2AMLogic/gf180-gate-driver/layout/README.md

# layout — `gate_driver_core` physical layout

First physical layout for the block. It is **generated, not hand-drawn**:
`gate_driver_core.gds` is the byte-reproducible output of running
[`gen_gate_driver_core.py`](gen_gate_driver_core.py) against
[`../design/netlist/gate_driver_core.spice`](../design/netlist/gate_driver_core.spice)
and the gf180mcu PDK, with every polygon produced by `klt`
([klayout-tools](https://github.com/2AMLogic/klayout-tools), this repo's stated
layout tooling).

```
layout/
  gate_driver_core.gds              the layout database (top cell: gate_driver_core)
  gate_driver_core.provenance.json  what it was built from, and by what
  gate_driver_core.checks.json      the checks below, as run on the committed GDS
  gen_gate_driver_core.py           the generator
  check_gate_driver_core.py         the checker
  ground_rail_negative_control.py   known-good/known-bad control for the
                                    ground_rail_isolation check (#132)
  build/                            generator scratch (gitignored)
  common/report_id.py               shared <record-id> minting for the run scripts
  common/power_array_folded.py      folded, cross-row-tied high-m power-array
                                    generator (#254). Kept on purpose for future
                                    power-stage growth; nothing in this block
                                    imports it yet -- see "Folded power-array
                                    generator" below
  common/test_power_array_folded.py unit tests for the above (PDK-free CI;
                                    keeps the kept-on-purpose module tested)
  drc/                              klt drc runner + committed reports (#105)
  lvs/                              klt extract/lvs runner, reference netlist,
                                    extracted DUT netlists, committed reports (#105)
  erc-supply-spec.json              the T1 item-11 klt erc supply spec (#238)
  erc/                              klt erc runner + committed reports (#238)
```

## Status: LVS-match; DRC-clean under the current 34-layer deck (#362, after #358's 1513 violations)

The block now includes all three sub-cells the schematic instantiates —
`level_shifter`, `output_stage`, and (issue #221) `uvlo` (UVLO comparator +
reference, including its bias-resistor network) — not just the first two.

| | |
|---|---|
| Device list matches the schematic | yes — 35 netlist devices → 1769 transistors, the 4-deep `XCCOMP*` MiM series stack, and (#221) 271 `ppolyf_u` resistor primitives, verified |
| Gate/source/drain connectivity matches | yes — verified device-by-device against the netlist |
| Compensation capacitor drawn | **yes (#166)** — four `cap_mim_2f0_m4m5_noshield` plates in series, 5.0 × 5.0 µm each, on the process-fixed Metal4-FuseTop-Metal5 pair; extracted, LVS-matched, and its three interior nodes asserted floating ([below](#the-xccomp-mim-compensation-stack-166)) |
| `uvlo` bias-resistor network drawn | **yes (#221)** — `Rref`/`R1`/`R2`/`Rfb`, each a `klt gen res_array` block of series `ppolyf_u` unit resistors sized to the schematic's own ohms value ([`resistor_array_params`](gen_gate_driver_core.py)); extracted and LVS-matched |
| 3.3 V and 5 V/6 V devices in separate DNWELL regions | yes — verified geometrically (DRM 7.2) |
| DRC | **clean under the current deck (#362).** `status: clean`, 0 violations, klt `0.7.1.dev2599+geaf26f00df36`, deck hash `sha256:0eb6df1b…` (34 layers), report [`20261024-090822-de97a29`](drc/reports/gate_driver_core/20261024-090822-de97a29.drc.json). This is the curated deck's verdict only: the `_MV` rule columns (`DF.6_MV`, `DV.*`, `NW.*_MV`, …) are `unmodeled_rules`, so it is **not** a medium-voltage signoff ([triage](drc/triage_sab_implant.md), [DRC](#drc-klt-drc)) |
| LVS-clean | yes — `status: match`, 2044/2044 devices, 295/295 nets, 25/25 pins, **1 warning-only finding below (unrelated to body ties)** |
| Bulk/body terminals tied | **yes, both flavors (#132)** — every one of the 1769 drawn transistors has a real, drawn, contacted body tie to the schematic's own net (`VDD_LOGIC`/`VDD_DRV` for the 664 PMOS, the deck's global substrate identity for the 1105 NMOS). `klt lvs`'s `device.body_unverified` finding is **gone entirely**, not just reduced (see [Known gaps](#known-gaps) for how the two grounds now compare — revised by issue #221) |
| Post-layout simulation | **pending re-verification against this GDS (issue #222)** — the committed PVT-grid records under `sim/gate-driver-core-drive-postlayout/` were extracted from the pre-#221 (level_shifter + output_stage only) GDS; re-running them against the uvlo-extended extracted netlist is explicitly the next slice of #219, not this issue's scope. Issue #362 regenerated the GDS under the current klt, whose `klt gen` cells differ in size and carry their own implants and body taps, so the extracted parasitics are no longer the pre-#221 ones either: that re-run is still pending, still owed to #222, and was **not** done by #362. [Below](#post-layout-simulation) still describes that pre-#221 evidence as what it is |

The LVS verdict is real (it has a committed negative control, below), and the
old DRC verdict was real *for the rules that deck shipped*, but neither is a
tapeout signoff, and the DRC one no longer holds under the current deck: the deck does not carry rules for this layout's
well/marker layers, and the DRC deck cannot check the guard ring's own
geometry (only its *presence*, drawn to satisfy DN.3 by inspection). Read
"[What the DRC verdict covers](#what-the-drc-verdict-covers)" and "[What the
LVS verdict covers](#what-the-lvs-verdict-covers)" before quoting either.

## Regenerating

```bash
python3 layout/gen_gate_driver_core.py     # rewrites gate_driver_core.gds + provenance
python3 layout/check_gate_driver_core.py --report layout/gate_driver_core.checks.json
```

The generator needs `klt` on `PATH` and a resolvable gf180mcu install (it uses
`klt pdk find`'s resolver — the same one `sim/env.sh` reports). It links
nothing itself: it is standard-library Python that shells out to `klt`.
Re-running it on the same inputs reproduces the GDS **byte for byte**, so
`gate_driver_core.provenance.json`'s `sha256` is a checkable claim, not a
decoration. That cuts both ways: a change to the generator source must leave
`provenance.generator.sha256` matching `sha256sum layout/gen_gate_driver_core.py`,
even when the stream itself is unchanged — otherwise the record names a
generator that is no longer in the tree.

To look at it:

```bash
klayout layout/gate_driver_core.gds       # or: klt render layout/gate_driver_core.gds
klt stats layout/gate_driver_core.gds --per-layer
klt cells layout/gate_driver_core.gds
```

## How it is built

1. **Flatten.** The three sub-cells `level_shifter` (`x1`), `output_stage`
   (`x2`) and (issue #221) `uvlo` (`x3`) are flattened into one device list
   carrying top-level net names, plus one bare-`R` resistor list for `uvlo`'s
   own bias network (`Rref`/`R1`/`R2`/`Rfb`). Internal sub-cell nets keep an
   `x1_`/`x2_`/`x3_` prefix (`x1_nca`, `x2_n3`, `x3_ndiv`, …).
2. **Devices — `klt gen mos_array`, once per netlist device.** A device with
   `W=W nf=N m=M` is drawn as a single unit device folded into `N*M` parallel
   gate fingers of width `W/N` each (`finger_topology: "parallel"`), which is
   exactly what those parameters mean in SPICE: `M` copies of one `W`-wide
   transistor whose width is itself split across `N` fingers, all sharing one
   source, drain and gate strap. `klt extract` reads them back as `N*M`
   parallel transistors, so the layout's transistor count equals the
   netlist's (1769) rather than 35, and the total drawn width is `W*M`
   whatever `N` is.

   Both halves of that handoff are load-bearing and both are confirmed rather
   than assumed (issue #129): SPICE's `W` is a *total* width split across `nf`
   fingers (gf180mcu's model cards pass `w=w nf=nf` into the BSIM core and
   size their drift resistors on `w/nf`; this netlist's own `ad`/`ps`
   expressions use `W/nf`), while `klt gen mos_array`'s `w_um` is the
   *per-finger* width — a `"parallel"` unit device is "one folded transistor
   of width `fingers * w_um`" ([`docs/cli/gen.md`][klt-gen]). Every device in
   the committed netlist has `nf=1`, so this is `M` fingers of width `W` and
   the committed GDS is unaffected;
   [`test_gen_gate_driver_core.py`](test_gen_gate_driver_core.py) pins the
   `nf>1` arithmetic against hand-computed values so a future netlist edit
   that folds a device cannot silently draw an `N`×-too-wide transistor.

[klt-gen]: https://github.com/2AMLogic/klayout-tools/blob/main/docs/cli/gen.md
3. **Resistors — `klt gen res_array`, once per netlist `R` element (issue
   #221).** `uvlo`'s `Rref`/`R1`/`R2`/`Rfb` state an ideal ohms value with no
   drawn geometry, so [`resistor_array_params`](gen_gate_driver_core.py)
   folds each into `num` series `ppolyf_u` unit resistors (gf180mcu's base
   350 Ω/sq poly resistor, `klt gen res_array`'s only flavor this deck
   implements) sized to reproduce that exact value.
4. **Wiring + markers — `klt draw`, once.** One flat cell carrying the Metal2
   net rails, the Metal1 stubs and gate routes, the Via1 stack between them,
   the net-name labels, the voltage-domain marker geometry, every PMOS
   device's well-tie tap, the PCOMP guard ring (#132 — see
   "[Body ties and guard ring](#body-ties-and-guard-ring-132)" below), the
   `XCCOMP*` MiM capacitor stack (#166 — see
   "[The XCCOMP MiM compensation stack](#the-xccomp-mim-compensation-stack-166)"),
   and (issue #221) `uvlo`'s bias-resistor escape wiring — see
   "[Resistor network](#resistor-network-uvlo-221)" below.
5. **Composition — `klt gen-compose`** with `placement.strategy: "explicit"`,
   merging the 35 device cells, the 4 resistor cells and the wiring cell into
   one `gate_driver_core` top cell at the origins steps 2/3 computed.

### Floorplan

Every device is a left-aligned horizontal strip; strips stack upward in
netlist order — the four thin-oxide 3.3 V devices first, then a 20 µm domain
gap, then the thirty-one thick-oxide 5 V/6 V devices (up from twenty pre-#221:
`output_stage`'s ten plus `uvlo`'s own eleven MOSFETs, one of them — `MPD`,
the OUT pulldown — folded `m=800`, by far the widest single strip in the
block). `mos_array` puts a strip's source pad on its left edge, its drain pad
on its right edge and its gate pad on its top edge, which gives a
router-free orthogonal wiring scheme:

- net rails run **vertically on Metal2**, in a channel left of the strips
  (sources and gates) and a channel right of them (drains);
- a **Metal1** stub runs horizontally out of each pad to its rail and drops a
  **Via1**; a gate route leaves the top of its strip and crosses the empty
  channel above it to the left rail;
- each net's left and right rail are tied by one horizontal **Metal1** jumper
  in a cross-over band above the whole stack.

Metal1 stubs therefore pass *under* unrelated Metal2 rails with no via, which
is what keeps the scheme short-free without a router — except for the one
place that stopped being true once `MPD`'s 800-finger fold made the device
column ~900 µm wide (issue #221): a resistor's own escape wire back to its
net's rail is drawn on **Metal3**, not Metal1, specifically because a
same-layer Metal1 crossing against some device's own now-block-wide drain
stub is no longer confined to "empty" territory — see
"[Resistor network](#resistor-network-uvlo-221)" below for the incident this
was fixed against. The result is 1643.84 × 714.78 µm (plus the resistor
column further east, outside that box's own device-rail footprint) —
dominated by `x3_XMPD`, the 800-finger `uvlo` pulldown.

### Resistor network (`uvlo`, #221)

`Interconnect.resistors()` in
[`gen_gate_driver_core.py`](gen_gate_driver_core.py) wires each placed
`res_array` block into its netlist net: a short Metal1 jumper chains
consecutive series units using the block's own reported per-unit pin
coordinates (never a flat run across a whole multi-unit row, which shorts the
chain — see the method's own docstring for the incident that taught this),
and each chain's two open ends drop clear of the block, cross onto Metal3 via
a local Via1/Via2 stack, and run back to the target net's own rail on Metal3
before a final Via2 merges onto the rail. That last leg is Metal3
specifically because the device column is now wide enough (`MPD`'s 800-finger
fold, ~900 µm) that a same-layer Metal1 run back to a rail is no longer
"empty" territory to cross — a first pass drawn on Metal1 shorted `uvlo`'s own
`GND_DRV` to the unrelated level-shifter net `x1_inb`, and a second pass that
moved *only* the horizontal leg to Metal3 but kept a full-height Metal3
*vertical* drop at every end shorted five different nets together instead
(`GND_DRV`/`VDD_DRV`/`x3_ndiv`/`x3_nref`/`x3_uvlo_ok`) — confirmed against
real `klt lvs` runs both times. Every end's entire Metal3 footprint now stays
inside its own narrow, structurally-distinct y-band (no vertical leg at all,
just a landing at the rail's own y), which is what makes two ends'
geometry unable to collide by construction rather than by inspection.

### Body ties and guard ring (#132)

`Interconnect.body_ties()`/`Interconnect.guard_ring()` in
[`gen_gate_driver_core.py`](gen_gate_driver_core.py) draw the substrate/well
tap and PCOMP guard-ring geometry this issue tracks. Every one of the 1769
drawn transistors gets its own tap, and the guard ring is closed and
grounded. What each one does, and the one real (not a layout gap) limitation
that remains, follows from reading `klayout-tools`' own
`extract.py`/`decks/gf180mcu.py` rather than assuming:

- **PMOS well ties — real, per-device, and verified.** Every PMOS device gets
  its own Comp+Nplus+Contact+Metal1 tap, positioned just outside its own
  bbox, inside a redundant Nwell rectangle sized to merge with `klt gen
  mos_array`'s own internal well once flattened, and wired to the device's
  own `VDD_LOGIC`/`VDD_DRV` rail. The Nplus layer is not decorative: gf180mcu's
  curated deck has no distinct tap mask, so a bare Comp+Contact+Metal shape
  inside Nwell is geometrically indistinguishable from ordinary PMOS
  source/drain diffusion and is **not** derived into a tap at all — confirmed
  empirically (a first pass of this generator without the Nplus layer still
  extracted every PMOS body onto its own anonymous net, unchanged). Adding it
  invokes the deck's `tap_nplus` derivation (klayout-tools issue #1084):
  `tap_nplus & active & nwell` reads as a genuine well tie. Since every PMOS
  device's Nwell island is geometrically independent (11 separate, non-
  touching islands — no well-merge geometry across devices), each ties to its
  *own* device's real body net with no cross-device or cross-domain merge
  risk. Confirmed against a real `klt extract` run: `unbiased_pmos_body_nets`
  drops from 660 entries to zero.
- **NMOS substrate ties — real, per-device, and drawn for both domains.**
  Every NMOS device gets its own Comp+Pplus+Contact+Metal1 tap, wired to its
  own group's ground rail (`GND_LOGIC` for the four 3.3 V devices,
  `GND_DRV` for the thirty-one 5 V/6 V devices, up from twenty pre-#221,
  whose taps land inside their own `LVPWELL` patch). `klt`'s gf180mcu deck
  still ties *every* NMOS body, in every layout, to one hardcoded global
  identity (`ExtractionDeck.substrate_net`, via KLayout's `connect_global`)
  regardless of which DNWELL/LVPWELL region a device's diffusion sits in —
  confirmed by reading `extract.py` directly, filed upstream as a generic
  tool gap (klayout-tools
  [#1128](https://github.com/2AMLogic/klayout-tools/issues/1128), per
  CLAUDE.md's friction protocol) — so a real tap drawn anywhere merges
  *every* NMOS body (both domains) onto that one identity. **Issue #221
  update:** under the `klt` build now installed, that identity surfaces
  under the literal name `GND_LOGIC` alone — `GND_DRV` does **not** also
  merge into it (or into `GND_LOGIC`) on any *ordinary* (non-body) terminal.
  An earlier revision of this section (and of `lvs/make_reference.py`)
  claimed the opposite, based on a real extraction of the pre-#221 GDS
  against `klt` 0.2.0; re-running that *exact, byte-identical* GDS against
  the currently-installed build (a different `provenance.deck.content_hash`)
  no longer reproduces the merge — a known, already-tracked `klayout-tools`
  deck-behavior drift (issue
  [#1149](https://github.com/2AMLogic/klayout-tools/issues/1149)). This also
  matches `spec/decision-records/0001` Decision 1 better than the old
  assumption did: the two grounds are one electrical reference node only via
  a pad ring this bare core block does not itself draw (option (c),
  genuinely isolated grounds, was considered and rejected at the *decision*
  level, but a pad-ring tie — not a body-tie side effect — is how that
  decision is meant to be realized). The net effect on body verification is
  unchanged either way: `klt lvs`'s `device.body_unverified` finding is
  **fully resolved** for NMOS, not merely downgraded — a real `klt lvs` run
  against this geometry reports **zero** `device.body_unverified`
  mismatches, on either flavor, at both the pre-#221 and the current device
  count. See "[What the LVS verdict covers](#what-the-lvs-verdict-covers)"
  for the counts, and `lvs/make_reference.py`'s transform 3 for how the
  reference models the body identity now (and `layout/lvs/mk_extracted_dut.py`'s
  T4 for how it is rebound again for simulation, so the testbench still has
  a net literally named `GND_LOGIC`/`GND_DRV` to drive).

  `GND_LOGIC` and `GND_DRV` are, and always were, drawn as separate Metal2
  nets that stay separate in the drawn interconnect end to end, which
  `check_gate_driver_core.py`'s [`ground_rail_isolation`](#why-ground_rail_isolation-exists-132)
  check verifies independently of the extractor's substrate-identity model —
  `klt components` over Metal1/Via1/Metal2 only, net names off the Metal2 text
  layer, no deck globals. That check is the only signal for a real short
  between the two domains that depends on nothing but the drawn metal — `klt
  lvs` and the `devices` check can see one too now that the rails extract
  separately (above), but only for as long as the deck keeps behaving that
  way, and #1149 is the demonstration that it need not; DRC cannot see one at
  all, because two overlapping same-layer shapes raise no spacing violation.
  So it carries its own known-good/known-bad control —
  `ground_rail_negative_control.py` — exactly like the DRC and LVS verdicts
  do.
- **PCOMP guard ring — closed, and contacted on two of its four strokes.** A
  closed rectangular Comp+Pplus ring around `DNWELL_DRV`, offset far enough
  out to leave a real, non-touching gap from both `DNWELL_DRV`'s own marker
  and every well-tie tap (so neither `klt drc` nor
  `check_gate_driver_core.py`'s `dnwell_partition` check folds it into either
  side's component count), and pushed further north than that margin alone
  would place it when the 5 V/6 V group's own bbox sits flush against the
  whole device stack's top edge — clearing `jumpers()`'s own Metal1 band
  (every net's cross-over jumper, drawn above the stack) rather than
  threading a contact row through the narrow gaps between individual jumper
  bars (DN.3 sets no *maximum* ring-to-DNWELL distance, so this is always a
  safe direction to move). The **north and south strokes carry a contact
  row** on a regular pitch, strapped on Metal1 to the 3.3 V group's own
  `GND_LOGIC` rail — this block's substrate reference, since the 3.3 V
  devices sit directly on native substrate outside every DNWELL. The **east
  and west strokes carry no contacts**: every 5 V/6 V device's source, gate
  and drain stub leaves the domain horizontally on Metal1 and crosses those
  two strokes, so a Metal1 strap along them would short all of them
  together. Comp and Metal1 do not interact without a Contact bridging them,
  so the crossings themselves are harmless — the strokes are tied through
  the ring's own continuous p+ diffusion instead of through metal, which
  keeps the ring closed (DN.3) and grounded, at a higher tie resistance on
  the two vertical strokes than a fully-strapped ring would have.
  Distributing contacts along them needs a Metal2 crossover per stub, i.e. a
  routing-channel redesign — recorded as a residual gap below rather than
  bolted on here.

### The XCCOMP MiM compensation stack (#166)

`Interconnect.mim_caps()` draws the level shifter's feedforward compensation
capacitor — since issue #192 /
[decision record 0014](../spec/decision-records/0014-xccomp-mim-density-and-series-stack.md),
**four** `cap_mim_2f0_m4m5_noshield` devices in series (`XCCOMP1`..`XCCOMP4`),
5.0 µm × 5.0 µm each. It is drawn as plain `klt draw` rectangles rather than by
a generator: `klt gen` ships no capacitor generator (`klt gen --list`:
`mos_array`, `diff_pair`, `guard_ring`, `res_array`, `esd_device`, `bjt_array`,
`bond_pad`, `resistor_strip`), which is the friction this device ran into.
What makes the rectangles a *device* rather than decoration is that every layer
is one `klt`'s own gf180mcu **extraction** deck recognises this capacitor on
(`decks/gf180mcu.py`'s `EXTRACTION_DECK.capacitors`, transcribed from the PDK's
own `mimcap_extraction.lvs`): FuseTop (75/0) top plate, `CAP_MK` (117/5) +
`MIM_L_MK` (117/10) recognition markers, Metal4 (46/0) bottom plate, Via4
(41/0) to Metal5 (81/0) on top.

**The metal pair is not a layout choice.** `gf180mcuD` is a 5-metal DRM
Option-B build, so `topmin1_metal` *is* Metal4 and the MiM sits on
Metal4-FuseTop-Metal5 and nowhere else (`../design/level-shifter-partition.md`,
corrected by #194 — the older "deferred to layout" note was wrong).

**Series topology: every interior node is a shared plate.** The four
capacitors alternate orientation, so the three internal nodes need no via at
all:

```
                nccomp1                       nccomp3
             (Metal5 strap)                (Metal5 strap)
            +--------------+              +--------------+
            |              |              |              |
  x1_ncb --[C1]          [C2]           [C3]           [C4]-- IN_DRV
  (Metal4)   |              |              |              |    (Metal4)
             +--------------+--------------+              |
                        nccomp2                           |
                  (one Metal4 polygon:                     `-- Metal4 stub
                   C2 and C3's bottom                          -> Via3
                   plates, bridged)                            -> Metal3
                                                                -> Via2
                                                                -> Metal2 rail
```

That is what makes `nccomp1`/`nccomp2`/`nccomp3` **floating by construction
rather than by inspection** — the correctness risk #166 called out. Each one is
a single metal polygon carrying two capacitor plates and nothing else: no via
lands on it, no strap reaches it, there is no shield around it. There is no
geometry that *could* tie one of them to something, so "did we accidentally
strap a floating node?" has a structural answer here, not only a visual one.
Both chain ends therefore come out on Metal4 and escape the same way, through
Via3 → Metal3 → Via2 down to the Metal2 rail their net already has.

The Via4s that contact the top plates do not short them to the bottom plates
either, and that is the extractor's own model rather than an assumption: `klt
extract` cuts each top-plate Via4's overlap with the recognised bottom plate
out of the generic Via4 connectivity, precisely so a DRM-legal MiM stack does
not read as a plate-to-plate short.

**DRM 10.4.2 "MIM Option B" rules honoured.** Three of them the curated DRC
deck actually checks, and the run below is clean against all three; the rest
are honoured because the DRM states them, whether or not a deck reads them
today:

| Rule | What it asks | How this layout meets it | Checked by `klt drc`? |
|---|---|---|---|
| MIMTM.1 | 1.2 µm bottom-plate spacing to adjacent bottom-plate or routing Metal4 | row pitch is 6.2 + 1.2 µm; the only other Metal4 anywhere in the block is each end plate's own escape stub, part of that plate's own polygon | yes — `mim.space.1` (including its peer-to-peer "adjacent MiM" half) |
| MIMTM.2 | 0.4 µm *virtual* bottom-plate overlap of Via4 | Via4 sits at the plate centre, ~2.97 µm inside | yes — `mim.enclosing.via4.1` |
| MIMTM.3 | 0.6 µm bottom-plate overlap of the top plate | the Metal4 plate is the 5.0 µm FuseTop plate grown by exactly 0.6 µm on all four sides ⇒ 6.2 × 6.2 µm | yes — `mim.enclosing.fusetop.1` |
| MIMTM.5 | 0.4 µm top-plate overlap of Via4 | ~2.37 µm | no rule in this deck |
| MIMTM.8a | 25 µm² minimum MiM area | 5.0 × 5.0 = 25 µm² exactly, taken from the netlist's own `c_width`/`c_length` and asserted by the generator rather than assumed | no rule in this deck |
| MIMTM.10 | "Via(n−2)" (Via3, on this 5LM stack) may not touch the bottom plate | an end plate's Via3 sits on a stub 4.35 µm from the plate centre — outside the DRM's own *virtual* bottom plate (FuseTop sized by 1.06 µm ∩ Metal4, i.e. a 7.12 µm square) | no rule in this deck |
| §10.4.2 guidance | no matching-sensitive analog circuitry underneath | the whole row sits north of every other drawn shape in the block, over bare substrate — nothing at all is underneath it | n/a |

The row is 28.4 µm × 6.2 µm (≈ 176 µm² of plate metal), placed 12 µm above the
guard ring's own north stroke, which is what grew the block from
553 × 494 µm to 553 × 513 µm. Its Metal3 escape lanes cross over the whole
Metal2 rail field without a single via into it except the two deliberate Via2
taps, so the drawn Metal1/Via1/Metal2 interconnect the
[`ground_rail_isolation`](#why-ground_rail_isolation-exists-132) check rules on
is byte-for-byte unaffected — still 18 nets, 18 components.

**Capacitance.** `klt extract` measures 5.4516e-14 F per plate pair, which is
the extraction deck's two-term MiM model over the drawn overlap:
`1.99e-15 F/µm² × 25 µm² + 2.383e-16 F/µm × 20 µm` (both coefficients from the
PDK's own `sm141064.ngspice` `.subckt cap_mim_2f0fF`). Four in series is
13.6 fF, inside decision record 0014's 12–14 fF target.
[`lvs/make_reference.py`](lvs/make_reference.py)'s transform 6 restates the
*same* two-term model over the *schematic's* own `c_width`/`c_length`, so LVS
compares a measured value against a derived one rather than against a value
copied back out of an extraction — and it is a real comparison, not a
formality: substituting the area-only value (4.975e-14 F) makes `klt lvs` drop
from `match` to `mismatch` with `device.unmatched` on every capacitor.

### Two-rail / DNWELL partition

Per [`../spec/gate-driver.md` §2.4](../spec/gate-driver.md) (DRM 7.2) and the
device table in
[`../design/level-shifter-partition.md`](../design/level-shifter-partition.md):

- the twenty `*_06v0` thick-oxide devices sit inside one `DNWELL` (12/0)
  region — `DNWELL_DRV` — with `Dualgate` (55/0) over the same group and an
  `LVPWELL` (204/0) patch under each thick-oxide nfet;
- the four `*_03v3` thin-oxide devices sit **entirely outside any DNWELL**,
  which is §2.4's second allowed option and the one the partition table
  already committed to.

No DNWELL is shared between the two flavors, and there is exactly one DNWELL
polygon in the design.

## Checks

`check_gate_driver_core.py` runs five checks against the *committed* GDS via
`klt` — it never reads the generator's internal state, so it audits the stream
rather than replaying how it was made. Its output is committed as
`gate_driver_core.checks.json`.

| Check | What it does |
|---|---|
| `devices` | `klt extract --deck gf180mcu`, then compare every extracted transistor against the flattened netlist: a device with `nf=N m=M` must appear as `N*M` transistors of width `W/N` and the same L, whose gate net and unordered source/drain pair match. Passing means 1769/1769 with no missing and no unexpected device (up from 959/959 pre-#221; resistors are audited by `klt lvs` against `lvs/make_reference.py` instead of by this check — see that script's own module docstring). |
| `mim_stack` | The same extraction, read for the four `XCCOMP*` MiM capacitors (#166). Asserts the count, each device's *extracted* `c_width`/`c_length` against the schematic's, that walking from the schematic chain's first node traverses every capacitor exactly once and lands on its last node (a *parallel* stack has the identical device count and plate geometry — only the walk tells them apart), and that every interior node touches exactly two capacitor terminals, no transistor terminal and no top-level pin. That last ruling is the mechanical form of "`nccomp1`..`3` are floating" — see [below](#why-mim_stack-exists-166). |
| `dnwell_partition` | `klt components` with `DNWELL` declared *both* as a conductor and as the via joining it to `Comp`, so every active region a DNWELL polygon overlaps lands in the DNWELL's own component. It counts **gate-bearing** active (`Comp AND Poly`, one shape per finger, #362) so the verdict does not depend on how many body taps the generator and `klt gen mos_array` draw: asserts exactly 1765 gate regions inside (the fingers of the 31 5 V/6 V devices) and 4 outside (the 3.3 V devices'). |
| `ground_rail_isolation` | `klt components` over the **routed metal only** — Metal1 (34/0) and Metal2 (36/0) as conductors, Via1 (35/0) as the sole bridge, net names from the Metal2 text layer (36/10). No deck, no device recognition, no substrate global. Asserts no component carries two distinct net names, every routed net resolves to exactly one component, and `GND_LOGIC`/`GND_DRV` land in different components — 25 nets, 25 components (up from 18/18 pre-#221's uvlo/resistor addition). See [why this check exists](#why-ground_rail_isolation-exists-132). |
| `voltage_domain` | `klt layers --flattened` for the marker layers, plus the `voltage_domain_warnings` block `klt extract` returns — see the deck caveat below. |

#### Why `ground_rail_isolation` exists (#132)

Drawing real substrate ties for *both* grounds looked, at the time, like it had
removed both automated signals that used to distinguish them at once:

* `klt extract` — and therefore `klt lvs` — reported `GND_LOGIC` and `GND_DRV`
  as one merged net no matter what the metal did, because gf180mcu's curated
  deck ties every NMOS body to one hardcoded substrate global
  ([klayout-tools #1128](https://github.com/2AMLogic/klayout-tools/issues/1128));
* the `devices` check normalised that same merge away (a `_canon_net` helper)
  so it could still compare against the schematic.

**Issue #221 revised the first half of that, and removed the second.** Under
the `klt` build now installed, the deck's substrate global surfaces as
`GND_LOGIC` on the NMOS *body* terminal only; `GND_DRV` extracts as its own,
separate net on every ordinary terminal, on the *byte-identical* pre-#221 GDS
as well as the current one — a `klayout-tools` deck-behavior drift
([#1149](https://github.com/2AMLogic/klayout-tools/issues/1149)), written up in
[Known gaps](#known-gaps). So `klt lvs` and the `devices` check can both see a
cross-domain short again today, and `check_gate_driver_core.py`'s device
comparison now compares the two ground names verbatim rather than collapsing
them — the collapse would otherwise have made a device wired to logic ground
indistinguishable from one wired to driver ground, which is exactly the
cross-domain property this block exists to get right
(`DeviceKeyGroundDomainTest` in
[`test_gen_gate_driver_core.py`](test_gen_gate_driver_core.py) pins the
distinction, since a correct GDS cannot demonstrate it). The body-only form of
the same normalisation survives in `lvs/make_reference.py`'s `_body_net()`,
for `klt lvs`, which *does* compare the bulk terminal.

`ground_rail_isolation` keeps its full value regardless, for two reasons.
It is the only one of the three signals that rules on the **drawn metal**
rather than on the extractor's model of the substrate — and #1149 is itself the
demonstration that that model can change under a fixed design, without the
design changing at all. And DRC covers none of it either way: two same-layer
shapes on **different** nets that overlap merge into one polygon, so no spacing
rule fires — the failure is invisible to a spacing check by construction. Its
ruling is stated over *all* nets, not just the two grounds, so an
`OUT`/`VDD_DRV` short fails it the same way.

Its PASS has a committed negative control, like the DRC and LVS verdicts:

```bash
python3 layout/ground_rail_negative_control.py    # needs klt, no PDK
```

[`ground_rail_negative_control.py`](ground_rail_negative_control.py) `klt
draw`s a two-rail fixture in two variants — isolated, and bridged by a Metal1
bar through two Via1 cuts (every shape individually legal, i.e. exactly the
case DRC cannot see) — and runs the **same** layer stack and the **same**
verdict function the block's own report was produced with. It must pass the
first and fail the second, naming both rails. The verdict function itself is
pure (response dict in, check record out), so its failing directions are also
pinned in CI by
[`test_gen_gate_driver_core.py`](test_gen_gate_driver_core.py) against
synthetic `klt components` responses — those cases cannot be produced from the
committed, correct GDS.

#### Why `mim_stack` exists (#166)

The compensation stack's three interior nodes are floating plate-to-plate nets
with no DC path. A stray strap, tie or shield on one of them changes the
effective series capacitance — and would silently invalidate decision record
0014's PVT evidence — without necessarily failing anything else: DRC rules on
geometry, not on intent, and `klt lvs` compares against a reference derived
from the same netlist, so a *short* shows up there but a connection to an
otherwise-unused node need not.

`mim_stack` states the property mechanically instead of leaving it to
inspection: interior node ⇒ exactly two capacitor terminals, no transistor
terminal, no pin. Like `ground_rail_isolation`, its verdict function is pure
(extraction facts in, check record out) precisely so its *failing* directions
— none of which the committed, correct GDS can produce — are exercised in CI
from synthetic inputs
([`test_gen_gate_driver_core.py`](test_gen_gate_driver_core.py)'s
`MimStackVerdictTest`: a missing capacitor, a parallel stack with the right
device count, an interior node landing on a transistor, an interior node
promoted to a pin, and a plate drawn at the pre-#192 3.0 × 3.0 µm size).
`Interconnect._mim_series_chain`'s own refusals — a broken link, a loop, an
odd-length chain, an undrawable model, an endpoint with no rail — are pinned
next to them.

This is a device-count/connectivity check, **not** LVS — it compares the
extraction against a device list derived from the netlist by the generator's
own parser. The independent comparison is
[`klt lvs`](#lvs-klt-extract--klt-lvs) below.

### Generator unit tests

```bash
python3 layout/test_gen_gate_driver_core.py        # or: npm run test:layout
```

`check_gate_driver_core.py` imports `parse_netlist` from the generator, so it
derives its *expected* device list from the same interpretation the generator
drew from: a misreading of `W`/`nf`/`m` would be common-mode and the `devices`
check would pass on a wrong layout (issue #129).
[`test_gen_gate_driver_core.py`](test_gen_gate_driver_core.py) is the
independent half — hand-computed expectations for that arithmetic, with no
number derived by calling the helpers under test. It is stdlib-only and needs
neither `klt` nor the PDK, so it runs on every PR in CI's `test` job.

## Signoff checks: DRC, LVS, post-layout simulation (#105)

Both runners live next to the layout, mint an append-only
`<YYYYMMDD>-<HHMMSS>-<short-git-sha>` record id (the same convention
[`sim/README.md`](../sim/README.md) defines for simulation evidence), and
**never overwrite an existing report** — a re-run mints a new one.

```bash
python3 layout/drc/run_drc.py layout/gate_driver_core.gds        # -> layout/drc/reports/
python3 layout/lvs/run_lvs.py layout/gate_driver_core.gds        # -> layout/lvs/reports/
python3 layout/lvs/run_pex_extract.py layout/gate_driver_core.gds  # parasitic extraction

# the two controls that make the verdicts above mean something:
python3 layout/drc/deck_negative_control.py
python3 layout/lvs/lvs_negative_control.py
```

### Stored vs committed signoff outputs (#348)

Most of what a signoff run writes is never read back from git, so it goes to
the fleet artifact store through `layout/common/signoff_store.py` (the
`sim/harness/evidence_store.py` writer, `klt artifact put`) and git keeps one
`manifests/artifacts/layout-<tool>-<block>-<record-id>.manifest.json`; each
entry's `name` is the `layout/<tool>/reports/<block>/<record-id>.*` path the
bytes would have had. Runners **fail closed**: with no broker, no `klt
artifact`, or any failed put they exit `10` and commit nothing (they check
before running `klt`, and write committed files only after the store
succeeded). `KLT_ARTIFACT_BROKER` must be set, as for `sim/`.

| output | where | why |
|---|---|---|
| `<id>.drc.json`, `<id>.lvs.json`, `<id>.erc.json` of a block run | **git** | `verification/signoff/check_tier_report.py` opens cited envelopes from the tree |
| `layout/lvs/gate_driver_core.{extracted,extracted-rc,ref}.spice` | **git** | `.include`d by sim DUTs; not writer outputs |
| the extraction JSONs a DUT header or CI step names (`ci.yml` re-derives DUT netlists from two) | **git** | inputs, committed deliberately (below) |
| `*.drc.txt`, `*.lvs.txt`, `*.erc.txt`, `*.lvs-request.json`, `*.erc-request.json` | store | nothing reads them from git |
| per-run `<id>.extracted.spice`, `<id>.extract.json`, `<id>.pex-extract.json` | store | uncited unless promoted |
| all negative-control output (`deck-negative-control`, `negative-control/`) | store | evidence for the control's verdict only |

Staged bytes remain under `layout/build/evidence/<bench>/<record-id>/`
(git-ignored). Fetch a stored file with `klt artifact get <manifest>#<name>`.

**Promoting an extraction.** When a DUT header or CI step starts to consume an
extraction, copy the staged (or fetched) file to
`layout/lvs/reports/<block>/<same name>`, commit it, and cite it from the
consumer in the same PR. That commit is the decision; the runners never do it.
Request records are written next to the staged files, so their relative paths
point at the staging directory, not at `reports/`.

### Reproducibility: pin the `klt` install (#190)

Every DRC/LVS report's `provenance.deck.content_hash` names the exact
`klayout-tools` deck build a verdict was produced against — it is not
decorative. **A `klt` install resolved against an unpinned `main` (e.g. a
bare `uv tool install git+https://github.com/2AMLogic/klayout-tools` with no
`@<rev>`/`?rev=` qualifier) can silently pick up a different deck build
between two runs, weeks or hours apart, with an unchanged `klt --version`**
(this repo observed exactly that: the same committed
`gate_driver_core.gds`, re-extracted against two different unpinned installs,
produced two different `provenance.deck.content_hash` values and flipped
`device.body_unverified` from zero back to 959). Filed upstream, generically,
per CLAUDE.md's friction protocol:
[klayout-tools#1149](https://github.com/2AMLogic/klayout-tools/issues/1149)
("gf180mcu deck: substrate/well-tap recognition behavior changed between deck
builds, silently invalidating previously-passing LVS evidence") — already
fixed there by
[klayout-tools#1154](https://github.com/2AMLogic/klayout-tools/pull/1154),
which adds `--check`/`--rerun` to `klt extract` so a caller can ask "does
this committed report still reproduce against the deck installed *right
now*" without re-deriving the hash by hand (`klt drc`/`klt lvs` already had
this, issue #1106).

Pin the install to a specific revision rather than letting it float:

```bash
uv tool install --from "git+https://github.com/2AMLogic/klayout-tools@<rev>" klayout-tools
```

The reports linked below (`20260818-082605-cf3a1c7` DRC,
`20260818-082329-cf3a1c7` LVS) were produced against
`klt 0.2.0` / `klayout 0.30.10` / deck content hash
`sha256:6a323622d93c1b4716a7874c37ee3d825bd08398c3c030c85175e44e2cc229a3` — the
same triple as the `dc66e49` reports they supersede, confirming this design's
own body-tie geometry (issue #132) is unaffected and the earlier mismatch
some agents observed was purely an install-drift artifact, not a regression
in this repo. Before trusting a *new* DRC/LVS run against a differently-timed
`klt` install, diff `provenance.deck.content_hash` against the value above; a
mismatch means the deck build itself has moved, not that this layout changed.

### DRC (`klt drc`)

**Current status (#362): clean.** `python3 layout/drc/run_drc.py layout/gate_driver_core.gds`
with klt `0.7.1.dev2599+geaf26f00df36`, `PDK=gf180mcuD`, deck `gf180mcu` hash
`sha256:0eb6df1bafc5106ec50bd58479dbd7cda36bb685f1ef18cd3a2244a6e7e48666`
reports `status: clean`, 0 violations
(`drc/reports/gate_driver_core/20261024-090822-de97a29.drc.json`; 23 layers
checked, 27 rules skipped as inapplicable to this layout). The deck was not
relaxed. It supersedes the #358 report
(`drc/reports/gate_driver_core/20261024-075045-f4914d9.drc.json`, 1513
violations on the previous GDS, kept as append-only evidence;
[`drc/triage_sab_implant.md`](drc/triage_sab_implant.md) classifies every one
as a real violation of that GDS).

What changed to get here, all in `gen_gate_driver_core.py`:

- **Regenerating with the current klt fixed most of it.** The 1513 violations
  were measured on a GDS generated by klt 0.3.0. Current `klt gen` emits the
  SAB geometry (Poly2 enclosure, contact spacing, row spacing) and the
  source/drain implants itself (`drc_hints.sd_implant_present`), which cleared
  the 542 + 542 + 246 SAB and 35 `comp.coverage.1` violations with no generator
  change; the same klt also draws contacted body taps of its own at the
  corners (and the middle of a wide cell) of every `mos_array` cell.
- **Tap implants enclose their Comp** by `TAP_IMPLANT_ENCLOSURE_UM` (0.16 µm,
  NP.3/PP.3): the per-device taps and the guard ring (`nplus`/`pplus`
  `.enclosing.comp.1`, `pplus.enclosing.comp.far.1`). The implants still cover
  Comp only where a tap is, so `klt extract`'s
  `tap_nplus & active & nwell` / `tap_pplus & (active - nwell)` derivations
  find the same body ties. `TAP_LEFT_OFFSET_UM` went 0.6 → 0.8 so the enlarged
  tap implant clears the cell's own corner-tap implant by `pplus.space.1`.
- **The cells' own tap pads are routed around** (`native_tap_pads`): a gate
  route that would cross one now goes up on Metal2 for that strip
  (`_gate_bar_hits_native_tap`); left on Metal1 it shorted the gate onto the
  well/substrate tie and `klt extract` merged `x2_n3`/`VDD_DRV` and
  `x2_n4`/`GND_DRV`/`x3_lockout`. nfet corner pads are strapped to the body net
  (`_strap_native_taps`) so `klt erc`'s `substrate_gnd_logic` assertion still
  finds no untied tap, and `_via_stack` bridges two landings on one rail that
  sit closer than `metal1.space.1`.

Historical report (superseded, kept as append-only evidence):
[`layout/drc/reports/gate_driver_core/20260826-044706-fdf17d9.drc.json`](drc/reports/gate_driver_core/20260826-044706-fdf17d9.drc.json)
— `status: clean`, `violation_count: 0`, klt 0.3.0 and its 18-layer deck, run against the
stream whose content hash is the committed `gate_driver_core.provenance.json`'s
(issue #221: the `uvlo` sub-cell and its bias-resistor network are now part of
the drawn block too — still DRC-clean, including all three MIM Option B rules
the deck ships). Re-running `klt drc` on the committed GDS reproduces that
report byte for byte.

#### What the DRC verdict covers

`klt drc`'s own report enumerates its scope, and this is the part to read
before quoting "DRC clean":

| Field in the report | Value here | What it means |
|---|---|---|
| `coverage.deck_scope` | 10 DRM sections (Nwell, Comp, Poly2, Contact, Metaln, Vian, MetalTop, MIM option B, DRC_BJT, bond pad) | the deck is a **curated subset** of the gf180mcu DRM, not the whole manual |
| `coverage.layers_checked` | **15** (21/0, 22/0, 30/0, 33/0, 34/0, 35/0, 36/0, 38/0, 40/0, 41/0, 42/0, 46/0, 55/0, 75/0, 81/0) | the deck layers this stream actually uses — unchanged in count by issue #221's resistor network (it draws only `poly2`/`contact`/`metal1`/`metal2`/`metal3`, all already in this set) |
| `coverage.layers_in_stream_without_rules` | **9 — 12/0 `DNWELL`, 31/0 `Pplus`, 32/0 `Nplus`, 36/10, 49/0, 110/5, 117/5 `CAP_MK`, 117/10 `MIM_L_MK`, 204/0 `LVPWELL`** | `31/0`/`32/0` come from issue #132's per-device body-tie taps (`Pplus` for every NMOS substrate/LVPWELL tie and the guard ring, `Nplus` for every PMOS well tie — gf180mcu's `tap_nplus`/`tap_pplus` derivation, klayout-tools #1084); `117/5`/`117/10` are issue #166's MiM device-recognition markers; `49/0`/`110/5` are new as of issue #221 — the `ppolyf_u` resistor device-recognition markers `klt gen res_array` draws for `uvlo`'s bias network. This curated *DRC* deck checks no rule against any of them (only the *extraction* deck reads them, and that is exactly their job). The DNWELL/LVPWELL spacing and enclosure rules of DRM 7.2, and the guard-ring's own geometry, remain **not** checked by this verdict |
| `coverage.rules_skipped` | **4** (metaltop width/space, pad, BJT) | down from 23: only rules for layers this layout still does not draw. The MIM Option B and Metal3/Metal4/Metal5 + Via2/Via3/Via4 rules that dominated the old skip list are live now |
| `coverage.voltage_domain_warnings` | 1 | the deck models `DF.1a`/`DF.3a` COMP width/space as `_LV`/`_MV` pairs scoped to the `Dualgate` marker, but **every other rule still applies 3.3 V thresholds to thick-oxide geometry** — see the `Dualgate` gap below |

The table above describes the *historical* 20260826 report. The old deck had no
`SAB`, `comp.coverage`, `nplus/pplus.enclosing.comp` rules, so SAB spacing,
implant enclosure and COMP implant coverage were **not checked** by the old
verdict; the current deck checks them and fails (see above).

So, for the historical report: **clean against the rules that deck shipped, with the medium-voltage
thresholds and the well/marker-layer rules outside it.** That is the honest
scope, and it is exactly the friction CLAUDE.md predicts for the first block
to use the 5 V/6 V flavors.

#### Is `clean` a real verdict?

`layout/drc/deck_negative_control.py` answers that without trusting the
result: it draws two Metal1 rectangles 0.05 µm apart with `klt draw` (which
applies no rule checking) and runs the **same** deck through the **same**
`run_drc.py`. The deck flags it — `metal1.space.1 × 1`, committed as
[`layout/drc/reports/deck-negative-control/`](drc/reports/deck-negative-control/).
A deck that returns `clean` for everything would fail that control.

### LVS (`klt extract` + `klt lvs`)

Latest report: [`layout/lvs/reports/gate_driver_core/20261024-090826-de97a29.lvs.json`](lvs/reports/gate_driver_core/20261024-090826-de97a29.lvs.json)
— engine **`klayout`**, `status: match` (same 3 warning-only findings as
`20261024-075048-f4914d9`) against the #362-regenerated GDS; the table below
is the issue #221-extended GDS (`level_shifter` + `output_stage` + `uvlo`, plus
`uvlo`'s bias-resistor network):

| | layout | reference | matched |
|---|---|---|---|
| devices | 2044 | 2044 | **2044** |
| nets | 295 | 295 | **295** |
| pins | 25 | 25 | **25** |

Device count is 1769 transistors + the four `XCCOMP*` MiM capacitors (#166)
+ 271 `ppolyf_u` resistor primitives (issue #221 — `uvlo`'s `Rref`/`R1`/`R2`/
`Rfb`, each folded into a `klt gen res_array` block of series unit
resistors). Net count is 25 named nets + the MiM stack's three interior
nodes + each resistor's own `num - 1` interior series nodes, matched
**topologically**: the layout labels none of them, so `klt extract` leaves
them internal and unnamed, and the comparer has to find each chain itself,
anchored at its own named ends.

The reference netlist ([`lvs/gate_driver_core.ref.spice`](lvs/gate_driver_core.ref.spice))
is **generated, never hand-edited** — `lvs/make_reference.py` derives it from
`design/netlist/gate_driver_core.spice` and applies mechanical transforms
that the extraction deck's own capabilities force (finger expansion, generic
`nfet`/`pfet` device class, NMOS body → the deck's one global substrate
identity — issue #132's own discovery, revised by issue #221 (see below) —
PMOS body → the schematic's own `VDD_LOGIC`/`VDD_DRV` assignment, issue
#166's MiM stack restated through the deck's own two-term capacitance model,
and issue #221's bare-`R` resistors restated as one 3-terminal `ppolyf_u`
device per drawn series unit). `run_lvs.py` regenerates it before every run,
so a stale reference cannot quietly pass, and `lvs/test_make_reference.py`
pins each transform's structural facts in CI without needing `klt` or the
PDK.

**Issue #221 revision: `GND_LOGIC` and `GND_DRV` no longer merge on ordinary
terminals.** A prior revision of this reference folded both ground names
into one net everywhere either appeared (not just on a device's body
terminal), reasoning that real substrate-tie geometry for both grounds
(issue #132) made the deck's global substrate identity absorb both
transitively. Re-running the *exact, byte-identical, previously-`match`* GDS
this section used to cite against the `klt` build now installed no longer
reproduces that merge: `GND_DRV` extracts as its own, separate, unmerged pin
on every terminal, on both the pre-#221 GDS and this issue's UVLO-extended
one. This is a known, already-tracked `klayout-tools` deck-behavior drift
(issue #1149, filed the same day the old evidence was recorded), not a
regression in this layout — see `make_reference.py`'s own docstring
(transforms 3 and 5) for the full account, including why removing the merge
also matches `spec/decision-records/0001`'s own architecture better (the two
grounds are one electrical node only via a pad ring this bare core block
does not itself draw). Only the NMOS *body* terminal still canonicalizes, to
the literal net `GND_LOGIC` (the deck's global identity's current real
name).

#### What the LVS verdict covers

`mismatch_count: 1`, **severity `warning`, not a real topology
difference** — listed here rather than dropped:

| Category | Side | Finding |
|---|---|---|
| `topology` | layout | a device class with no counterpart on the other side, **and no devices of that class extracted either** — klt states in the finding itself that this is not a real topology mismatch (it is one of the deck's unused classes: BJT, diodes; the resistor class left that list as of #221, which draws real devices on it, same as the MiM cap class did as of #166). Pre-existing, unrelated to body ties — present in every report this repo has committed for this design |

The `device.body_unverified` finding this table used to carry — 660 PMOS
bodies, then, after a first pass of issue #132's own geometry, 299 NMOS
bodies — is **gone entirely** as of issue #132, and stays gone through issue
#221's much larger device count: `match` here now means drain/gate/source
connectivity, device sizing, *and* body bias for every one of the 1769
transistors and 271 resistor primitives all match the schematic. See
"[Body ties and guard ring](#body-ties-and-guard-ring-132)" above for why
drawing a real NMOS substrate tie for both grounds resolves this rather than
merely downgrading it.

#### Is `match` a real verdict?

`layout/lvs/lvs_negative_control.py` deletes exactly one reference device
card and re-runs the identical comparison, flipping the verdict to
`status: mismatch` with a `device.unmatched` error and one fewer reference
device. Committed as
[`layout/lvs/reports/negative-control/`](lvs/reports/negative-control/) (from
the pre-#221 device count; the mechanism — one card removed, one
`device.unmatched` finding — is unaffected by the design growing). A
comparator that pattern-matched a summary rather than comparing device by
device would not catch a one-device delta. (The expected count is read off
the reference rather than written into the control, so it keeps saying "one
fewer than whatever the schematic has" as the design changes.)

A second, ad-hoc perturbation confirms the same for the MiM stack's
*parameters* rather than its device count: substituting the area-only
capacitance (4.975e-14 F, i.e. dropping the deck's perimeter/fringe term) into
the reference flips the verdict to `mismatch` with `device.unmatched` on every
capacitor. So the value
[`lvs/make_reference.py`](lvs/make_reference.py) derives is load-bearing, not
decoration.

### Supply-island ERC (`klt erc`, #238)

T1 item 11 (power delivery, structural — klayout-tools
`docs/design-evidence-tiers.md`, added 2026-09-17) grades the *structural*
supply question: is every supply actually connected to what it powers, as
one electrical island per supply? For an analog block it rests on a
`klt erc` supply-spec run plus the item-4 LVS reference having carried the
supply nets in its compare.

Latest report:
[`layout/erc/reports/gate_driver_core/20260921-155739-3249587.erc.json`](erc/reports/gate_driver_core/20260921-155739-3249587.erc.json)
— `erc_status: clean`, `erc_finding_count: 0`, every one of the four
declared supplies (`VDD_LOGIC`/`GND_LOGIC`/`VDD_DRV`/`GND_DRV`,
[`erc-supply-spec.json`](erc-supply-spec.json)) resolving to exactly one
electrical island: zero `erc.unconnected_net`, zero `erc.supply_short`. The
report's `provenance.input.content_hash` is the committed GDS's own sha256
(`54f02626…`, matching `gate_driver_core.provenance.json`). The item-4 LVS
half is already on the record: all four supply nets appear in
`20260826-062806-a7dcce1.lvs.json`'s `net_correspondence`, each paired
layout↔reference.

Two things the report's clean read depends on, stated here because a
future reader re-running it must know them:

- **`--deck gf180mcu` is load-bearing.** `klt erc`'s connectivity graph is
  device-blind, and the `uvlo`'s bias strings (`Rref`/`R1`/`R2`/`Rfb`) are
  drawn `ppolyf_u` devices that deliberately span `VDD_DRV` and `GND_DRV`.
  Without the curated deck's device-marker subtraction those resistor
  bodies read as wires and the run reports a false `erc.supply_short`
  between the two supplies (the mirror-image artifact documented upstream
  as klayout-tools [#2183], fixed by the `devices[]`/`--deck` mechanism —
  [#2205]/[#2217]). With `--deck`, exactly the 271 unit-resistor bodies
  (9011.52 µm² of RES_MK-marked poly) and the XCCOMP MIM plates are carved
  out, echoed in `provenance.devices` with `source: "deck"`. A klt build
  predating `--deck` (before klayout-tools#2217) exits 2 on this runner —
  that is a tool-version fact, not a layout failure.
- **`erc.missing_tie` is computed — zero findings** — the spec declares
  `ties[]` for every well/substrate class this block draws (issue #256):
  the two split-rail Nwell classes selected apart by the Dualgate marker
  (`well_requires`/`well_excludes`, klayout-tools#2339 — 1 island on
  VDD_LOGIC, 14 on VDD_DRV), the seventeen LVPWELL patches on GND_DRV, and
  the native substrate under the 3.3 V logic asserted with `well_layer:
  null` + `well_boxes` (klayout-tools#2255). Every class grades `checked`
  with none skipped, and the guard ring and resistor block are
  deliberately outside the asserted regions — see the spec's `_comment`
  for the full reasoning and the per-class counts. Declaring ties requires
  a klt build at or after klayout-tools `2c1bd1b3` (isolated tie extraction
  #2169). The well-tie evidence that predates the declaration (item-4 LVS
  closure: every one of the 1769 drawn transistors has a real, drawn,
  contacted body tie to the schematic's own net, `klt lvs` reports zero
  `device.body_unverified` and a 2044/2044 device, 295/295 net, 25/25 pin
  match, plus the drawn guard/substrate-tap rings #183) still stands beside
  it.

Re-running produces a new append-only report (never overwrites this one):

```bash
python3 layout/erc/run_erc.py layout/gate_driver_core.gds
```

The committed report was produced by
`klt 0.5.0+gb15edf5e3a2e.dirty` (klayout-tools at git rev `b15edf5e`, the
recorded revision where `--deck` device-marker auto-detection ships;
reproduce the build with `uv tool install --from
"git+https://github.com/2AMLogic/klayout-tools@b15edf5e"` or a scratch
`uv venv`, and/or pass `--klt <path>` to the runner). The PATH-installed
pin (`0.5.0+g2b1e55e51bb8.dirty` at the time of this report) predates
`--deck` — before trusting a re-run, diff the report's
`provenance.deck.content_hash` and `provenance.klt_version` against what
is actually installed, per the pinning section above.

[#2183]: https://github.com/2AMLogic/klayout-tools/issues/2183
[#2205]: https://github.com/2AMLogic/klayout-tools/pull/2205
[#2217]: https://github.com/2AMLogic/klayout-tools/pull/2217

### Post-layout simulation

**This section describes evidence recorded against the pre-#221 GDS**
(`level_shifter` + `output_stage` only, no `uvlo`) — re-running it against
the issue #221-extended, uvlo-and-resistor-bearing extracted netlist is
explicitly the next slice of epic #219 (issue #222), not this issue's own
scope. Nothing below this note has been re-verified against the current
`gate_driver_core.gds`.

The LVS-extracted netlist is turned into a simulatable DUT by
[`lvs/mk_extracted_dut.py`](lvs/mk_extracted_dut.py), whose module docstring
and generated file header list every transform (T1…T8) and every
back-annotation (BA1…BA3) applied to the extractor's own output. Two DUTs are
built from the same layout, and both now carry the XCCOMP MiM stack (#166):

| File | Built from | Contents | Used for |
|---|---|---|---|
| [`lvs/gate_driver_core.extracted.spice`](lvs/gate_driver_core.extracted.spice) | the LVS extraction, `--combine` | 42 MOS cards, parallel-identical fingers folded back to `m=<n>`, plus the 4 `XCCOMP*` MiM series capacitors (never folded — T7); drawn W/L and measured AS/AD/PS/PD; **no interconnect parasitics** | the full PVT grid |
| [`lvs/gate_driver_core.extracted-rc.spice`](lvs/gate_driver_core.extracted-rc.spice) | `klt extract --parasitics` | 959 discrete fingers + the 4 `XCCOMP*` caps + 2885 R / 20 C per-net ground stars, **including both ground rails** — the merged `GND_DRV\|GND_LOGIC` net's star is emitted with each leg's hub rebound to that leg's *own* device's rail (297 ground-rail legs, issue [#184](https://github.com/2AMLogic/gf180-gate-driver/issues/184)), and its one measured capacitance placed between the two real rails; **still no net-to-net coupling** | its own full PVT grid, run via `--dut` |

Both DUTs' anonymous, unlabeled internal nets — `klt extract`'s own `$N`
naming for a net with no schematic label, this design's first real case
being XCCOMP's three inter-cap nodes — are rewritten to `ANON<N>` (T8, issue
#201): a bare SPICE token starting with `$` is an inline-comment marker to
ngspice, so left as-is these nets silently truncated every card that named
them (confirmed directly: the first post-#166 regeneration measured *zero*
effect from XCCOMP on any PVT corner, bit-for-bit identical to the
pre-#166 evidence, with no simulator error — only a per-card `... is not a
valid ... line, ignored!` warning in the raw ngspice log, outside
`run_corners.py`'s own PASS/FAIL summary). `mk_extracted_dut.py`'s own
`AnonymousNetNameTest` pins this transform against a synthetic extract dict
so it stays covered independent of whether a real committed report happens
to exercise it.

Both DUTs still back-annotate every body terminal (BA1/BA2) rather than
reading it off the extractor's own merged `GND_DRV|GND_LOGIC` net directly —
issue #132 made that assertion *redundant with what real extraction now
measures* rather than a fabrication filling an unmeasurable gap
(`mk_extracted_dut.py`'s T4), but it stays a rebind so the testbench still has
nets literally named `GND_LOGIC`/`GND_DRV` to drive (`sim/gate-driver-core-
drive-postlayout/testbench/gate_driver_core_tb.spice` instantiates both, tied
by a small resistor, modeling decision record 0001's "one electrical node").
T4's rebind is no longer only a body-terminal concern, either: since real
tap geometry merges the two grounds at the extraction level (see "[Body ties
and guard ring](#body-ties-and-guard-ring-132)" above), an *ordinary* d/s
connection to a ground rail lands on that same merged identity too, and gets
rebound the same way — per that terminal's own device's real domain (the
same (class, L) fact T4's body rebind already uses), never to one fixed
name. A fixed-name rebind was tried and measured wrong: it silently rerouted
a large fraction of the design's real `GND_DRV` connections (e.g. the output
stage's pull-down stack) through the testbench's tie resistor instead of
straight to the load capacitor's own return node, regressing `n1_min_v`
undershoot broadly.

The campaign, its per-corner results, and the schematic-vs-extracted delta
live in [`sim/gate-driver-core-drive-postlayout/`](../sim/gate-driver-core-drive-postlayout/)
as ordinary append-only `sim/` evidence, re-run against the post-#166
(XCCOMP-drawn) extraction, fixed for T8's anonymous-net rename (issue #201;
parasitic-free:
[`20260818-111748-af13899`](../sim/gate-driver-core-drive-postlayout/records/20260818-111748-af13899.md);
RC: [`20260818-112446-af13899`](../sim/gate-driver-core-drive-postlayout/records/20260818-112446-af13899.md)
— both the full 60-point PVT grid, superseding the pre-#166 pair).

**Read these numbers against one remaining, already-tracked, pre-existing
gap, not against #166's own geometry or #201's own regeneration**:

- **A harness transient-tolerance refinement (issue #156, landed after the
  pre-#132 postlayout evidence was recorded) moved every §2.3 gate-ceiling
  and undershoot measurement outward** by tens of mV, on both the schematic
  and the layout side alike — tracked for its spec-margin consequences as
  issue [#163](https://github.com/2AMLogic/gf180-gate-driver/issues/163).

**What #201 itself changed, isolated from that**: regenerating the DUTs
against the post-#166 extraction (and fixing T8's anonymous-net rename, which
the first regeneration attempt needed before XCCOMP had any measurable
effect at all) delivers the benefit decision records 0007/0014 already showed
on the schematic side — `n1_min_v` undershoot drops from 29/60 points to
**0/60** under RC, and from 29/60 to 12/60 (all `ss` corner) even
parasitic-free. The two `ipeak_sink_a` stretch misses are untouched by
XCCOMP (they are a pre-existing drive-strength shortfall, not a
gate-ceiling/undershoot one) and remain the *only* misses under RC.

| | Parasitic-free (`af13899`, no-RC) | RC (`af13899`) |
|---|---|---|
| Overall | `FAIL` — 13/60 points (one point fails both rows below) | `FAIL` — 2/60 points |
| `ipeak_sink_a` short of the **1 A stretch** target, `ss_125c`/`sf_125c` 6 V | 0.883 A / 0.931 A | 0.880 A / 0.925 A |
| `n1_min_v` past the inherited **−50 mV undershoot** band | 12 points (all `ss`), worst −53.6 mV | **0 points**, worst −6.8 mV |
| Worst gate-ceiling excursion, taper (`n1_max_v`) | 6.11425 V | 6.00988 V |
| Worst gate-ceiling excursion, `indrv_max_v` | 6.00194 V | 6.0004 V |

The RC record's own pattern is unchanged from the original #105 finding:
**the extracted per-net capacitance damps exactly the ringing that drives the
undershoot band** (0 points fail `n1_min_v` under RC vs. 12 without it), and
layout still costs this block delay, not drive — `ipeak_sink_a` is
essentially identical with and without RC. The two `ipeak_sink_a` stretch
misses are the same pre-existing, narrative-documented shortfall the
schematic-side record already carries (decision record 0007's own summary:
"the only two harness-check misses are the same ... pre-existing
`ipeak_sink_a` 1 A stretch-target shortfall the baseline record already
carried"). `indrv_max_v`'s worst excursion also drops well inside the 6.6 V
thin-oxide ceiling on both DUTs now — pre-#201 (pre-capacitor) it read
6.13874 V parasitic-free — consistent with XCCOMP's own purpose (mitigating
decision record 0006's gate-drive-feedthrough overshoot).

Three anonymous internal nets in the RC DUT (XCCOMP's three inter-cap nodes,
which have no DC path by construction — see "[Why `mim_stack`
exists](#why-mim_stack-exists-166)" above) make ngspice's DC operating-point
solve report `singular matrix` warnings and fall back through gmin/source
stepping before finding the transient operating point directly; every one of
the 60 RC-DUT corners still completes and produces a physically sensible
trajectory (see the raw per-corner logs under
`sim/gate-driver-core-drive-postlayout/corners/20260818-112446-af13899/`) —
noted here since it is visible in the evidence, not because it is a new
finding: it is exactly what "floating by construction" (the `mim_stack`
check's own premise) predicts for a first-order DC solve.

These records are a real re-verification of the LVS-closed, capacitor-bearing
extraction (issue #105's original item-3 acceptance criterion, most recently
deferred pending #166's own geometry), not a tapeout signoff and not a
re-litigation of `spec/gate-driver.md` §5's ratified exceptions — that
re-litigation is #163's scope.

## Folded power-array generator (`common/power_array_folded.py`, #254)

Every device in the committed `gate_driver_core` netlist is `nf=1` and drawn
as a single-row `mos_array` strip (widest today: `MPD`, `uvlo`'s `m=800`
pulldown, ~900 µm wide — see "[Floorplan](#floorplan)" above). A future,
wider power stage will need to **fold** a very-high-`m` device across
multiple physical rows so its single-row strip does not dominate the block's
long axis — but folding is not just placement: the folded rows' own G/S/D
buses have to tie into **one shared net each**, or the "folded" device
extracts as `rows` separate smaller devices instead of one. No generator in
this catalog drew that before issue #254, so `common/power_array_folded.py`
is genuinely new infrastructure — it has no caller in this block yet (every
netlist device is still `nf=1`). **That is deliberate:** the module is kept
on purpose, with its unit tests and CI step, for future power-stage growth,
so the next power-stage device does not have to re-derive the scheme. Do not
remove it as dead code (operator ruling on #317, 2026-10-22: keep).

**Correcting a false impossibility claim.** A single-layer (Metal1-only)
scheme was attempted upstream of this issue and recorded as evidence that
*"cross-row ties need a second routing layer"* (tracked as friction **F-018**
in `2AMLogic/gf180-drone-fc`) — an impossibility claim from one failed
scheme (vertical risers at a fixed X, which cross every other net's own bus
band in an unmirrored farther row), not a proof. It shipped arrays with
**untied rows** and honest per-row `G<r>`/`S<r>`/`D<r>` labels, which passed
every geometric assertion that existed (finger count, bounding box) because
nothing checked electrical connectivity across the fold. **F-023** is the
correction: mirroring alternate rows in Y (`klt gen-compose`'s
`orientation: "mirror_y"`) brings adjacent rows' gate pads to face each
other directly across the inter-row gap — `mos_array` always reports the
gate pad on a row's *top* edge, and a Y-mirror flips that to the *bottom*
edge, with nothing else drawn in the gap between two adjacent rows — so one
plain metal box ties them with no via (`gate_contact: true` is required for
exactly this: it puts the gate pad on the same metal role as source/drain).
Source and drain need no such trick: `mos_array` always reports them on a
row's left/right edges, which a Y-mirror does not move, so a straight run in
a channel outside the block's own left/right edges connects both rows'
source (resp. drain) pads without ever crossing the other row's own
interior.

**Verified against a real `klt` install + resolved gf180mcu PDK, not merely
argued**: a two-row, `fingers=4`-per-row fold (`m=8` total) extracts as eight
transistors sharing exactly one `(s, g, d)` net triple (up to the
source/drain swap a "parallel" folded device's alternating orientation
produces) — one folded `m=8` device, not two `m=4` devices. A negative
control that skips the tie and gives each row its own honest per-row label
(`G0`/`S0`/`D0`, `G1`/`S1`/`D1` — the exact shape F-018's own arrays shipped
in) extracts as two disjoint triples instead, reproducing the regression
`fold_connectivity_verdict` (below) exists to catch.

**Cost and limit.** The scheme costs one dedicated trunk channel (default
`2 * trunk_margin_um` = 2.0 µm total, split as one margin on each side)
beyond the folded block's own left/right edges, plus `gap_um` (default 4.0
µm, matching F-023's own measured cost) of clear vertical space between the
two rows. **The scheme is two rows only** — `power_array_folded.fold_rows`
**raises** for `rows > 2` rather than silently drawing `rows` disjoint
devices (a third row has no gap that is simultaneously adjacent to two other
rows' own gaps, so its own gate pad cannot be tied the same way without
either a notch-routed same-layer scheme or a real second routing layer with
vias — neither implemented here). This is a stated limit of *this
generator*, not a re-assertion that no same-layer `rows > 2` scheme can
exist — see the module's own docstring for the full argument, including the
"transferable lesson" the issue draws from F-018 itself: an impossibility
claim needs a proof, or an explicit hedge that it is one attempted scheme,
not an exhaustive one.

**Its own connectivity check** — `power_array_folded.fold_connectivity_verdict`
— is a pure function (a `klt extract`-shaped dict in, a check record out),
mirroring `check_gate_driver_core.py`'s own `ground_rail_isolation_verdict`/
`mim_stack_verdict`: it asserts the extracted finger count and that every
finger shares one gate net and one unordered source/drain net pair, so an
untied (or partially-tied) fold fails loudly instead of passing every
geometric assertion the way F-018's own arrays did. Its failing directions
are pinned in `common/test_power_array_folded.py` against synthetic
extraction facts shaped exactly like the real untied fixture described
above.

```bash
python3 layout/common/power_array_folded.py \
    --w-um 4.0 --l-um 0.6 --fingers 8 --rows 2 --flavor nfet \
    --out-dir /tmp/fold_demo
# needs klt + a resolvable gf180mcu PDK (same requirement as
# gen_gate_driver_core.py); generates the fold, then runs the connectivity
# check and prints PASS/FAIL. Open /tmp/fold_demo/power_array_folded.gds in
# klayout/klt render to see the mirrored gate buses meet across the
# inter-row gap with nothing else drawn there.

python3 layout/common/test_power_array_folded.py     # PDK-free unit tests
```

## Known gaps

- **`test_mk_extracted_dut.py`'s merged-ground fixture reports still predate
  the MiM stack (#166), deliberately (#201).** Its `RC_REPORT`/`FLAT_REPORT`
  constants are pinned to the pre-#166 extraction rather than re-pointed at
  the committed DUTs' current source: every count its assertions pin (297
  merged-ground legs, 2877 R / 17 C, the 294/3 domain split, 16 "other"
  ground-referenced capacitors) is a fact about the merged-ground star
  transform on MOS terminals specifically, unaffected by XCCOMP, and
  re-pointing them would also pull in T7's four MiM device cards, which that
  fixture's "capacitors" list cannot yet distinguish from T5's per-net
  ground-star cards without teaching several assertions that distinction.
  Left as a real, separate refactor (see the constant's own comment in that
  file), not folded into #201's netlist-regeneration scope.
- **DRC `clean` is the curated deck's verdict, not a full-DRM or medium-voltage
  signoff (#362; see [DRC](#drc-klt-drc) above).** The deck
  ships no rules for `DNWELL`/`LVPWELL`, and every rule but `DF.1a`/`DF.3a`
  still applies 3.3 V thresholds to thick-oxide geometry — see the coverage
  table above. DRM 7.2's well spacing/enclosure rules, and the guard ring's
  own geometry, are unchecked by any automated verdict in this repo (the
  guard ring #132 draws satisfies the *presence* requirement, not a DRC rule
  this deck can check).
- **Every body terminal ties to a real net (issue #132), and — as of issue
  #221 — the two grounds no longer merge on any *other* terminal.** Every
  PMOS body ties to the schematic's own `VDD_LOGIC`/`VDD_DRV` via a real
  per-device well tap, and every NMOS body ties to the deck's one hardcoded
  global substrate identity via a real per-device substrate/LVPWELL tap
  (`Interconnect.body_ties()`) — `klt lvs` reports **zero**
  `device.body_unverified` mismatches, closing the finding that used to
  cover all 959 bodies (660 PMOS, then 299 NMOS after a first pass of issue
  #132's own geometry), and still zero at issue #221's much larger device
  count. **What changed:** an earlier revision of this bullet (and of
  `lvs/make_reference.py`) additionally claimed that once real taps existed
  for *both* domains, `klt extract` also merged every *ordinary* terminal
  wired to either ground rail into one net (`GND_DRV|GND_LOGIC` in its own
  raw output) — confirmed at the time against `klt` 0.2.0. Re-running that
  *exact, byte-identical* GDS through the `klt` build now installed (0.3.0,
  a different `provenance.deck.content_hash`) no longer reproduces that
  merge: the global substrate identity surfaces as `GND_LOGIC` alone, and
  `GND_DRV` extracts as its own, separate, unmerged net on every terminal —
  on both the pre-#221 GDS and this issue's UVLO-extended one. This is a
  known, already-tracked `klayout-tools` deck-behavior drift (issue
  [#1149](https://github.com/2AMLogic/klayout-tools/issues/1149), filed the
  same day the old evidence was recorded), and it also turns out to match
  `spec/decision-records/0001` Decision 1 better than the old assumption
  did: the two grounds are one electrical node only via a pad ring this bare
  core block does not itself draw, so two genuinely separate nets at *this*
  level is the electrically correct picture, not a gap the old merge was
  papering over. `GND_LOGIC` and `GND_DRV` are drawn and stay as two
  separate Metal2 nets end to end either way, which
  `check_gate_driver_core.py`'s
  [`ground_rail_isolation`](#why-ground_rail_isolation-exists-132) check
  (added by issue #132) verifies independently of the extractor's substrate
  model, with its own known-good/known-bad control. The underlying "one
  NMOS body, every domain" tool limitation itself is unaffected and remains
  filed upstream: klayout-tools
  [#1128](https://github.com/2AMLogic/klayout-tools/issues/1128). See
  "[Body ties and guard ring](#body-ties-and-guard-ring-132)" above for the
  full mechanism, and "[Post-layout simulation](#post-layout-simulation)"
  below for the re-run evidence against the now-fully-verified extracted
  netlist. The post-layout DUT still **rebinds** (rather than reads
  directly) every body terminal to
  `GND_LOGIC`/`GND_DRV`/`VDD_LOGIC`/`VDD_DRV` (`mk_extracted_dut.py`'s
  T4/BA1/BA2) — not because the assertion is unmeasured any more (it now
  matches real extraction on both flavors), but because the testbench needs
  a net literally named `GND_LOGIC`/`GND_DRV` to drive.
- **The RC DUT's ground rails are no longer ideal — the residual is how the
  merged net's one lumped capacitance is placed (issue
  [#184](https://github.com/2AMLogic/gf180-gate-driver/issues/184), closed).**
  Because the RC extraction the committed DUT is built from reports the two
  grounds as one merged net (the `klt` 0.2.0 behavior the previous gap
  describes, before the #1149 drift),
  `mk_extracted_dut.py`'s T5 used to skip that net's parasitic star outright,
  leaving both rails as ideal zero-ohm nodes — 297 R legs and the
  `GND_DRV`↔`GND_LOGIC` cap short of the pre-#132 RC DUT, and **optimistic,
  not conservative**, for exactly the ground-bounce/undershoot checks the RC
  record makes. T5 now emits that star with each leg's **hub rebound
  per-device** — leg → R → that leg's *own* device's real `GND_LOGIC`/
  `GND_DRV`, by the same disjoint (class, L) binning as T4/BA1 — which
  reproduces the pre-#132 topology exactly (each rail's own `hub_net` *was*
  that rail's node): 294 legs on `GND_DRV`, 3 on `GND_LOGIC`, 2877 R total,
  and no node anywhere standing in for the merged identity. A shared or
  fixed-name hub is known wrong and is pinned against in CI
  (`lvs/test_mk_extracted_dut.py`) — see `MERGED_GROUND_RAW`'s docstring.
  What is left is an approximation, not a hole: the deck reports **one**
  measured ground capacitance for metal spanning both rails and resolves no
  per-domain split, so it is emitted whole between the two real rails (where
  the pre-#132 `GND_DRV` star's own cap landed) rather than apportioned by
  assertion — 17 C, versus pre-#132's 18, whose extra card was a degenerate
  `GND_LOGIC`-to-itself cap. Measured effect on the RC record, full 60-point
  grid: undershoot deepens on most corners, as restoring rail IR drop should
  (`indrv_min_v` and `n3_min_v` on 60/60 corners, `n5_min_v` on 59/60), the
  worst `n1_min_v` moves −0.00681 V → −0.00680 V (a second-order improvement
  at that one corner; 39/60 corners deepen), and the verdict is unchanged —
  same two failing corners, both on `ipeak_sink_a`'s stretch target. The
  deepest undershoot anywhere on the grid is `n5_min_v` at −0.0205 V against
  the −0.05 V limit (2.4x margin, was −0.0204 V).
- **klt's gf180mcu deck does not model `Dualgate` scoping.** Every thick-oxide
  device in this layout extracts against the **3.3 V** model
  (`nfet_03v3`/`pfet_03v3`) and is DRC-checked against 3.3 V thresholds, even
  though it is drawn entirely inside `Dualgate` — klt reports this itself in
  `voltage_domain_warnings`, and its gf180mcu deck documents it as a known
  gap. The checker therefore compares device *flavor* (n/p) and W/L, never the
  extracted model name, and records klt's warning in the report so the gap is
  visible rather than silently absorbed. This is the canary's medium-voltage
  friction showing up exactly where CLAUDE.md predicts it would; filed
  upstream per the friction protocol and still open as klayout-tools
  [#1089](https://github.com/2AMLogic/klayout-tools/issues/1089).

  It has a measured downstream consequence, not just a warning:
  `klt extract --pdk gf180mcuD` binds **every** device in this layout to
  `nfet_03v3`/`pfet_03v3` — all 299 NMOS and all 660 PMOS, including the 955
  thick-oxide fingers drawn inside `Dualgate`. A netlist bound that way would
  simulate 5 V/6 V devices on 3.3 V model cards, so the post-layout DUT
  ([`lvs/mk_extracted_dut.py`](lvs/mk_extracted_dut.py), T2) deliberately does
  **not** use `--pdk`: it re-binds by drawn L, which disjoint-identifies
  flavor in this netlist (0.28 µm thin-oxide, 0.70 µm 6 V nfet, 0.55 µm 6 V
  pfet). The body-terminal handling behind BA1/BA2 and behind
  `make_reference.py`'s transforms 3/4/5 traces back to the same family of
  upstream deck gaps ([#281](https://github.com/2AMLogic/klayout-tools/issues/281),
  [#555](https://github.com/2AMLogic/klayout-tools/issues/555),
  [#490](https://github.com/2AMLogic/klayout-tools/issues/490), and #1128
  above for the NMOS-substrate-specific one issue #132 investigated).
- **`klt gen`'s MOS generators cannot draw a voltage-domain / thick-oxide
  marker themselves** (klayout-tools
  [#1054](https://github.com/2AMLogic/klayout-tools/issues/1054)), so
  `Dualgate`/`DNWELL`/`LVPWELL` are drawn by `klt draw` and aligned over the
  generated device cells' reported bounding boxes — which is exactly the
  workaround that issue names. Two more klt gaps shaped this flow and are
  tracked upstream: `gen-compose`'s router is two-pin only, so a shared supply
  rail or any fanout node is unroutable
  ([#1073](https://github.com/2AMLogic/klayout-tools/issues/1073)) — hence the
  hand-built interconnect cell — and a `klt draw` response is not accepted as
  a `gen-compose` block without hand-synthesising a `generator_report`
  ([#1059](https://github.com/2AMLogic/klayout-tools/issues/1059)), which is
  what `gen_gate_driver_core.py` does for the interconnect cell.
- **Device aspect ratios are whatever `m` folds into a single row.** The
  500-finger `x2_XMP6` is 486 µm wide and 13 µm tall. Electrically it is what
  the netlist asks for; as a floorplan it is a first cut.
