2AMLogic/gf180-gate-driver/.loom/docs/repo-owned-files.md

# Repo-owned files inside `.loom/`

`.loom/` is a Loom-managed tree, but it is not *exclusively* Loom's. Some of it
is an **extension point**: `.loom/hooks/post-worktree.sh`, for example, is a
file Loom never ships and always invokes (`worktree.sh` runs it after creating
a worktree), so a repo that wants per-worktree setup is *expected* to add its
own file there.

This page states the ownership rule the installer applies, and how a repo
declares "this file is mine" so an upgrade cannot delete it.

## The rule

On reinstall (`install.sh --confirm-reinstall`, `loom update`, a direct
`loom-daemon init --force`), Loom cleans each managed `.loom/` directory —
`roles/`, `scripts/`, `hooks/`, `docs/`, `runtimes/`, `bin/` — before copying
the new version in. A file already sitting in one of those directories is
**deleted only when Loom can attribute it to itself**:

| Evidence | Outcome |
|---|---|
| The current `defaults/` tree ships a file at that path | **Removed**, then immediately re-copied (net effect: refreshed) |
| The path is pinned in `.loom/resync-ignore` | **Preserved** — declared repo-owned |
| The path is listed in `.loom/install-metadata.json`'s `installed_files` | **Removed** — Loom installed it, so Loom may retire it |
| None of the above | **Preserved** and reported as unmanaged |

The last row is the important one: **no evidence means no deletion.** A stale
Loom file that survives is cosmetic drift, and the manifest-driven sweeps in
`scripts/install-loom.sh` and `scripts/uninstall-loom.sh` still retire it. A
deleted repo file is unrecoverable, and — for a hook — silently stops firing.
The two failure modes are not symmetric, so the installer errs toward keeping.

Every file the installer removes, and every file it preserves under this rule,
is **named in the installer's output**. Nothing in `.loom/` is deleted silently.

### The one place the rule is looser: an explicit `--clean` uninstall

`uninstall-loom.sh --clean` is an operator saying "wipe the managed
directories, *including* files the manifest never recorded". That request is
honored — with two exceptions:

- a path pinned in `.loom/resync-ignore` is never removed (the declaration is
  the opt-out), and
- inside `.loom/hooks/`, a file the current `defaults/` does not ship is
  preserved even without a pin. Hook scripts can never appear in
  `installed_files` (#4262), so "unrecognized" there carries no information.

Everything preserved is named in the output, same as above.

## Declaring a file repo-owned

List its `.loom/`-relative path, one per line, in `.loom/resync-ignore`:

```
# .loom/resync-ignore — paths Loom must not overwrite or delete
hooks/post-worktree.sh
scripts/project-local-helper.sh
```

Blank lines and `#` comments are ignored; matching is exact (no globs), the
same semantics `resync-installed.sh` already uses.

This is the same file that pins a customization against being *overwritten* by
`./.loom/scripts/resync-installed.sh`; it now also pins it against being
*deleted* by the installer's clean sweep. One list, one meaning: **this path is
the repo's, not Loom's.**

Since #7995 a `PreToolUse` guard reads this list too. In a repo that is not
Loom's own source tree, an agent writing to an **unpinned** path under
`.loom/hooks|scripts|roles|docs|bin/` or `.claude/commands/loom/` is denied —
through the `Edit`/`Write` tools and through the Bash write idioms alike — with
a message naming the two dispositions above. Adding the path here is what turns
that denial off for that one file, because the pin is the repo declaring the
file its own. See [`guard-hooks.md`](guard-hooks.md) §"Installed-File Write
Guard" for the discriminator that decides "consumer repo vs. Loom's own tree"
and for the category toggle.

Commit `.loom/resync-ignore` — it is repo configuration, and the installer
never removes it.

### Recording a pin's fork point (`.loom/resync-pin-base`)

A pin says a file is protected, not what upstream revision it forked from, so
"can this pin be lifted yet?" used to mean replaying upstream history until a
revision matched the local copy. Create pins with the supported operation
instead of hand-editing the list (#8726):

```bash
loom-daemon resync-pin add roles/curator.md            # pin + record fork point
loom-daemon resync-pin add roles/curator.md --base <rev>   # legacy pin: backfill
loom-daemon resync-pin status                          # per-pin drift + review diff
```

`add` appends the path to `.loom/resync-ignore` (canonical label form, written
**first** so protection never depends on the rest) and records one tab-separated
line in the **additive sidecar** `.loom/resync-pin-base`: pin label, full
upstream Loom commit, the source path at that commit (`roles/*` maps to
`defaults/roles/*`, `commands/loom/*` to `defaults/.claude/commands/loom/*`, …,
with in-tree symlinks resolved), and how the commit was chosen. Commit the
sidecar with the pin list. `status` prints `N upstream commit(s), +A/-D lines`
and the exact `git -C <loom-clone> diff <base> <upstream> -- <path>` to review.

- **Which commit.** `--base <rev>` if given; otherwise, for a *new* pin only,
  `loom_commit` from `.loom/install-metadata.json` — the upstream revision the
  installed copy was last synced from. It is the Loom *source* revision, never
  this repo's HEAD. An already-pinned path needs `--base`: resync skipped it, so
  install metadata says nothing about its fork point.
- **Verified or not recorded.** The commit must resolve in a Loom source
  checkout (`--source`, else `.loom/loom-source-path`, else this repo when it is
  Loom's own source) and the source path must exist there. Otherwise the pin is
  still written, nothing is recorded, and the reason is printed. `status` never
  reports an unknown or unresolvable base as zero drift.
- **Never replaced implicitly.** Resync does not read or write the sidecar, and
  a repeated `add` keeps an existing base; pass `--replace-base` after rebasing
  your local patch onto a newer upstream.
- **Additive.** The pin syntax and both readers (`is_ignored()` in
  `resync-installed.sh`, `parse_resync_ignore` in Rust) are unchanged; pins with
  no recorded base keep working and report `base UNKNOWN`. Without a daemon that
  has this command, edit `.loom/resync-ignore` by hand as before.

### When you do and do not need it

- **A file Loom never ships** (`hooks/post-worktree.sh`, a project helper
  script) is already preserved on the reinstall path by the "no evidence" rule
  above. Pinning it is still worth doing: it is the only thing that protects a
  non-`hooks/` file from an explicit `--clean`, it turns an implicit outcome
  into a declared one, it moves the file out of the "unmanaged, review me"
  section of the installer's output, and it protects the file from a legacy
  over-broad `installed_files` manifest that wrongly claims Loom wrote it.
- **A file Loom *does* ship**, customized in place (e.g. your own edit of
  `hooks/guard-destructive.sh`), cannot be protected from the installer by a
  pin — the reinstall re-copies the shipped version over it by design. Pinning
  it does stop `resync-installed.sh` from overwriting it between installs. If
  you need a durable fork, give it a name Loom does not ship and wire that name
  up instead.

## Before you hand-edit an installed file, stop

An agent (Builder, Doctor, or otherwise) that finds a bug in a file under
`.loom/hooks|scripts|roles|docs|bin/` or `.claude/commands/loom/` — in *any*
repo, not just Loom's own source — has exactly two valid moves, never a
third:

1. **Fix it upstream**: open a PR against `rjwalters/loom`'s `defaults/` tree.
   The fix then returns to this repo through the normal `chore: resync
   installed Loom surfaces` flow.
2. **Pin it**: if the change is a deliberate, repo-specific override that
   should never resync from upstream, add its path to `.loom/resync-ignore`
   (see "Declaring a file repo-owned" above) so the divergence is explicit and
   durable.

**Never silently hand-edit the installed copy and move on.** `resync-installed.sh`
does now warn and block instead of silently reverting an unpinned local
divergence it can detect (its own "LOCAL-DIVERGENCE PROTECTION" header) — but
that is a safety net for the one shape it can recognize, not a substitute for
either move above, and it is not foolproof (a pure-addition upstream change,
or a resync commit that happens to land on top, both slip past it cleanly).
Two more shapes are known, deliberate gaps rather than bugs (#8098): the gate
reads COMMITTED git history only, so a local fix still sitting solely in the
uncommitted working tree is invisible to it and gets silently reverted by a
resync just like the pre-protection behavior; and the gate only trips on a
REMOVED line, so a local fix implemented as a pure *deletion* of a broken
upstream line (nothing added back) never arms it either, and the resync
re-adds the broken line. Widening the gate to cover either shape changes its
false-positive rate on a fleet-wide updater path, which is a deliberate
tradeoff decision, not a reflexive fix — upstreaming or pinning (the two moves
above) remains the only fully reliable protection for either.
`2AMLogic/sky130-modexp` hit this the hard way: an installed hook fix got
silently reverted by a resync, was hand-reapplied in place, got reverted
again — four commits repeating that cycle — before the repo gave up and
blocked its own resync outright rather than keep losing the fix. Upstreaming
or pinning the first time avoids the whole loop.

## Why not just delete anything unrecognized?

That is what the sweep used to do, and it deleted a consumer repo's own
`.loom/hooks/post-worktree.sh` during a routine version upgrade (issue #5971).
Nothing in `.loom/hooks/` is even eligible to appear in `installed_files` —
hook scripts are deliberately excluded from the install manifest (#4262) — so
"absent from the manifest" can never mean "not yours" for that directory.
