2AMLogic/gf180-gate-driver/sim/smoke-mv-inverter/records/20261024-055542-ea2cf2b.md

# Record 20261024-055542-ea2cf2b

- **Record ID**: 20261024-055542-ea2cf2b
- **Claim**: None — harness self-verification, not a spec claim. Proves the two-rail PVT plumbing (parameter substitution on both vlogic and vdrv, .lib corner sections reaching the thick-oxide 06v0 device family, .temp) actually takes effect, so later records against ratified spec lines (spec/gate-driver.md) can be trusted.
- **Netlist provenance**: schematic (`sim/smoke-mv-inverter/testbench/smoke_mv_inverter.spice`)
- **Corner matrix run**:
  - Process: tt
  - Temperature: 27 °C
  - Supply (vlogic, nominal 3.30 V): 2.97 V, 3.30 V, 3.63 V
  - Supply (vdrv, nominal 5.00 V): 4.50 V, 5.00 V, 5.50 V
  - 3 point grid (process x temperature x tied two-rail supply point -- see sim/README.md), 3 completed
  - **Subset of the mandated PVT matrix.** Gaps: temperature: missing -40 C, 125 C; process: only 1 corner(s) (tt); at least 3 expected.
  - Justification: first manifest-backed run, #333 live verification
- **Statistical convention**: N/A (corner-matrix claim, not a distribution claim)
- **Result**:

  | corner-id | vdiv_ratio | vout_ratio | vbias_drv | pass/fail |
  |---|---|---|---|---|
  | `tt_27c_vlogic2p97v-vdrv4p50v` | 0.5 | 1 | 0.947202 | PASS |
  | `tt_27c_vlogic3p30v-vdrv5p00v` | 0.5 | 1 | 0.947202 | PASS |
  | `tt_27c_vlogic3p63v-vdrv5p50v` | 0.5 | 1 | 0.947202 | PASS |

  Grid-level check failures: vbias_drv min_spread_pct=3 (got 0).

  Spread across the grid:

  | measurement | min | max | mean | spread % | limits |
  |---|---|---|---|---|---|
  | `vdiv_ratio` | 0.5 (`tt_27c_vlogic2p97v-vdrv4p50v`) | 0.5 (`tt_27c_vlogic2p97v-vdrv4p50v`) | 0.5 | 0 | min=0.4999, max=0.5001, max_spread_pct=0.001 |
  | `vout_ratio` | 1 (`tt_27c_vlogic2p97v-vdrv4p50v`) | 1 (`tt_27c_vlogic3p63v-vdrv5p50v`) | 1 | 1.000000e-08 | min=0.99, max=1.0001 |
  | `vbias_drv` | 0.947202 (`tt_27c_vlogic2p97v-vdrv4p50v`) | 0.947202 (`tt_27c_vlogic2p97v-vdrv4p50v`) | 0.947202 | 0 | min=0.6, max=1.4, min_spread_pct=3 |

  - **Overall: FAIL**
- **Links**:
  - Testbench: `sim/smoke-mv-inverter/testbench/smoke_mv_inverter.spice`, `sim/smoke-mv-inverter/testbench/tb.json`
  - Netlist snapshot: `sim/smoke-mv-inverter/netlist-snapshots/20261024-055542-ea2cf2b.spice`
  - Raw logs: `sim/smoke-mv-inverter/corners/20261024-055542-ea2cf2b/`
- **Timestamp / author**: 2026-10-24T05:55:42+00:00, ubuntu
- **Supersedes**: (none)

## Environment

Everything needed to re-run this record:

- PDK: gf180mcuD @ open_pdks `c6d73a35f524070e85faff4a6a9eef49553ebc2b` (/home/ubuntu/.volare/gf180mcuD, found via search_root:~/.volare)
- ngspice: ngspice-46 : Circuit level simulation program
- Transient tolerance: reltol=1e-4 (harness default)
- Harness: sim/harness 0.2.0, python 3.12.3
- git: `ea2cf2b7cf3386969b44c828f56a42aaf70ab3bb` on `feature/issue-333` (clean)
- Testbench netlist sha256: `cc106571815448397248870c5e29864f884ab3780f979a8eb8a2a45958c973b3`
- Manifest sha256: `3281867142387840cd9b10590319212fc7d95a5014916f133e687e8030808a56`
- Wall time: 0.07 s

Per-corner model sections used:

- `tt`: typical res_typical bjt_typical diode_typical moscap_typical mimcap_typical

---

Written by `sim/run_corners.py`. Append-only: never edit or delete this
file — a re-run or correction mints a new record-id and points back here
via **Supersedes** (see `sim/README.md`).

## Stored evidence

The bytes of this run are in the fleet artifact store, not in git (issue #333). Manifest: `manifests/artifacts/smoke-mv-inverter-20261024-055542-ea2cf2b.manifest.json` (4 objects, 3539 B). Paths above are the manifest `name`s. Fetch one, hash-verified, with:

```
klt artifact get manifests/artifacts/smoke-mv-inverter-20261024-055542-ea2cf2b.manifest.json#<name> -o <out>
python3 scripts/check_artifact_manifests.py verify manifests/artifacts/smoke-mv-inverter-20261024-055542-ea2cf2b.manifest.json
```

| name | size (B) | sha256 |
|---|---:|---|
| `sim/smoke-mv-inverter/corners/20261024-055542-ea2cf2b/tt_27c_vlogic2p97v-vdrv4p50v.log` | 408 | `db078ff7843e4eaca8dd21910207af40bb993796b8fb7a0d5909e04b99ce8144` |
| `sim/smoke-mv-inverter/corners/20261024-055542-ea2cf2b/tt_27c_vlogic3p30v-vdrv5p00v.log` | 408 | `f09baf4de9a0fd021a99e593d793ed575628e78d92f66d692c85332e240a6e90` |
| `sim/smoke-mv-inverter/corners/20261024-055542-ea2cf2b/tt_27c_vlogic3p63v-vdrv5p50v.log` | 408 | `7231cde5e617628174e2b3e8439ef30b0d1695256a8679370c39543e1411b2fa` |
| `sim/smoke-mv-inverter/netlist-snapshots/20261024-055542-ea2cf2b.spice` | 2315 | `964f80c63a72afcdfd6d83f00d3ec62af9b0715953679a789e5dd4792f0b19f2` |
