2AMLogic/gf180-gate-driver/sim/level-shifter-oxide-safety-postlayout/records/20260910-011224-b6ec657.md

# Record 20260910-011224-b6ec657

- **Record ID**: 20260910-011224-b6ec657
- **Claim**: spec/gate-driver.md#4-level-shifter-topology-33-v-logic--56-v-drive-rail; spec/gate-driver.md#23-dc-gate-voltage-ceiling-thin-oxide-vs-thick-oxide
- **Netlist provenance**: extracted — DUT `layout/lvs/gate_driver_core.extracted.spice` (sha256 `38db5253dee283f4da9c88b9d42b4dcef114ecaa480fb0ce650e8cd2737f9bfa`), driven by `sim/level-shifter-oxide-safety-postlayout/testbench/gate_driver_core_level_shifter_oxide_tb.spice`
- **Corner matrix run**:
  - Process: tt, ff, ss, fs, sf
  - Temperature: -40 °C, 27 °C, 125 °C
  - Supply (vlogic, nominal 3.30 V): 2.97 V, 3.30 V, 3.63 V
  - Supply (vdrv, nominal 5.00 V): 4.50 V, 5.00 V, 5.50 V, 6.00 V
  - 60 point grid (process x temperature x tied two-rail supply point -- see sim/README.md), 60 completed
  - Full PVT matrix per CLAUDE.md (−40/27/125 °C, ±10 % on every rail, process corners).
- **Statistical convention**: N/A (corner-matrix claim, not a distribution claim)
- **Result**:

  | corner-id | vgate_thinox_max | vna_peak | vnb_peak | vccomp_dev_max | vccomp_stack_max | t_plh_ns | t_phl_ns | vout_hi_ratio | vout_lo_ratio | pass/fail |
  |---|---|---|---|---|---|---|---|---|---|---|
  | `tt_-40c_vlogic2p97v-vdrv4p50v` | 2.99336 | 1.98885 | 1.96415 | 1.10004 | 4.36049 | 0.699488 | 0.396037 | 0.999999 | 1.208072e-07 | PASS |
  | `tt_-40c_vlogic3p30v-vdrv5p00v` | 3.32343 | 2.26787 | 2.24738 | 1.218 | 4.82797 | 0.676611 | 0.343382 | 0.999999 | 1.137935e-07 | PASS |
  | `tt_-40c_vlogic3p63v-vdrv5p50v` | 3.65367 | 2.55259 | 2.53494 | 1.33231 | 5.28073 | 0.662296 | 0.301384 | 0.999999 | 1.086905e-07 | FAIL — vgate_thinox_max max=3.63 (got 3.65367) |
  | `tt_-40c_vlogic3p30v-vdrv6p00v` | 3.32332 | 2.28073 | 2.26036 | 1.43071 | 5.66978 | 0.57393 | 0.343335 | 0.999999 | 1.049820e-07 | PASS |
  | `tt_27c_vlogic2p97v-vdrv4p50v` | 2.99653 | 2.0675 | 2.029 | 1.08997 | 4.3206 | 0.832218 | 0.445678 | 0.999998 | 1.573859e-07 | PASS |
  | `tt_27c_vlogic3p30v-vdrv5p00v` | 3.32651 | 2.34242 | 2.30536 | 1.20682 | 4.78327 | 0.793472 | 0.388724 | 0.999998 | 1.487122e-07 | PASS |
  | `tt_27c_vlogic3p63v-vdrv5p50v` | 3.65706 | 2.61941 | 2.59269 | 1.32122 | 5.23641 | 0.766744 | 0.343192 | 0.999999 | 1.424538e-07 | FAIL — vgate_thinox_max max=3.63 (got 3.65706) |
  | `tt_27c_vlogic3p30v-vdrv6p00v` | 3.32659 | 2.35659 | 2.3214 | 1.41395 | 5.60284 | 0.665566 | 0.386379 | 0.999999 | 1.379558e-07 | PASS |
  | `tt_125c_vlogic2p97v-vdrv4p50v` | 2.99917 | 2.16448 | 2.10972 | 1.07658 | 4.26685 | 1.02141 | 0.514812 | 0.999998 | 2.177550e-07 | PASS |
  | `tt_125c_vlogic3p30v-vdrv5p00v` | 3.3293 | 2.43855 | 2.38749 | 1.18921 | 4.71295 | 0.958988 | 0.452038 | 0.999998 | 2.064946e-07 | PASS |
  | `tt_125c_vlogic3p63v-vdrv5p50v` | 3.65967 | 2.71396 | 2.66517 | 1.30248 | 5.16163 | 0.913413 | 0.401513 | 0.999998 | 1.983971e-07 | FAIL — vgate_thinox_max max=3.63 (got 3.65967) |
  | `tt_125c_vlogic3p30v-vdrv6p00v` | 3.3293 | 2.45453 | 2.40381 | 1.39159 | 5.5135 | 0.794305 | 0.447207 | 0.999998 | 1.926127e-07 | PASS |
  | `ff_-40c_vlogic2p97v-vdrv4p50v` | 2.98947 | 2.08329 | 2.06327 | 1.0873 | 4.30947 | 0.572625 | 0.330783 | 0.999999 | 1.089581e-07 | PASS |
  | `ff_-40c_vlogic3p30v-vdrv5p00v` | 3.31959 | 2.36855 | 2.35064 | 1.20177 | 4.7629 | 0.56541 | 0.285299 | 0.999999 | 1.034515e-07 | PASS |
  | `ff_-40c_vlogic3p63v-vdrv5p50v` | 3.65036 | 2.65568 | 2.63701 | 1.31557 | 5.21861 | 0.562301 | 0.2482 | 0.999999 | 9.951045e-08 | FAIL — vgate_thinox_max max=3.63 (got 3.65036) |
  | `ff_-40c_vlogic3p30v-vdrv6p00v` | 3.31989 | 2.38353 | 2.36363 | 1.41443 | 5.60461 | 0.486825 | 0.287315 | 0.999999 | 9.672473e-08 | PASS |
  | `ff_27c_vlogic2p97v-vdrv4p50v` | 2.99203 | 2.16338 | 2.12488 | 1.07606 | 4.26459 | 0.675787 | 0.369035 | 0.999998 | 1.404858e-07 | PASS |
  | `ff_27c_vlogic3p30v-vdrv5p00v` | 3.32244 | 2.44023 | 2.40633 | 1.18968 | 4.71461 | 0.65695 | 0.320632 | 0.999999 | 1.338621e-07 | PASS |
  | `ff_27c_vlogic3p63v-vdrv5p50v` | 3.65293 | 2.72116 | 2.69042 | 1.30277 | 5.16256 | 0.644781 | 0.281068 | 0.999999 | 1.291883e-07 | FAIL — vgate_thinox_max max=3.63 (got 3.65293) |
  | `ff_27c_vlogic3p30v-vdrv6p00v` | 3.32228 | 2.45663 | 2.42299 | 1.39677 | 5.53403 | 0.559719 | 0.321342 | 0.999999 | 1.259525e-07 | PASS |
  | `ff_125c_vlogic2p97v-vdrv4p50v` | 2.99381 | 2.21991 | 2.19566 | 1.05815 | 4.193 | 0.822358 | 0.421718 | 0.999998 | 1.949764e-07 | PASS |
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
  | `fs_125c_vlogic3p30v-vdrv6p00v` | 3.32916 | 2.49745 | 2.46922 | 1.41002 | 5.58726 | 0.828951 | 0.454219 | 0.999998 | 1.793980e-07 | PASS |
  | `sf_-40c_vlogic2p97v-vdrv4p50v` | 2.99185 | 1.9132 | 1.89325 | 1.0892 | 4.31712 | 0.684594 | 0.392892 | 0.999999 | 1.323783e-07 | PASS |
  | `sf_-40c_vlogic3p30v-vdrv5p00v` | 3.32175 | 2.19282 | 2.1721 | 1.20703 | 4.78401 | 0.667087 | 0.339543 | 0.999999 | 1.243491e-07 | PASS |
  | `sf_-40c_vlogic3p63v-vdrv5p50v` | 3.65237 | 2.4676 | 2.45036 | 1.32194 | 5.23922 | 0.657135 | 0.29716 | 0.999999 | 1.181791e-07 | FAIL — vgate_thinox_max max=3.63 (got 3.65237) |
  | `sf_-40c_vlogic3p30v-vdrv6p00v` | 3.32194 | 2.20351 | 2.18214 | 1.40864 | 5.58151 | 0.57485 | 0.345091 | 0.999999 | 1.136235e-07 | PASS |
  | `sf_27c_vlogic2p97v-vdrv4p50v` | 2.9949 | 1.99441 | 1.95201 | 1.07785 | 4.27177 | 0.807696 | 0.443332 | 0.999998 | 1.821966e-07 | PASS |
  | `sf_27c_vlogic3p30v-vdrv5p00v` | 3.3253 | 2.26241 | 2.23154 | 1.19422 | 4.73281 | 0.775484 | 0.385655 | 0.999999 | 1.639302e-07 | PASS |
  | `sf_27c_vlogic3p63v-vdrv5p50v` | 3.65568 | 2.54332 | 2.51242 | 1.30845 | 5.18647 | 0.753917 | 0.33954 | 0.999999 | 1.561760e-07 | FAIL — vgate_thinox_max max=3.63 (got 3.65568) |
  | `sf_27c_vlogic3p30v-vdrv6p00v` | 3.3253 | 2.27437 | 2.2439 | 1.38976 | 5.50607 | 0.660933 | 0.38926 | 0.999999 | 1.505041e-07 | PASS |
  | `sf_125c_vlogic2p97v-vdrv4p50v` | 2.99823 | 2.10116 | 2.03867 | 1.0621 | 4.20887 | 0.984197 | 0.51466 | 0.999998 | 2.448076e-07 | PASS |
  | `sf_125c_vlogic3p30v-vdrv5p00v` | 3.32849 | 2.37032 | 2.31196 | 1.17463 | 4.65458 | 0.929833 | 0.450953 | 0.999998 | 2.306872e-07 | PASS |
  | `sf_125c_vlogic3p63v-vdrv5p50v` | 3.65909 | 2.63992 | 2.58867 | 1.28446 | 5.09717 | 0.89032 | 0.399742 | 0.999998 | 2.204049e-07 | FAIL — vgate_thinox_max max=3.63 (got 3.65909) |
  | `sf_125c_vlogic3p30v-vdrv6p00v` | 3.32861 | 2.38375 | 2.32652 | 1.36186 | 5.39452 | 0.782139 | 0.453265 | 0.999998 | 2.129305e-07 | PASS |

  Spread across the grid:

  | measurement | min | max | mean | spread % | limits |
  |---|---|---|---|---|---|
  | `vgate_thinox_max` | 2.98947 (`ff_-40c_vlogic2p97v-vdrv4p50v`) | 3.66471 (`ss_125c_vlogic3p63v-vdrv5p50v`) | 3.32654 | 20.2987 | max=3.63 |
  | `vna_peak` | 1.89352 (`ss_-40c_vlogic2p97v-vdrv4p50v`) | 2.7716 (`ff_125c_vlogic3p63v-vdrv5p50v`) | 2.34847 | 37.3893 | — |
  | `vnb_peak` | 1.86455 (`ss_-40c_vlogic2p97v-vdrv4p50v`) | 2.75254 (`ff_125c_vlogic3p63v-vdrv5p50v`) | 2.31544 | 38.3509 | — |
  | `vccomp_dev_max` | 1.05815 (`ff_125c_vlogic2p97v-vdrv4p50v`) | 1.44617 (`ss_-40c_vlogic3p30v-vdrv6p00v`) | 1.2547 | 30.9257 | max=6 |
  | `vccomp_stack_max` | 4.193 (`ff_125c_vlogic2p97v-vdrv4p50v`) | 5.73273 (`ss_-40c_vlogic3p30v-vdrv6p00v`) | 4.97297 | 30.9619 | — |
  | `t_plh_ns` | 0.486825 (`ff_-40c_vlogic3p30v-vdrv6p00v`) | 1.33124 (`ss_125c_vlogic2p97v-vdrv4p50v`) | 0.798745 | 105.718 | — |
  | `t_phl_ns` | 0.2482 (`ff_-40c_vlogic3p63v-vdrv5p50v`) | 0.651406 (`ss_125c_vlogic2p97v-vdrv4p50v`) | 0.405482 | 99.4386 | — |
  | `vout_hi_ratio` | 0.999997 (`ss_125c_vlogic2p97v-vdrv4p50v`) | 0.999999 (`ff_-40c_vlogic3p30v-vdrv5p00v`) | 0.999998 | 1.888893e-04 | min=0.95 |
  | `vout_lo_ratio` | 9.672473e-08 (`ff_-40c_vlogic3p30v-vdrv6p00v`) | 2.552260e-07 (`ss_125c_vlogic2p97v-vdrv4p50v`) | 1.581788e-07 | 100.204 | max=0.05 |

  - **Overall: FAIL** — the same 15 process x temperature points at the
    `vlogic3p63v` (+10%) corner exceed the 3.63 V thin-oxide ceiling as
    every record of the schematic-level `level-shifter-oxide-safety`
    experiment (decision record 0003/0015, spec §5 Exception 1) — not a new
    finding, not reopened here. All other checks (`vccomp_dev_max`,
    `vout_hi_ratio`, `vout_lo_ratio`) pass at all 60 points.

  ### Finding: first post-layout evidence for spec §5 Exception 1 -- `inb`'s overshoot is inside decision record 0015's <=3.670 V bound (issue #235)

  This is the first post-layout record of spec §5 Exception 1 (`inb`'s own
  internal overshoot above `VDD_LOGIC`, decision records 0003/0015) --
  previously schematic-only
  (`sim/level-shifter-oxide-safety/records/20260818-071216-5260603.md`).
  `vgate_thinox_max` at each `vlogic3p63v-vdrv5p50v` point is `dq1 =
  |v(IN)-v(x1_inb)|` (same dominant term as the schematic facet's own
  `dq1`), so the table below reads directly as `inb`'s excursion above the
  3.63 V rail, in the same form decision record 0003 states Exception 1:

  | corner-id | schematic `5260603` | this record (extracted, no-RC) | delta (mV) |
  |---|---|---|---|
  | `tt_-40c` | 3.65379 | 3.65367 | -0.12 |
  | `tt_27c` | 3.65731 | 3.65706 | -0.25 |
  | `tt_125c` | 3.65996 | 3.65967 | -0.29 |
  | `ff_-40c` | 3.65034 | 3.65036 | +0.02 |
  | `ff_27c` | 3.65324 | 3.65293 | -0.31 |
  | `ff_125c` | 3.65500 | 3.65451 | -0.49 |
  | `ss_-40c` | 3.65780 | 3.65770 | -0.10 |
  | `ss_27c` | 3.66209 | 3.66179 | -0.30 |
  | `ss_125c` | **3.66533** | **3.66471** | -0.62 |
  | `fs_-40c` | 3.65526 | 3.65499 | -0.27 |
  | `fs_27c` | 3.65776 | 3.65712 | -0.64 |
  | `fs_125c` | 3.66005 | 3.65941 | -0.64 |
  | `sf_-40c` | 3.65244 | 3.65237 | -0.07 |
  | `sf_27c` | 3.65595 | 3.65568 | -0.27 |
  | `sf_125c` | 3.65944 | 3.65909 | -0.35 |

  The binding corner is unchanged (`ss_125c_vlogic3p63v-vdrv5p50v`, same as
  every schematic-level record of this experiment) and the extraction-only
  delta is small and, at every point but one, favorable (-0.62 mV at the
  binding corner; the no-RC extraction adds real device junction geometry
  and the rebound `nfet_03v3`/`pfet_03v3` models but no interconnect
  parasitics). **The result: 3.66471 V is 34.71 mV over the 3.63 V rail --
  inside decision record 0015's <=40 mV (<=3.670 V) ratified bound**, with
  ~5.3 mV of margin remaining. `vna_peak`/`vnb_peak` (worst 2.7716 V /
  2.75254 V, both `ff_125c_vlogic3p63v-vdrv5p50v`) sit ~0.86-0.88 V under
  the 3.63 V ceiling at every one of the 60 points -- not a close call, and
  matching the schematic facet's own `vna_peak`/`vnb_peak` worst (2.783 V /
  2.7651 V) to within ~0.01-0.02 V. The FAIL pattern (15/60 points, all
  `vlogic3p63v-vdrv5p50v`) is corner-for-corner identical to the schematic
  facet's, confirming extraction does not change *which* corners fail spec
  §2.3's uniform 3.63 V check, only the margin against decision record
  0015's separately-ratified Exception 1 band. See the RC record
  (`20260910-021137-b6ec657`) for the extraction-with-parasitics comparison.
- **Links**:
  - Testbench: `sim/level-shifter-oxide-safety-postlayout/testbench/gate_driver_core_level_shifter_oxide_tb.spice`, `sim/level-shifter-oxide-safety-postlayout/testbench/tb.json`
  - DUT netlist: `layout/lvs/gate_driver_core.extracted.spice`
  - Netlist snapshot: `sim/level-shifter-oxide-safety-postlayout/netlist-snapshots/20260910-011224-b6ec657.spice`
  - Raw logs: `sim/level-shifter-oxide-safety-postlayout/corners/20260910-011224-b6ec657/`
- **Timestamp / author**: 2026-09-10T01:12:24+00:00, ubuntu
- **Supersedes**: (none)

## Environment

Everything needed to re-run this record:

- PDK: gf180mcuD @ open_pdks `c6d73a35f524070e85faff4a6a9eef49553ebc2b` (/home/ubuntu/.volare/gf180mcuD, found via search_root:~/.volare)
- ngspice: ngspice-46 : Circuit level simulation program
- Transient tolerance: reltol=1e-4 (harness default)
- Harness: sim/harness 0.2.0, python 3.12.3
- git: `b6ec657f2b4101d0566a0a86ec463e2afcc5f52e` on `feature/issue-235` (clean)
- Testbench netlist sha256: `8465688bc638412c161ab47f0ca380b4a59009b860f4e525306f3e1841c14014`
- DUT netlist: `layout/lvs/gate_driver_core.extracted.spice` sha256 `38db5253dee283f4da9c88b9d42b4dcef114ecaa480fb0ce650e8cd2737f9bfa`
- Manifest sha256: `691c7e2cc618a13947c4f6495aae33d1146550c474b0eca6a2004660571d9d7d`
- Wall time: 61.79 s

Per-corner model sections used:

- `tt`: typical res_typical bjt_typical diode_typical moscap_typical mimcap_typical
- `ff`: ff res_ff bjt_ff diode_ff moscap_ff mimcap_ff
- `ss`: ss res_ss bjt_ss diode_ss moscap_ss mimcap_ss
- `fs`: fs res_typical bjt_typical diode_typical moscap_typical mimcap_typical
- `sf`: sf res_typical bjt_typical diode_typical moscap_typical mimcap_typical

---

Written by `sim/run_corners.py`. Append-only: never edit or delete this
file — a re-run or correction mints a new record-id and points back here
via **Supersedes** (see `sim/README.md`).
