2AMLogic/gf180-gate-driver/sim/level-shifter-oxide-safety-postlayout/records/20260910-021137-b6ec657.md

# Record 20260910-021137-b6ec657

- **Record ID**: 20260910-021137-b6ec657
- **Claim**: spec/gate-driver.md#4-level-shifter-topology-33-v-logic--56-v-drive-rail; spec/gate-driver.md#23-dc-gate-voltage-ceiling-thin-oxide-vs-thick-oxide
- **Netlist provenance**: extracted — DUT `layout/lvs/gate_driver_core.extracted-rc.spice` (sha256 `6f0c9b8e1b9b53549c739876a44e3e9ca3ebd4ec846fd687f5530f96f29db97e`), driven by `sim/level-shifter-oxide-safety-postlayout/testbench/gate_driver_core_level_shifter_oxide_tb.spice`
- **Corner matrix run**:
  - Process: tt, ff, ss, fs, sf
  - Temperature: -40 °C, 27 °C, 125 °C
  - Supply (vlogic, nominal 3.30 V): 2.97 V, 3.30 V, 3.63 V
  - Supply (vdrv, nominal 5.00 V): 4.50 V, 5.00 V, 5.50 V, 6.00 V
  - 60 point grid (process x temperature x tied two-rail supply point -- see sim/README.md), 60 completed
  - Full PVT matrix per CLAUDE.md (−40/27/125 °C, ±10 % on every rail, process corners).
- **Statistical convention**: N/A (corner-matrix claim, not a distribution claim)
- **Result**:

  | corner-id | vgate_thinox_max | vna_peak | vnb_peak | vccomp_dev_max | vccomp_stack_max | t_plh_ns | t_phl_ns | vout_hi_ratio | vout_lo_ratio | pass/fail |
  |---|---|---|---|---|---|---|---|---|---|---|
  | `tt_-40c_vlogic2p97v-vdrv4p50v` | 2.98082 | 1.89584 | 1.82124 | 1.04119 | 3.7705 | 6.02862 | 3.34315 | 0.999994 | 2.324984e-07 | PASS |
  | `tt_-40c_vlogic3p30v-vdrv5p00v` | 3.31072 | 2.17388 | 2.10125 | 1.14017 | 4.11994 | 5.59218 | 3.10925 | 0.999995 | 2.134398e-07 | PASS |
  | `tt_-40c_vlogic3p63v-vdrv5p50v` | 3.64065 | 2.45579 | 2.38596 | 1.23825 | 4.4662 | 5.26342 | 2.93312 | 0.999995 | 2.083376e-07 | FAIL — vgate_thinox_max max=3.63 (got 3.64065) |
  | `tt_-40c_vlogic3p30v-vdrv6p00v` | 3.31072 | 2.18668 | 2.1149 | 1.30976 | 4.70343 | 5.15674 | 3.43535 | 0.999995 | 2.046297e-07 | PASS |
  | `tt_27c_vlogic2p97v-vdrv4p50v` | 2.98037 | 1.97903 | 1.87843 | 1.04876 | 3.80456 | 6.81416 | 3.62842 | 0.999993 | 2.570340e-07 | PASS |
  | `tt_27c_vlogic3p30v-vdrv5p00v` | 3.31029 | 2.25446 | 2.1572 | 1.14873 | 4.15825 | 6.29543 | 3.37708 | 0.999994 | 2.483662e-07 | PASS |
  | `tt_27c_vlogic3p63v-vdrv5p50v` | 3.64002 | 2.53456 | 2.43999 | 1.24738 | 4.50697 | 5.90178 | 3.18515 | 0.999994 | 2.421078e-07 | FAIL — vgate_thinox_max max=3.63 (got 3.64002) |
  | `tt_27c_vlogic3p30v-vdrv6p00v` | 3.31029 | 2.26866 | 2.17238 | 1.31777 | 4.73993 | 5.71801 | 3.65816 | 0.999994 | 2.376097e-07 | PASS |
  | `tt_125c_vlogic2p97v-vdrv4p50v` | 2.97936 | 2.08989 | 1.95551 | 1.05108 | 3.81767 | 7.92281 | 4.04948 | 0.999992 | 3.175580e-07 | PASS |
  | `tt_125c_vlogic3p30v-vdrv5p00v` | 3.30937 | 2.36205 | 2.23221 | 1.15172 | 4.17464 | 7.28927 | 3.77921 | 0.999992 | 3.062914e-07 | PASS |
  | `tt_125c_vlogic3p63v-vdrv5p50v` | 3.63928 | 2.63794 | 2.51235 | 1.25041 | 4.52391 | 6.80177 | 3.56836 | 0.999993 | 2.981900e-07 | FAIL — vgate_thinox_max max=3.63 (got 3.63928) |
  | `tt_125c_vlogic3p30v-vdrv6p00v` | 3.30926 | 2.378 | 2.24947 | 1.31827 | 4.74657 | 6.53324 | 4.03748 | 0.999993 | 2.924057e-07 | PASS |
  | `ff_-40c_vlogic2p97v-vdrv4p50v` | 2.97877 | 2.01151 | 1.93981 | 1.00582 | 3.6229 | 5.09065 | 2.87141 | 0.999995 | 2.086075e-07 | PASS |
  | `ff_-40c_vlogic3p30v-vdrv5p00v` | 3.30873 | 2.29293 | 2.22385 | 1.10265 | 3.96362 | 4.77339 | 2.70906 | 0.999995 | 2.031010e-07 | PASS |
  | `ff_-40c_vlogic3p63v-vdrv5p50v` | 3.63862 | 2.57856 | 2.51193 | 1.19813 | 4.29908 | 4.53132 | 2.58519 | 0.999995 | 1.991591e-07 | FAIL — vgate_thinox_max max=3.63 (got 3.63862) |
  | `ff_-40c_vlogic3p30v-vdrv6p00v` | 3.30873 | 2.30786 | 2.23952 | 1.27019 | 4.53988 | 4.44442 | 3.02925 | 0.999996 | 1.963722e-07 | PASS |
  | `ff_27c_vlogic2p97v-vdrv4p50v` | 2.97827 | 2.09306 | 1.99711 | 1.01289 | 3.6547 | 5.71039 | 3.09382 | 0.999994 | 2.401431e-07 | PASS |
  | `ff_27c_vlogic3p30v-vdrv5p00v` | 3.30818 | 2.3727 | 2.27954 | 1.11001 | 3.99733 | 5.33339 | 2.92076 | 0.999994 | 2.335182e-07 | PASS |
  | `ff_27c_vlogic3p63v-vdrv5p50v` | 3.63798 | 2.65621 | 2.56577 | 1.20553 | 4.33339 | 5.04377 | 2.78657 | 0.999995 | 2.288433e-07 | FAIL — vgate_thinox_max max=3.63 (got 3.63798) |
  | `ff_27c_vlogic3p30v-vdrv6p00v` | 3.30812 | 2.38917 | 2.29682 | 1.2752 | 4.56393 | 4.90022 | 3.20706 | 0.999995 | 2.256065e-07 | PASS |
  | `ff_125c_vlogic2p97v-vdrv4p50v` | 2.97714 | 2.17166 | 2.07355 | 1.01453 | 3.6655 | 6.58439 | 3.43024 | 0.999992 | 2.961422e-07 | PASS |
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
  | `fs_125c_vlogic3p30v-vdrv6p00v` | 3.30817 | 2.4427 | 2.33724 | 1.35847 | 4.91404 | 6.65257 | 3.84729 | 0.999992 | 2.790942e-07 | PASS |
  | `sf_-40c_vlogic2p97v-vdrv4p50v` | 2.98161 | 1.80929 | 1.73242 | 1.01114 | 3.6458 | 6.01035 | 3.57556 | 0.999995 | 2.319633e-07 | PASS |
  | `sf_-40c_vlogic3p30v-vdrv5p00v` | 3.31164 | 2.08345 | 2.0086 | 1.10933 | 3.99195 | 5.57511 | 3.30787 | 0.999995 | 2.900528e-07 | PASS |
  | `sf_-40c_vlogic3p63v-vdrv5p50v` | 3.64134 | 2.36144 | 2.2899 | 1.20641 | 4.33369 | 5.24949 | 3.10715 | 0.999995 | 2.178285e-07 | FAIL — vgate_thinox_max max=3.63 (got 3.64134) |
  | `sf_-40c_vlogic3p30v-vdrv6p00v` | 3.31163 | 2.09412 | 2.01996 | 1.25647 | 4.48556 | 5.31587 | 3.82529 | 0.999996 | 2.132745e-07 | PASS |
  | `sf_27c_vlogic2p97v-vdrv4p50v` | 2.98134 | 1.89253 | 1.78956 | 1.01873 | 3.67933 | 6.73061 | 3.84119 | 0.999994 | 3.316924e-07 | PASS |
  | `sf_27c_vlogic3p30v-vdrv5p00v` | 3.3113 | 2.16473 | 2.06458 | 1.11735 | 4.02768 | 6.22576 | 3.56088 | 0.999994 | 2.635728e-07 | PASS |
  | `sf_27c_vlogic3p63v-vdrv5p50v` | 3.64123 | 2.4411 | 2.34393 | 1.21459 | 4.37045 | 5.84384 | 3.34789 | 0.999994 | 2.558336e-07 | FAIL — vgate_thinox_max max=3.63 (got 3.64123) |
  | `sf_27c_vlogic3p30v-vdrv6p00v` | 3.3113 | 2.17661 | 2.07732 | 1.26459 | 4.5213 | 5.82292 | 4.00975 | 0.999995 | 2.501630e-07 | PASS |
  | `sf_125c_vlogic2p97v-vdrv4p50v` | 2.98053 | 2.00934 | 1.86668 | 1.0203 | 3.68898 | 7.77097 | 4.26131 | 0.999992 | 3.450938e-07 | PASS |
  | `sf_125c_vlogic3p30v-vdrv5p00v` | 3.31056 | 2.27801 | 2.13998 | 1.11898 | 4.03787 | 7.16373 | 3.96443 | 0.999993 | 3.309832e-07 | PASS |
  | `sf_125c_vlogic3p63v-vdrv5p50v` | 3.64054 | 2.55063 | 2.41664 | 1.21572 | 4.37906 | 6.69611 | 3.73436 | 0.999993 | 3.207095e-07 | FAIL — vgate_thinox_max max=3.63 (got 3.64054) |
  | `sf_125c_vlogic3p30v-vdrv6p00v` | 3.31056 | 2.29143 | 2.15441 | 1.26351 | 4.5207 | 6.59666 | 4.3853 | 0.999993 | 3.132563e-07 | PASS |

  Spread across the grid:

  | measurement | min | max | mean | spread % | limits |
  |---|---|---|---|---|---|
  | `vgate_thinox_max` | 2.97714 (`ff_125c_vlogic2p97v-vdrv4p50v`) | 3.64277 (`ss_-40c_vlogic3p63v-vdrv5p50v`) | 3.3101 | 20.1089 | max=3.63 |
  | `vna_peak` | 1.77769 (`ss_-40c_vlogic2p97v-vdrv4p50v`) | 2.72318 (`ff_125c_vlogic3p63v-vdrv5p50v`) | 2.26325 | 41.7757 | — |
  | `vnb_peak` | 1.6988 (`ss_-40c_vlogic2p97v-vdrv4p50v`) | 2.63639 (`ff_125c_vlogic3p63v-vdrv5p50v`) | 2.16615 | 43.2837 | — |
  | `vccomp_dev_max` | 1.00582 (`ff_-40c_vlogic2p97v-vdrv4p50v`) | 1.36534 (`ss_125c_vlogic3p30v-vdrv6p00v`) | 1.1871 | 30.2855 | max=6 |
  | `vccomp_stack_max` | 3.6229 (`ff_-40c_vlogic2p97v-vdrv4p50v`) | 4.94232 (`ss_125c_vlogic3p30v-vdrv6p00v`) | 4.28858 | 30.7659 | — |
  | `t_plh_ns` | 4.44442 (`ff_-40c_vlogic3p30v-vdrv6p00v`) | 9.84692 (`ss_125c_vlogic2p97v-vdrv4p50v`) | 6.38829 | 84.5688 | — |
  | `t_phl_ns` | 2.58519 (`ff_-40c_vlogic3p63v-vdrv5p50v`) | 4.94243 (`ss_125c_vlogic2p97v-vdrv4p50v`) | 3.57356 | 65.9635 | — |
  | `vout_hi_ratio` | 0.99999 (`ss_125c_vlogic2p97v-vdrv4p50v`) | 0.999996 (`ff_-40c_vlogic3p30v-vdrv6p00v`) | 0.999994 | 5.666707e-04 | min=0.95 |
  | `vout_lo_ratio` | 1.963722e-07 (`ff_-40c_vlogic3p30v-vdrv6p00v`) | 3.548993e-07 (`ss_125c_vlogic2p97v-vdrv4p50v`) | 2.589284e-07 | 61.2243 | max=0.05 |

  - **Overall: FAIL** — the same 15 process x temperature points at the
    `vlogic3p63v` (+10%) corner exceed the 3.63 V thin-oxide ceiling as
    every record of this claim (decision record 0003/0015, spec §5
    Exception 1) — not a new finding, not reopened here. All other checks
    (`vccomp_dev_max`, `vout_hi_ratio`, `vout_lo_ratio`) pass at all 60
    points.

  ### Finding: RC parasitics shrink the Exception 1 overshoot by an order of magnitude, and shift the binding corner from `ss_125c` to `ss_-40c` (issue #235)

  Same `dq1 = |v(IN)-v(x1_inb)|`-dominated reading of `vgate_thinox_max` at
  the 15 `vlogic3p63v-vdrv5p50v` points as the no-RC record's own Finding
  (`20260910-011224-b6ec657`), now against the schematic and both extracted
  DUTs:

  | corner-id | schematic `5260603` | no-RC (`20260910-011224-b6ec657`) | RC (this record) | RC delta vs. schematic (mV) |
  |---|---|---|---|---|
  | `tt_-40c` | 3.65379 | 3.65367 | 3.64065 | -13.14 |
  | `tt_27c` | 3.65731 | 3.65706 | 3.64002 | -17.29 |
  | `tt_125c` | 3.65996 | 3.65967 | 3.63928 | -20.68 |
  | `ff_-40c` | 3.65034 | 3.65036 | 3.63862 | -11.72 |
  | `ff_27c` | 3.65324 | 3.65293 | 3.63798 | -15.26 |
  | `ff_125c` | 3.65500 | 3.65451 | 3.63708 | -17.92 |
  | `ss_-40c` | 3.65780 | 3.65770 | **3.64277** | -15.03 |
  | `ss_27c` | 3.66209 | 3.66179 | 3.64239 | -19.70 |
  | `ss_125c` | **3.66533** | **3.66471** | 3.64170 | -23.63 |
  | `fs_-40c` | 3.65526 | 3.65499 | 3.63955 | -15.71 |
  | `fs_27c` | 3.65776 | 3.65712 | 3.63901 | -18.75 |
  | `fs_125c` | 3.66005 | 3.65941 | 3.63783 | -22.22 |
  | `sf_-40c` | 3.65244 | 3.65237 | 3.64134 | -11.10 |
  | `sf_27c` | 3.65595 | 3.65568 | 3.64123 | -14.72 |
  | `sf_125c` | 3.65944 | 3.65909 | 3.64054 | -18.90 |

  The RC parasitics `klt extract --parasitics` adds on top of the no-RC
  extraction -- per-net leg resistance and net-to-ground capacitance, see
  `layout/README.md`'s "Post-layout simulation" -- damp `inb`'s overshoot
  substantially at every one of the 15 `vlogic3p63v-vdrv5p50v` points
  (11-24 mV lower than the schematic figure, versus under 1 mV for the
  no-RC extraction), the same direction decision record 0019 already
  reported for the inherited -50 mV undershoot band on the output stage's
  taper nodes. The worst RC point is **`ss_-40c_vlogic3p63v-vdrv5p50v` at
  3.64277 V (12.77 mV over the 3.63 V rail)** -- a *different* binding
  corner than every other record of this claim (schematic and no-RC both
  bind at `ss_125c`): RC's damping is itself temperature-dependent (compare
  `ss_125c`'s -23.63 mV delta against `ss_-40c`'s -15.03 mV), enough to
  overturn the -40 degC/125 degC ordering the schematic and no-RC records
  share for the `ss` corner specifically. Either way, **3.64277 V is
  12.77 mV over the 3.63 V rail -- well inside decision record 0015's
  <=40 mV (<=3.670 V) bound**, 27.23 mV of margin remaining, the largest
  margin of any record of this claim to date. `vna_peak`/`vnb_peak` (worst
  2.72318 V / 2.63639 V, both `ff_125c_vlogic3p63v-vdrv5p50v`) remain
  comfortably under the 3.63 V ceiling at all 60 points, same conclusion as
  the schematic and no-RC facets.

  `vccomp_dev_max`/`vccomp_stack_max` (worst 1.36534 V / 4.94232 V, both
  `ss_125c_vlogic3p30v-vdrv6p00v`) stay well under the 6 V MiM rating
  (decision record 0014) at every point in both extracted DUTs; the two
  functional ratio checks (`vout_hi_ratio`, `vout_lo_ratio` -- measured at
  `IN_DRV`, the level shifter's own output pin in this flat DUT, rather
  than the schematic facet's `out`) pass at all 60 points in both DUTs as
  well. `t_plh_ns`/`t_phl_ns` are markedly longer here than in either the
  schematic or the no-RC record (~5-10 ns here vs. ~0.5-1.3 ns for both of
  those, which measure the same `IN`->`IN_DRV`/`out` path through the same
  extracted device topology as this record but without interconnect
  parasitics) -- the added per-net RC (295 net-to-ground capacitors, 6128
  leg resistors, same extraction this record's `inb`-damping finding above
  already attributes to) slows this signal path's own edges, not a
  DUT-topology change. Expected from adding parasitics, not a regression,
  and not a checked column (`checks` has no `t_plh_ns`/`t_phl_ns` bound in
  either facet).
- **Links**:
  - Testbench: `sim/level-shifter-oxide-safety-postlayout/testbench/gate_driver_core_level_shifter_oxide_tb.spice`, `sim/level-shifter-oxide-safety-postlayout/testbench/tb.json`
  - DUT netlist: `layout/lvs/gate_driver_core.extracted-rc.spice`
  - Netlist snapshot: `sim/level-shifter-oxide-safety-postlayout/netlist-snapshots/20260910-021137-b6ec657.spice`
  - Raw logs: `sim/level-shifter-oxide-safety-postlayout/corners/20260910-021137-b6ec657/`
- **Timestamp / author**: 2026-09-10T02:11:37+00:00, ubuntu
- **Supersedes**: (none)

## Environment

Everything needed to re-run this record:

- PDK: gf180mcuD @ open_pdks `c6d73a35f524070e85faff4a6a9eef49553ebc2b` (/home/ubuntu/.volare/gf180mcuD, found via search_root:~/.volare)
- ngspice: ngspice-46 : Circuit level simulation program
- Transient tolerance: reltol=1e-4 (harness default)
- Harness: sim/harness 0.2.0, python 3.12.3
- git: `b6ec657f2b4101d0566a0a86ec463e2afcc5f52e` on `feature/issue-235` (clean)
- Testbench netlist sha256: `8465688bc638412c161ab47f0ca380b4a59009b860f4e525306f3e1841c14014`
- DUT netlist: `layout/lvs/gate_driver_core.extracted-rc.spice` sha256 `6f0c9b8e1b9b53549c739876a44e3e9ca3ebd4ec846fd687f5530f96f29db97e`
- Manifest sha256: `691c7e2cc618a13947c4f6495aae33d1146550c474b0eca6a2004660571d9d7d`
- Wall time: 2293.53 s

Per-corner model sections used:

- `tt`: typical res_typical bjt_typical diode_typical moscap_typical mimcap_typical
- `ff`: ff res_ff bjt_ff diode_ff moscap_ff mimcap_ff
- `ss`: ss res_ss bjt_ss diode_ss moscap_ss mimcap_ss
- `fs`: fs res_typical bjt_typical diode_typical moscap_typical mimcap_typical
- `sf`: sf res_typical bjt_typical diode_typical moscap_typical mimcap_typical

---

Written by `sim/run_corners.py`. Append-only: never edit or delete this
file — a re-run or correction mints a new record-id and points back here
via **Supersedes** (see `sim/README.md`).
