2AMLogic/gf180-gate-driver/ratification/market-key/comps/gate-driver.md

# gate-driver comp data (generated, public-sources-only)

Generated 2026-08-27 from the upstream comp library's `gate-driver.md` entry by an internal, private-repo-only tool. This is a derived, filtered copy — regenerate rather than hand-edit. Every row below cites a public vendor datasheet or a public distributor pricing page; nothing internal survived extraction.

## Comparable parts

| Vendor | Part | Class | VDD range | Peak source/sink | Prop delay (typ) | Package | Price | Source |
|---|---|---|---|---|---|---|---|---|
| Texas Instruments | UCC27517 | Single-channel high-speed low-side driver | 4.5–18 V | 4 A / 4 A (symmetrical) | 13 ns (rise 9 ns / fall 7 ns typ) | SOT-23-5 | $0.3621 (5+), $0.198 (6000+) — UCC27517DBVR | Datasheet: [ti.com/lit/ds/symlink/ucc27517.pdf](https://www.ti.com/lit/ds/symlink/ucc27517.pdf) (SLUSAY4D). Pricing: [LCSC C99395](https://www.lcsc.com/product-detail/Gate-Drive-ICs_Texas-Instruments-UCC27517DBVR_C99395.html) |
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
