2AMLogic/gf180-gate-driver/sim/uvlo-trip-verification/records/20260826-013053-6299c36.md

# Record 20260826-013053-6299c36

- **Record ID**: 20260826-013053-6299c36
- **Claim**: Substantiates spec/gate-driver.md Sec.5 (drive-rail UVLO, in scope for this increment) against the numeric targets ratified by spec/decision-records/0001-block-interface-and-uvlo-parameters.md Decisions 4 (trip thresholds/hysteresis) and 5 (response time) -- the first PVT verification of design/uvlo.sch since it was captured (issue #220). Every threshold/hysteresis/response-time number in decision record 0001 was a **design target**, not yet a verified result, before this record.
- **Extraction method**: **Rising/falling trip voltage and hysteresis** -- a transient triangle-wave ramp of VDD_DRV (0V -> 6V over 20us, then back to 0V over another 20us; quasi-static relative to the comparator's own bandwidth) with `design/netlist/uvlo.spice`'s internal `lockout` node (the active-high OUT-pulldown-enable signal) crossing a fixed 1.5V absolute level -- well below every measured corner's trip voltage and safely above 0V, so a single fixed threshold is valid across the whole grid. A raw `.dc` sweep was tried first and rejected: this comparator is a regenerative positive-feedback (Schmitt-trigger) circuit by design (decision record 0001 Decision 4's hysteresis), and a `.dc` sweep's nonlinear-operating-point continuation becomes numerically close to singular near the flip point, requiring repeated gmin-stepping recovery at nearly every point in the transition region -- observed directly while developing this script to take minutes or longer per corner. See `run_uvlo_trip.py`'s module docstring for the full account. **Response time** -- a fast (1ns) VDD_DRV step (6.0V -> 1.8V at 500ns), measuring the delay from VDD_DRV crossing *that corner's own measured falling threshold* (from the hysteresis sweep above) to OUT reaching a 0.5V low proxy level, with a weak (100k) pull-up plus a small (6fF) load capacitance on OUT standing in for "something external trying to hold OUT high" -- output_stage's own specific drive strength is arbitrated separately by `sim/gate-driver-core-drive-with-uvlo/` (issue #220 deliverable 4), not by this standalone cell.
- **Netlist provenance**: schematic (`design/netlist/uvlo.spice`, from `design/uvlo.sch`) -- pre-layout, no extracted parasitics.
- **Corner matrix run**:
  - Process: typical, ff, ss, fs, sf (the top-level MOS `.LIB` sections, same five names sim/harness/corners.py's module docstring confirms already skew the thick-oxide nfet_06v0/pfet_06v0 family this cell is built from entirely)
  - Temperature: -40 C, 27 C, 125 C
  - Supply: **VDD_DRV itself is the swept quantity** (0V -> 6V internal transient ramp per corner point), not a +/-10% tied-supply grid -- this cell has no independent supply rail to hold at a fixed tolerance point while VDD_DRV is what is under test. Per `sim/README.md`'s `nosupply` convention (inherited from 2AMLogic/gf180-bandgap's device-characterization scripts), the corner-log filenames carry `nosupply` in the supply field. This is the explicit subset justification `sim/README.md` requires.
  - 15 corner points (5 process x 3 temperature) -- full process/temperature axes of the CLAUDE.md PVT matrix, each internally sweeping the full VDD_DRV range.
- **Statistical convention**: N/A -- corner matrix, not a Monte Carlo/mismatch claim.
- **Result**: see the per-corner table below; overall verdict at the end.

### Rising / falling trip voltage, hysteresis, response time

Decision record 0001 Decision 4: falling typ 3.6V / worst-case corner range 3.3-3.9V; rising typ 3.9V / worst-case corner range 3.6-4.2V; hysteresis typ 300mV (no stated worst-case *range* for hysteresis, so it is reported but not scored, matching the convention `sim/device-mv-fet/run_device_mv_fet.py` uses for Cgg/Cgd/Ron). Decision 5: response time < 500ns, scored at every corner. Each point's verdict is **PASS** only if falling AND rising both land inside their stated worst-case range AND response time is under 500ns; a single measurement outside its bound fails that corner.

| corner | falling (V) | rising (V) | hysteresis (V) | response (ns) | falling verdict | rising verdict | response verdict | corner overall |
|---|---|---|---|---|---|---|---|---|
| `typical_-40c_nosupply` | 4.0052 | 4.3333 | 0.3281 | 165.1 | FAIL | FAIL | PASS | FAIL |
| `typical_27c_nosupply` | 3.6065 | 3.9306 | 0.3242 | 154.6 | PASS | PASS | PASS | PASS |
| `typical_125c_nosupply` | 3.0168 | 3.3406 | 0.3238 | 141.1 | FAIL | FAIL | PASS | FAIL |
| `ff_-40c_nosupply` | 3.2605 | 3.5425 | 0.2820 | 121.9 | FAIL | FAIL | PASS | FAIL |
| `ff_27c_nosupply` | 2.8487 | 3.1258 | 0.2770 | 113.2 | FAIL | FAIL | PASS | FAIL |
| `ff_125c_nosupply` | 2.2307 | 2.5034 | 0.2727 | 106.3 | FAIL | FAIL | PASS | FAIL |
| `ss_-40c_nosupply` | 4.7370 | 5.1148 | 0.3777 | 238.0 | FAIL | FAIL | PASS | FAIL |
| `ss_27c_nosupply` | 4.3515 | 4.7264 | 0.3749 | 225.6 | FAIL | FAIL | PASS | FAIL |
| `ss_125c_nosupply` | 3.7859 | 4.1616 | 0.3757 | 206.1 | PASS | PASS | PASS | PASS |
| `fs_-40c_nosupply` | 3.4679 | 3.7750 | 0.3071 | 171.8 | PASS | PASS | PASS | PASS |
| `fs_27c_nosupply` | 3.0599 | 3.3648 | 0.3049 | 162.1 | FAIL | FAIL | PASS | FAIL |
| `fs_125c_nosupply` | 2.4490 | 2.7571 | 0.3081 | 150.4 | FAIL | FAIL | PASS | FAIL |
| `sf_-40c_nosupply` | 4.5261 | 4.8760 | 0.3499 | 161.8 | FAIL | FAIL | PASS | FAIL |
| `sf_27c_nosupply` | 4.1372 | 4.4809 | 0.3437 | 150.8 | FAIL | FAIL | PASS | FAIL |
| `sf_125c_nosupply` | 3.5662 | 3.9062 | 0.3400 | 136.7 | PASS | PASS | PASS | PASS |

**4/15 corners PASS** all three checks (falling range, rising range, response time) against decision record 0001 Decisions 4-5's stated worst-case bounds.

**Finding (recorded honestly, per CLAUDE.md -- "agents do not relax the ratified spec to make results pass")**: the measured PVT spread of both thresholds is substantially wider than decision record 0001 Decision 4's targets, driven primarily by temperature -- the reference is a single diode-connected `nfet_06v0`'s Vgs (no bandgap, decision record 0001 Decision 5's own explicit tradeoff), and the divider's ~5x gain (needed to scale that ~0.7-0.8V reference up into the 3.3-4.2V trip-voltage range) amplifies the reference's own temperature/process spread by the same ~5x. See spec/decision-records/0018-uvlo-comparator-pvt-measurement.md for the full analysis, the specific corners that violate decision record 0001's stated worst-case bounds, and the safety implication (a false-trip risk at the slow/cold corner, where the rising threshold measured above the drive rail's -10% low-line floor).

- **Overall: FAIL** (4/15 corners pass all three checks; see spec/decision-records/0018-uvlo-comparator-pvt-measurement.md for the honest disposition of the failing corners -- this is not silently relaxed to a passing result)

- **Links**:
  - Testbench: `sim/uvlo-trip-verification/testbench/tb.json`, `sim/uvlo-trip-verification/testbench/uvlo_trip_tb.spice`
  - Run script: `sim/uvlo-trip-verification/run_uvlo_trip.py`
  - DUT: `design/netlist/uvlo.spice`
  - Netlist snapshot: `sim/uvlo-trip-verification/netlist-snapshots/20260826-013053-6299c36.spice`
  - Raw logs: `sim/uvlo-trip-verification/corners/20260826-013053-6299c36/`
  - PDK: gf180mcuD (/home/ubuntu/.volare/gf180mcuD), ngspice ngspice-46 : Circuit level simulation program
  - Transient tolerance: reltol=1e-4 (harness default, applied by hand -- see module docstring)
- **Timestamp / author**: 2026-08-26T01:30:53Z, agent-builder (issue #220)
- **Supersedes**: (none -- first record for this claim)
