2AMLogic/gf180-gate-driver/layout/lvs/reports/gate_driver_core/20260921-154640-86d17b3.extracted.spice

* extracted by klt extract --deck gf180mcu

* cell gate_driver_core
* pin GND_DRV
* pin GND_LOGIC
* pin IN
* pin IN_DRV
* pin OUT
* pin VDD_DRV
* pin VDD_LOGIC
* pin x1_inb
* pin x1_na
* pin x1_nb
* pin x1_nbuf1
* pin x1_nca
* pin x1_ncb
* pin x2_n1
* pin x2_n2
* pin x2_n3
* pin x2_n4
* pin x2_n5
* pin x3_lockout
* pin x3_ncompn
* pin x3_ncompp
* pin x3_ndiv
* pin x3_nref
* pin x3_ntail
* pin x3_uvlo_ok
.SUBCKT gate_driver_core GND_DRV GND_LOGIC IN IN_DRV OUT VDD_DRV VDD_LOGIC
+ x1_inb x1_na x1_nb x1_nbuf1 x1_nca x1_ncb x2_n1 x2_n2 x2_n3 x2_n4 x2_n5
+ x3_lockout x3_ncompn x3_ncompp x3_ndiv x3_nref x3_ntail x3_uvlo_ok
* device instance $1 r0 *1 0.56,2.5 nfet
M$1 x1_inb IN GND_LOGIC GND_LOGIC nfet L=0.28U W=5U AS=2.1P AD=2.1P PS=10.84U
+ PD=10.84U
* device instance $2 r0 *1 0.56,33.34 nfet
M$2 x1_na IN GND_LOGIC GND_LOGIC nfet L=0.28U W=20U AS=8.4P AD=8.4P PS=40.84U
+ PD=40.84U
* device instance $3 r0 *1 0.56,57.36 nfet
M$3 x1_nb x1_inb GND_LOGIC GND_LOGIC nfet L=0.28U W=20U AS=8.4P AD=8.4P
+ PS=40.84U PD=40.84U
* device instance $4 r0 *1 0.56,14.17 pfet
M$4 x1_inb IN VDD_LOGIC VDD_LOGIC pfet L=0.28U W=10U AS=4.2P AD=4.2P PS=20.84U
+ PD=20.84U
* device instance $5 r0 *1 0.77,98.18 nfet
M$5 x1_nca VDD_LOGIC x1_na GND_LOGIC nfet L=0.7U W=20U AS=8.4P AD=8.4P
+ PS=40.84U PD=40.84U
* device instance $6 r0 *1 0.77,122.2 nfet
M$6 x1_ncb VDD_LOGIC x1_nb GND_LOGIC nfet L=0.7U W=20U AS=8.4P AD=8.4P
+ PS=40.84U PD=40.84U
* device instance $7 r0 *1 0.77,162.68 nfet
M$7 x1_nbuf1 x1_ncb GND_DRV GND_LOGIC nfet L=0.7U W=5U AS=2.1P AD=2.1P
+ PS=10.84U PD=10.84U
* device instance $8 r0 *1 0.77,196.02 nfet
M$8 IN_DRV x1_nbuf1 GND_DRV GND_LOGIC nfet L=0.7U W=15U AS=6.3P AD=6.3P
+ PS=30.84U PD=30.84U
* device instance $9 r0 *1 0.77,217.26 nfet
M$9 x2_n1 IN_DRV GND_DRV GND_LOGIC nfet L=0.7U W=2U AS=0.84P AD=0.84P PS=4.84U
+ PD=4.84U
* device instance $10 r0 *1 0.77,248.6 nfet
M$10 x2_n2 x2_n1 GND_DRV GND_LOGIC nfet L=0.7U W=8U AS=3.36P AD=3.36P PS=16.84U
+ PD=16.84U
* device instance $11 r0 *1 0.77,350.44 nfet
M$11 x2_n3 x2_n2 GND_DRV GND_LOGIC nfet L=0.7U W=33U AS=13.86P AD=13.86P
+ PS=66.84U PD=66.84U
* device instance $12 r0 *1 0.77,392.74 nfet
M$12 x2_n4 x2_n3 GND_DRV GND_LOGIC nfet L=0.7U W=10U AS=4.2P AD=2.1P PS=20.84U
+ PD=10.42U
* device instance $13 r0 *1 1.89,392.74 nfet
M$13 GND_DRV x2_n3 x2_n4 GND_LOGIC nfet L=0.7U W=10U AS=2.1P AD=2.1P PS=10.42U
+ PD=10.42U
* device instance $14 r0 *1 3.01,392.74 nfet
M$14 x2_n4 x2_n3 GND_DRV GND_LOGIC nfet L=0.7U W=10U AS=2.1P AD=2.1P PS=10.42U
+ PD=10.42U
* device instance $15 r0 *1 4.13,392.74 nfet
M$15 GND_DRV x2_n3 x2_n4 GND_LOGIC nfet L=0.7U W=10U AS=2.1P AD=2.1P PS=10.42U
+ PD=10.42U
* device instance $16 r0 *1 5.25,392.74 nfet
M$16 x2_n4 x2_n3 GND_DRV GND_LOGIC nfet L=0.7U W=10U AS=2.1P AD=2.1P PS=10.42U
+ PD=10.42U
* device instance $17 r0 *1 6.37,392.74 nfet
M$17 GND_DRV x2_n3 x2_n4 GND_LOGIC nfet L=0.7U W=10U AS=2.1P AD=2.1P PS=10.42U
+ PD=10.42U
* device instance $18 r0 *1 7.49,392.74 nfet
M$18 x2_n4 x2_n3 GND_DRV GND_LOGIC nfet L=0.7U W=10U AS=2.1P AD=2.1P PS=10.42U
+ PD=10.42U
* device instance $19 r0 *1 8.61,392.74 nfet
M$19 GND_DRV x2_n3 x2_n4 GND_LOGIC nfet L=0.7U W=10U AS=2.1P AD=2.1P PS=10.42U
+ PD=10.42U
* device instance $20 r0 *1 9.73,392.74 nfet
M$20 x2_n4 x2_n3 GND_DRV GND_LOGIC nfet L=0.7U W=10U AS=2.1P AD=2.1P PS=10.42U
+ PD=10.42U
* device instance $21 r0 *1 10.85,392.74 nfet
M$21 GND_DRV x2_n3 x2_n4 GND_LOGIC nfet L=0.7U W=10U AS=2.1P AD=2.1P PS=10.42U
+ PD=10.42U
* device instance $22 r0 *1 11.97,392.74 nfet
M$22 x2_n4 x2_n3 GND_DRV GND_LOGIC nfet L=0.7U W=10U AS=2.1P AD=2.1P PS=10.42U
+ PD=10.42U
* device instance $23 r0 *1 13.09,392.74 nfet
M$23 GND_DRV x2_n3 x2_n4 GND_LOGIC nfet L=0.7U W=10U AS=2.1P AD=2.1P PS=10.42U
+ PD=10.42U
* device instance $24 r0 *1 14.21,392.74 nfet
M$24 x2_n4 x2_n3 GND_DRV GND_LOGIC nfet L=0.7U W=10U AS=2.1P AD=2.1P PS=10.42U
+ PD=10.42U
* device instance $25 r0 *1 15.33,392.74 nfet
M$25 GND_DRV x2_n3 x2_n4 GND_LOGIC nfet L=0.7U W=10U AS=2.1P AD=4.2P PS=10.42U
+ PD=20.84U
* device instance $26 r0 *1 0.77,424.36 nfet
M$26 x2_n5 x2_n4 GND_DRV GND_LOGIC nfet L=0.7U W=10U AS=4.2P AD=2.1P PS=20.84U
+ PD=10.42U
* device instance $27 r0 *1 1.89,424.36 nfet
M$27 GND_DRV x2_n4 x2_n5 GND_LOGIC nfet L=0.7U W=10U AS=2.1P AD=2.1P PS=10.42U
+ PD=10.42U
* device instance $28 r0 *1 3.01,424.36 nfet
M$28 x2_n5 x2_n4 GND_DRV GND_LOGIC nfet L=0.7U W=10U AS=2.1P AD=2.1P PS=10.42U
+ PD=10.42U
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
M$210 OUT x2_n5 GND_DRV GND_LOGIC nfet L=0.7U W=10U AS=2.1P AD=2.1P PS=10.42U
+ PD=10.42U
* device instance $211 r0 *1 84.77,455.98 nfet
M$211 GND_DRV x2_n5 OUT GND_LOGIC nfet L=0.7U W=10U AS=2.1P AD=2.1P PS=10.42U
+ PD=10.42U
* device instance $212 r0 *1 85.89,455.98 nfet
M$212 OUT x2_n5 GND_DRV GND_LOGIC nfet L=0.7U W=10U AS=2.1P AD=2.1P PS=10.42U
+ PD=10.42U
* device instance $213 r0 *1 87.01,455.98 nfet
M$213 GND_DRV x2_n5 OUT GND_LOGIC nfet L=0.7U W=10U AS=2.1P AD=2.1P PS=10.42U
+ PD=10.42U
* device instance $214 r0 *1 88.13,455.98 nfet
M$214 OUT x2_n5 GND_DRV GND_LOGIC nfet L=0.7U W=10U AS=2.1P AD=2.1P PS=10.42U
+ PD=10.42U
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
