2AMLogic/gf180-gate-driver/(commit log)

2026-08-05 Initial commit: high-voltage gate driver on gf180mcu
    Scaffolds the block: spec, schematics, ngspice sim, and klayout-tools-driven
    layout signoff.
    First block in the fleet to use the 5V/6V device flavors rather than the
    3.3V ones. Cross-domain level shifting between 3.3V logic and the 5V drive
    rail is the central design problem and belongs in the spec.
    Apache-2.0. Nothing designed yet.
    Claude-Session: https://claude.ai/code/session_018EY36KFUPii3rDqjw7fkrU
2026-08-05 docs: ratify gate-driver target spec with decision records (#2)
    Adds spec/gate-driver.md, ratified 2026-08-05, deciding and recording:
    low-side-only configuration, device flavor (6V0 model corner for the
    drive-rail devices, with a new finding that nfet_05v0/nfet_06v0 are the
    same physical device differentiated only by a model-selection mark
    layer), the DNWELL isolation constraint on level-shifter cells, drive
    strength/reference-load targets, the cascode/clamped level-shifter
    topology (with alternatives considered), and protection scope. Replaces
    the DRAFT spec table in README.md with a pointer to the ratified spec,
    and updates spec/README.md's placeholder.
    Closes #1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
2026-08-08 docs(spec): add decision record for block interface and UVLO parameters (#8)
    Fills two gaps in the ratified spec (spec/gate-driver.md is byte-for-byte
    unchanged): a full port list/interface definition so #6 and #7 can build
    against a shared, unambiguous pinout, and UVLO parameters (rising/falling
    trip thresholds, hysteresis, response time, output behavior, reference)
    numerically justified against the gf180mcu 6V0-corner device data cited
    in spec/gate-driver.md §2.5 and the DRM's temperature/supply-limit
    sections. Also ports the gf180-bandgap decision-record TEMPLATE.md
    convention and updates spec/README.md to point to both new documents.
    Closes #4
2026-08-08 feat: bootstrap the two-rail ngspice PVT sim harness from gf180-bandgap (#9)
    * feat: bootstrap the two-rail ngspice PVT sim harness from gf180-bandgap
    Port sim/harness/{pdk,corners,testbench,runner,report,evidence_lint,cli}.py
    and sim/{run_corners.py,check_records.py,pdk.json,env.sh} from
    2AMLogic/gf180-bandgap (per CLAUDE.md's harness-bootstrap instruction),
    adapting the single-supply corner grammar for this design's two independent
    rails (3.3 V logic, 5 V drive). The two rails are swept together (tied to
    the same relative tolerance offset) rather than full-factorially crossed, so
    the mandated PVT matrix keeps the same point count as the source harness's
    single-rail convention; corner-ids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
2026-08-08 chore(loom): give this canary an onIdle so an empty backlog is not a dead end
    This repo's config carried no `autonomous` block at all. Per the daemon
    reference, `roleRunner.onIdle` absent means no idle triggering — the
    opposite default from `roles`, because idle firing is a distinct opt-in
    surface. So when the backlog emptied after bring-up, nothing fired, and
    nothing refilled it. That is the deadlock in 2AMLogic/2am#144: backlog
    empty -> work finder idle -> nothing configured on idle -> backlog stays
    empty.
    `auditor` is the choice because it is the one default role that can
    manufacture work from an empty queue — it builds and runs main and files
    what breaks. `hermit` was the alternativ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
2026-08-08 feat(sim): characterize gf180mcu medium-voltage FETs against PDK elec-specs (#12)
    Adds sim/device-mv-fet/, a device-level PVT sweep (5 process corners x 3
    temperatures, nosupply) of nfet_06v0/pfet_06v0 (spec Sec 2.5's chosen model
    corner), nfet_05v0/pfet_05v0 (to test the Sec 2.2 same-device finding) and
    nfet_03v3/pfet_03v3 (the level shifter's thin-oxide side), extracting Vt,
    Idsat, Ioff, Cgg/Cgd and Id(Vds)/Ron at the PDK's own published bias/test
    conditions and comparing point-by-point against its own elec-spec tables.
    Every quantity with a published window passes at the typical/27C reference
    point (the only fair comparison against a manufacturing-spread table; ff/ss
    corner and temperatu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
2026-08-08 Capture cascode/clamped level shifter, prove the 3.63V thin-oxide ceiling (partial) (#14)
    * feat(design): capture cascode/clamped level shifter, prove partial oxide-safety result
    Implements spec/gate-driver.md §4's cascode/clamped level-shifter topology
    in xschem (design/level_shifter.sch, .sym, netlist), with the §2.4 DNWELL
    domain partition and cascode-bias derivation recorded in
    design/level-shifter-partition.md.
    Full-PVT verification (sim/level-shifter-oxide-safety/, follow-up commit)
    confirms the cascode clamp works as designed across every corner, but finds
    a separate, domain-internal thin-oxide overshoot at the logic rail's +10%
    corner that §4's topology was never designed to add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
    [level_shifter.sch]
2026-08-08 docs(spec): scope oxide-safety claim to a documented pre-driver exception (#18)
    Decision record 0002 found that the level-shifter's cascode clamp is
    verified correct, but the pre-driver inverter's own output (inb, gate
    of thin-oxide XMNPDB) transiently overshoots its own VDD_LOGIC rail by
    20-35 mV at the vlogic3p63v PVT corner -- a domain-internal effect the
    cascode clamp cannot fix.
    Passive mitigation (series gate resistor, decoupling capacitor, keeper
    resistor) was explored at the worst-case corner and rejected: none of
    it closes the gap without breaking function or requiring component
    values far outside "small" while still not fully clearing 3.63V. This
    traces to a structural property --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
2026-08-08 fix(guard): resolve quoted "$VAR/path" write targets to their same-command assignment (#20)
    resolve_var() (inside extract_write_targets() in
    .loom/hooks/guard-destructive-generic.sh) checked substr(tok,1,1)=="$" to
    detect a bare variable reference, but qsplit() leaves a quoted token's
    surrounding quote characters attached, so a quoted "$WORKTREE_ABS/path"
    write target starts with a literal `"` and was returned unresolved on the
    function's very first line -- even when WORKTREE_ABS was assigned an
    unambiguous, in-worktree literal earlier in the same command. That denied
    the recommended, shellcheck-clean idiom of assigning WORKTREE_ABS once and
    referencing it quoted on every subsequent line as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
2026-08-08 guard: auto-allow git clean -fd scoped to own worktree's sim/** (#19)
    * guard: auto-allow git clean -fd scoped to own worktree's sim/**
    guard-decisions.log showed the ask-tier `git clean -fd` pattern firing
    repeatedly, always inside an agent's own worktree, always confined to
    generated ngspice output dirs under sim/ (corners/, netlist-snapshots/,
    .work) -- never the repo root, never a bare -fd. In a headless run an
    unanswered ask blocks like a deny, so every scoped cleanup stalled.
    Replace the plain ASK_PATTERNS substring entry with a segment-parsed check
    (extract_git_clean_fd_targets(), mirroring the #5214 systemctl_ask_reason()
    shape): a git clean -fd*-family invocation only skips the as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
2026-08-10 chore(repo-skills): install Repo Skills 0.10.0
    This repo had NO Repo Skills install at all — not a stale one. A third of the
    fleet was in that state, which reframes 2AMLogic/2am#56: that issue reads as
    "0.8.1 landed only in 2am", but nine repos had never had the tool, including
    canaries that carry the destructive-command guard the rest of the toolchain
    assumes is present.
    Committed straight to main rather than via a per-repo branch. The 0.8.1
    rollout used branch-per-repo and seven of those branches were abandoned
    mid-flight, leaving their repos parked off trunk and invisible —
    compute-drift.sh's axis 3 compares a checkout against its OWN branch, so a
    repo current with a stale branch rep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
2026-08-12 feat: capture and size the low-side output stage (closes #6) (#23)
    * feat(design): capture and size the low-side output stage schematic
    Adds design/output_stage.sch/.sym (6-stage tapered pre-driver +
    complementary push-pull final stage, all nfet_06v0/pfet_06v0 per spec
    Sec.2.5), the xschem-generated netlist, and design/output-stage-sizing.md
    deriving every width/taper ratio from PDK-published bounds, a
    sizing-support probe cross-checked against issue #5's landed device
    characterization, and a topological Sec.2.3 gate-ceiling analysis.
    Also fixes a load-bearing bug in sim/output-stage-drive/testbench/tb.json:
    the harness's interactive `meas` command (issued inside .control, not as
    a top-lev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
    [output_stage.sch]
2026-08-12 docs: narrow gate-driver overvoltage claim for output-stage taper-node ceiling excursion (#26)
    Resolves the §2.3 gate-ceiling shortfall recorded in decision record 0004
    (design/output_stage.sch, all 15 PVT points at the 6V stretch rail) by
    formally narrowing spec/gate-driver.md §5's overvoltage-protection claim
    with a second documented, bounded exception (decision record 0005),
    mirroring the 0002->0003 precedent. A clamp/cascode mitigation was
    investigated and rejected: n5/n4 drive this cell's largest, most
    delay-critical devices, making mitigation strictly more costly here than
    the analogous, already-rejected case in decision record 0003, to close a
    smaller (53.8mV) gap. The 6.0V DC gate-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
2026-08-12 fix(guard): restore PR #19/#20 fixes dropped by Loom surface resync (#25) (#27)
    c7ba31d wholesale-replaced .loom/hooks/guard-destructive-generic.sh with an
    upstream snapshot that predated two locally-vendored fixes, silently
    reverting both:
    - resolve_var()'s quote-stripping ("QUOTED WRITE TARGETS", #17/#20): a
    quoted "$VAR/path" write target now resolves against a same-command
    VAR="literal" assignment before the unresolved-variable fail-closed check.
    - extract_git_clean_fd_targets() (#15/#19): auto-allows a git clean -fd
    invocation scoped entirely to an agent's own worktree sim/**, never
    touching records/.
    Both are ported by hand into the current (post-resync) file structure rather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
2026-08-15 fix: strip leaked worktree sch_path lines from committed netlists (#42)
    * fix: strip leaked worktree sch_path lines from committed netlists
    design/netlist/output_stage.spice and design/netlist/level_shifter.spice
    carried an xschem-prepended `** sch_path: <absolute path>` comment naming
    a one-off agent worktree, meaningless outside that environment. Remove
    both lines (comment-only, no electrical/functional content) and add a
    note to design/README.md's netlisting recipe so future regenerations
    strip this line before committing too.
    Verified via sim/check_records.py, the full repo lint script, and a
    --no-write ngspice re-run of both affected testbenches (output-stage-drive,
    level-shifter-oxid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
2026-08-15 chore: remove dead klayout_dir property in sim/harness/pdk.py (#71)
    klayout_dir had no call sites anywhere in the repo (unlike its sibling
    xschem_dir, which is wired into cmd_check_env). layout/ is still empty
    and no klayout-tools integration exists yet to consume it, so drop it
    until real layout work needs it.
    Closes #70
2026-08-16 ci: run test-guard-heredoc-interpreter-masking.sh in Hook regression suites (#86)
    The CI step's "All four suites" pass-count gate only covers four of the
    five vendored regression suites -- test-guard-heredoc-interpreter-masking.sh
    (added in #73 to guard the #68 quoted-heredoc masking fix) was never wired
    in, leaving that fix without CI coverage against a future silent resync
    regression (the exact failure mode #25 and this step exist to catch).
    Add the missing suite as a 5th line and update the step comment to
    "All five suites".
    Closes #82
2026-08-16 fix(guard): treat zero recognized git-clean-fd invocations as allow (#92)
    * fix(guard): treat zero recognized git-clean-fd invocations as allow
    The GIT CLEAN -fd SCOPED SIM-ARTIFACT ALLOWLIST block fell through to
    `ask` whenever its raw substring pre-check matched "git clean -fd"
    anywhere in the command text, even when extract_git_clean_fd_targets()
    found zero real invocations (e.g. the phrase only appears in prose
    inside a quoted argument to check-duplicate.sh or a `gh issue list
    --jq` filter string). _GC_ASK was only ever cleared inside the branch
    handling a non-empty target list, so the empty case silently fell
    through to ask.
    Distinguish "zero real invocations" (nothing to confirm or d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
2026-08-16 docs: add aggregated block-level characterization report against spec §3 (#108)
    Rolls up spec/gate-driver.md §3's block-level performance rows -- peak
    source/sink drive strength, propagation delay, and rise/fall into the 1 nF
    reference load -- into one report, citing the specific sim/*/records/*.md
    evidence behind each verdict. Until now those results existed only inside
    the raw per-record tables of the two per-cell campaigns and were never
    aggregated against the spec's own rows.
    Coverage is stated honestly rather than implied away: both cited campaigns
    are isolated per-cell runs, so the report does not compose them into an
    end-to-end verdict. It records that output-stage-drive's IN_DRV i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
2026-08-16 feat(design): capture gate_driver_core top cell wiring level shifter to output stage (#116)
    design/level_shifter.sch and design/output_stage.sch existed only as
    standalone sub-cells: nothing instantiated them together, so the block
    had no top-level schematic and design/README.md's hierarchy note named a
    gate_driver_core.sch that was not on disk.
    - design/gate_driver_core.sch: top cell instantiating level_shifter (x1)
    and output_stage (x2). IN -> x1 -> IN_DRV -> x2 -> OUT; VDD_DRV/GND_DRV
    shared by both, VDD_LOGIC/GND_LOGIC/IN to the level shifter only. Ports
    are exactly decision record 0001 Decision 1's table.
    - design/gate_driver_core.sym: hierarchical symbol next to the .sch (not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
    [gate_driver_core.sch]
2026-08-16 fix(guard): delimit escaped double-quoted flag values the way bash does (#112) (#119)
    The ask-tier `git-clean-fd` guard false-asked on a `gh pr comment --body`
    value that quotes example code as prose using bash's own escaping, e.g.
    gh pr comment 1 --body "example: \"\$(true; git clean -fd .)\""
    To bash that value is ONE inert argument (`\"` is a literal quote, `\$(` a
    literal `$(`), so nothing executes — yet the hook asked, which permanently
    stalls a headless agent. Reproduced twice in production against PR #103's
    approval comment (guard-decisions.log 2026-08-16T03:31:48Z / 03:31:56Z).
    Root cause is NOT the flat nesting toggle in qsplit()/mask_ws() the issue
    hypothesized, but strip_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
2026-08-17 feat(layout): generate gate_driver_core GDS from its netlist via klt (#128)
    * feat(layout): generate gate_driver_core GDS from its netlist via klt
    Adds the block's first physical layout, produced entirely by klt rather than
    drawn by hand, plus the tooling that reproduces and audits it.
    - layout/gen_gate_driver_core.py flattens design/netlist/gate_driver_core.spice,
    emits one `klt gen mos_array` cell per netlist device (an m=M device folds
    into M parallel gate fingers, which is what m=M means in SPICE), draws the
    Metal1/Via1/Metal2 interconnect and the voltage-domain markers with
    `klt draw`, and merges everything with `klt gen-compose` explicit placement.
    Re-running it reproduces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
2026-08-17 test(sim): end-to-end PVT campaign + real predriver-cap level-shifter re-run (#135)
    * feat(sim): end-to-end PVT campaign + real predriver-cap level-shifter re-run (#100)
    Adds sim/gate-driver-core-drive/, an end-to-end testbench driving the full
    chain (IN -> level_shifter -> output_stage -> 1nF load) via the combined
    design/netlist/gate_driver_core.spice from #98, substantiating spec Sec.3
    against the actual block rather than an isolated sub-cell.
    Also re-points sim/level-shifter-oxide-safety's 20fF placeholder load at
    the real output-stage predriver input capacitance (5.977fF, derived from
    design/output-stage-sizing.md Sec.1.4's BSIM4 cgg probe against the actual
    first-stage device geometr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
2026-08-17 fix(layout): split W across nf fingers when generating device cells (#141)
    `_device_from_tokens` handed `klt gen mos_array` `nf*m` fingers each of the
    netlist's full `W`, which draws a device `nf` times too wide for any `nf>1`.
    Both sides of that handoff are now pinned against their sources rather than
    assumed:
    * SPICE `W` is a device's *total* width, split across `nf` fingers -- gf180mcu's
    model cards pass `w=w nf=nf` into the BSIM core and size their drift resistors
    on `w/nf`, and this netlist's own `ad`/`ps` expressions use `W/nf`.
    * `klt gen mos_array`'s `w_um` is the *per-finger* width: a
    `finger_topology: "parallel"` unit device is "one folded transistor of width
    `fingers * w_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
2026-08-17 feat(sim): apply spec §3 stretch targets at the 6V corner via a corner-scoped checks override (#147)
    * feat(sim): evaluate spec §3 stretch targets at the 6V corner via a corner-scoped checks override
    A testbench's `checks` block could only state one min/max per measurement,
    applied uniformly across the PVT grid. spec/gate-driver.md §3 states two
    tiers for the same parameter (peak current ≥0.5A / 1A stretch, propagation
    delay <50ns / <25ns), and a testbench that opts into the 6V `vdrv` stretch
    point therefore judged its stretch corners against the *looser* nominal
    bound. A point that misses the stretch target was recorded PASS — invisible
    in the record, because a loose check that pass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
2026-08-17 docs(sim): roll up #100's end-to-end evidence into gate-driver-characterization.md (#151)
    Rewrite the propagation-delay/drive-strength/rise-fall sections around
    sim/gate-driver-core-drive/records/20260817-013400-ae66957.md (the new
    end-to-end PVT campaign from #100), remove the worst-case-sum sanity
    bound now that a real composed measurement exists, re-point the
    level-shifter citations at the refreshed
    sim/level-shifter-oxide-safety/records/20260817-010243-2165a49.md, and
    also re-point the output-stage-drive citations at the record that
    superseded them via #147's corner-scoped stretch check (same
    measurements, now explicitly scored against the 6V stretch target).
    Rewrites "Coverage: per-cell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
2026-08-17 fix(sim): pin ngspice num_threads=1 in the generated deck (#152)
    A locally built, OpenMP-enabled ngspice reads its own spinit (or a
    .spiceinit) for a default thread count; a host whose spinit carries
    set num_threads=8 makes every PVT point pure oversubscription once
    run_corners.py -j N is already parallelizing across points -- measured
    at ~2000x slower for byte-identical results. compose_deck() now emits
    set num_threads=1 in the generated .control block, alongside the
    existing set numdgt=10 / set noaskquit, so a run's speed no longer
    depends on host ngspice configuration.
    Verified on a host with spinit set num_threads=8: before/after
    measurements for sim/output-stage-drive are identical (or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
2026-08-17 test(guard): pin catastrophic --body-prose false-positive fix with regression coverage (#154)
    Adds test-guard-catastrophic-body-prose.sh, replaying the exact historical
    DENY from guard-decisions.log (2026-08-15T12:24:01Z: a non-heredoc `gh issue
    comment --body` call whose double-quoted prose quotes the catastrophic
    recursive-force-remove-root pattern via escaped backticks) plus the issue's
    minimal unbackticked-prose repro through guard-destructive-generic.sh,
    asserting ALLOW alongside paired real-invocation DENY safety-floor cases.
    No production code change: PRs #119/#142 already fixed the underlying
    false-positive incidentally; this only pins it against regression.
    Closes #149
    Co-authored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
2026-08-17 spec: ratify IN_DRV inter-cell gate-ceiling exception (decision record 0006) (#157)
    The end-to-end PVT campaign (sim/gate-driver-core-drive, issue #100) found
    the inter-cell node IN_DRV exceeding spec 2.3's 6.0V thick-oxide gate
    ceiling at all 15 of the 6V stretch-rail points -- worst case 6.11823 V
    (margin -118.2 mV) at ss_125c_vlogic3p30v-vdrv6p00v -- explicitly outside
    decision record 0005's ratified scope, which covers only the output
    stage's internal taper nodes n1..n5.
    Add decision record 0006, narrowing spec 5's overvoltage-protection claim
    a third time with a bounded, measured exception for IN_DRV, following the
    0002->0003 and 0004->0005 shape.
    The mechanism is identified and measu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
2026-08-17 docs: propagate decision record 0006's Exception 2 amendment to output-stage-sizing.md (#160)
    Add amendment pointer to design/output-stage-sizing.md §6's "Resolved by issue
    #24" paragraph, noting that decision record 0006 amended the exception's
    quantification from n5 = 6.0538 V / −53.8 mV (measured with ideal 1 ns edge)
    to n1 = 6.10232 V / −102.3 mV under the real level-shifter edge in the
    end-to-end campaign. This record's own isolated-edge measurements remain the
    authoritative baseline for sim/output-stage-drive/.
    Closes #158
2026-08-17 test(sim): tighten gate-driver-core-drive checks to spec §3 stretch targets (#162)
    * test(sim): apply 6V vdrv stretch bounds to gate-driver-core-drive checks
    Mirror the corner-scoped stretch mechanism (issue #125) onto
    gate-driver-core-drive's manifest: ipeak_source_a/ipeak_sink_a now enforce
    the 1A stretch target at the 6V vdrv corner, and tpdlh_s/tpdhl_s gain
    nominal+stretch propagation-delay checks that were previously measured but
    never bound at all. Rise/fall keeps its single nominal bound per spec Sec.3's
    '-' stretch column.
    * test(sim): re-run gate-driver-core-drive PVT sweep under tightened stretch checks
    New evidence record 20260817-182927-26592a1 supersedes
    20260817-013400-ae66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
2026-08-17 design: add IN_DRV feedforward compensation capacitor to level_shifter (#167)
    * design: add IN_DRV feedforward compensation capacitor to level_shifter (issue #155)
    Adds XCCOMP, a ~12-14 fF MIM capacitor (cap_mim_1f0_m4m5_noshield,
    3.0um x 3.0um) from level_shifter's cross-coupled latch node ncb to
    its output-buffer drain (IN_DRV at the block level). Mitigates the
    gate-drive-feedthrough overshoot decision record 0006 characterizes
    on IN_DRV, while staying at the small end of that record's
    characterized effective range (10-100 fF) so it does not regress
    decision records 0002/0003's thin-oxide na/nb margin -- a tradeoff
    measured while implementing this change (see decision record 0007).
    This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
    [level_shifter.sch]
2026-08-17 fix(sim): tighten harness default transient tolerance to resolve coupling-transient peaks (#165)
    * fix(sim): tighten the harness default transient tolerance to reltol=1e-4
    The harness's generated decks ran `tran <tstep> <tstop>` with no maximum
    timestep and ngspice's factory-default reltol (1e-3), letting ngspice skip
    over the true peak of the sub-nanosecond coupling spikes that produce every
    recorded spec Sec.2.3 gate-ceiling number -- the harness-default figure was
    a measured lower bound on the excursion, not the excursion itself.
    compose_deck now appends a harness-wide `.options reltol=1e-4` default to
    every generated deck, unless a testbench's own manifest already opts into a
    reltol va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
2026-08-17 fix(guard): add --jq to strip_literal_text() flag list so read-only jq filters don't trip catastrophic denies (#173)
    gh api/issue/pr's --jq filter string is a read-only jq query, never an
    executed shell command -- structurally identical to --search (already
    handled per #5797). It was missing from strip_literal_text()'s
    FLAG_RE_BOL/FLAG_RE_MID regexes and all three substring pre-check gates
    that decide whether to invoke it, so a --jq filter that merely tests a
    string for a catastrophic-tier phrase (e.g. `gh api ... --jq
    'select(.title | test("DROP TABLE"))'`) false-denied at the sql-ddl
    catastrophic tier -- the same false-positive class already fixed for
    --body/--search prose in #149/#154/#11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
2026-08-17 test(guard): derive case (w)'s climb depth from the physically-resolved $TMPDIR instead of a fixed +1 margin (#176)
    Case (w) of the worktree-confinement suite reconstructs a `../` climb out of
    the guard's `mktemp -d` sandbox stand-in. The depth was computed from this
    script's own *unresolved* `mktemp -d` output plus a fixed `+1`, which only
    covers a $TMPDIR whose physical form is at most one component deeper than its
    logical form (the macOS `/var -> /private/var` single hop).
    Replace it with mktempd_standin_climb(), which mirrors the guard's own
    resolution exactly -- `${TMPDIR:-/tmp}` physically resolved via
    `cd ... && pwd -P`, plus the fixed `.loom-guard-mktemp-d-sandbox` leaf -- and
    count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
2026-08-17 fix(guard): verify git-common-dir identity before trusting it as the main checkout (#175) (#177)
    worktree-write-confinement in guard-destructive-generic.sh trusted WHATEVER
    git repository enclosed the tool_input cwd as "the protected main checkout",
    with no check that it was actually this Loom-managed project. A git init'd
    scratch tree under /tmp that happened to also carry a
    .loom/worktrees/*/.loom-managed fixture (routinely created while testing
    this very guard) was therefore treated as the main checkout, denying writes
    entirely outside the real repository.
    Anchor a second, CWD-independent identity probe at SCRIPT_DIR (the on-disk
    location of this hook file, resolved via BASH_SOURCE[0] an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
2026-08-18 fix(guard): run the git-clean-fd substitution re-scan unconditionally (#118)
    * fix(guard): run git-clean-fd substitution re-scan unconditionally
    The GIT CLEAN -fd SCOPED SIM-ARTIFACT ALLOWLIST block reached the
    command-substitution body re-scan only when the direct extraction
    returned zero targets, making the two checks mutually exclusive. A
    command pairing a directly-recognized, confined invocation with a
    second invocation hidden inside a nested $(...) took the other branch,
    so the hidden, unconfined invocation was never scanned for and was
    silently allowed:
    git clean -fd sim/device-mv-fet/corners/ \
    && echo "$(true; git clean -fd /etc/passwordfile)"
    Restructure the block into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
2026-08-18 docs(spec): scope a low-side on-die power-NMOS facet into this repo (#182)
    * docs(spec): scope a low-side on-die power-NMOS facet into this repo
    Adds decision record 0008: states that direct low-side drive of a small
    load from a single Li-ion cell (on-die nfet_06v0, logic-level Vgs, no HV
    rail) is in scope in this repo rather than a sibling one, since it shares
    this repo's existing nfet_06v0/pfet_06v0 device characterization. Derives
    a Ron*W baseline (Ohm*mm) from sim/device-mv-fet's already-recorded PVT
    grid, cross-checks it against the issue's cited spot-check figures, and
    defers the facet's remaining spec content (EM/current-density guidance,
    OCP/thermal-shutdown structures, flyback trad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
2026-08-18 layout: draw substrate/well-tap + guard-ring geometry to close gate_driver_core LVS (#183)
    * feat(layout): draw real substrate/well-tap and guard-ring geometry, close body_unverified (#132)
    Every one of the 959 drawn transistors now gets its own Comp+implant+
    Contact+Metal1 body-tie tap (Nplus/Nwell for PMOS -> VDD_LOGIC/VDD_DRV,
    Pplus for NMOS -> GND_LOGIC/GND_DRV), and DNWELL_DRV gets a closed,
    north/south-contacted PCOMP guard ring tied to GND_LOGIC. klt lvs now
    reports status: match, 959/959 devices, 17/17 nets, mismatch_count: 1
    (one pre-existing, unrelated topology warning) -- device.body_unverified
    is fully gone for both device flavors, not just PMOS.
    The one real, permanent consequ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
2026-08-18 spec: add decision record 0009 for multi-channel bond/ground/substrate guidance (#186)
    * spec: add decision record 0009 for multi-channel bond/ground/substrate guidance
    Answers issue #181's three deferred questions from decision record 0008:
    bond wire count/sizing for N in {1,2,4} channels at ~1 A/channel (citing
    DRM §9.0's explicit non-publication of per-wire current limits, with a
    derated industry-standard heuristic as fallback), per-channel dedicated
    GND_DRV_n ground return extending decision record 0001's GND_LOGIC/GND_DRV
    split, and a qualitative substrate-noise-coupling treatment for the
    co-integrated UVLO comparator that leaves the comparator-glitch magnitude
    question as an explicit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
2026-08-18 fix(guard): mask quoted-literal-only force-push phrases in jq/gh-api data args (#137)
    * fix(guard): mask quoted-literal-only force-push phrases in jq/gh-api data args
    Extends the existing quote/literal-context-aware masking (strip_literal_text(),
    mask_catastrophic_positional_args()) so the six force-push-to-main/master
    literal patterns in ALWAYS_BLOCK_PATTERNS no longer hard-deny two read-only
    shapes that merely quote the trigger phrase as data:
    - jq's own filter argument (e.g. `jq -c 'select(.pattern == "catastrophic:git
    push --force origin main")' guard-decisions.log`) -- jq is added to
    mask_catastrophic_positional_args()'s non-executing command allowlist,
    alongside the existing gr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
2026-08-18 spec: ratify the low-side power-switch facet on cell-referenced Ron·W, an EM budget, OCP/thermal-sense structures and a flyback clamp (#187)
    * sim(low-side-power-switch): add cell-referenced Ron.W testbench and sweep script
    New device-level experiment for the low-side on-die power-NMOS facet:
    nfet_06v0/pfet_06v0 output characteristics at the gate drive a single
    Li-ion cell presents (Vgs = 3.6/4.2/5.0 V) plus the PDK 6 V P+/N-well
    junction diode's forward characteristic, over the 15-point process x
    temperature grid.
    Method-identical to sim/device-mv-fet where the two overlap (same test
    geometry, same 0..6.6 V Vds span and 1 % step, same near-origin chord at
    Vds = 66 mV) so the two records'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
2026-08-18 fix(postlayout): emit the merged ground net's RC star with per-device hubs (#188)
    * fix(postlayout): emit the merged ground net's RC star with per-device hubs
    `klt extract` reports both drawn ground rails under one merged identity
    (`GND_DRV|GND_LOGIC`) since real body-tie geometry was drawn for both
    domains. `mk_extracted_dut.py`'s T5 skipped that net's parasitic star
    outright — it has no single hub, and a shared one is known wrong — which
    left both rails as ideal zero-ohm nodes in the RC DUT: 297 R legs and the
    inter-rail cap short of the pre-#132 netlist, and optimistic rather than
    conservative for the ground-bounce / undershoot checks the RC record makes.
    Emit the star instead, with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
2026-08-18 spec: ratify a shuttle test-structure plan for the low-side power-switch facet (decision record 0012) (#189)
    * spec: ratify a shuttle test-structure plan for the low-side power-switch facet (decision record 0012)
    Sizes a single reduced-scale reference channel plus all three flyback
    variants for a wafer.space GF180MCU quarter slot, maps each structure to
    which of spec/low-side-power-switch.md §6's six open items it retires,
    and states plainly what a single-lot shuttle sample can and cannot
    confirm against the ratified PVT grid.
    Closes #180
    * spec: correct decision record 0012's pad-count arithmetic (17 -> 18)
    Judge review of PR #189 found the "Pad budget" summary line understated
    the pad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
2026-08-18 spec: bound Exception 2's output-stage taper-node gate-ceiling excursion (#191)
    Issue #156's harness-tolerance tightening (reltol=1e-4) moved decision
    record 0005/0006's Exception 2 worst case (n1, design/output_stage.sch)
    from -102.3 mV to -148.0 mV, ~46 mV worse, with no explicit ceiling the
    way Exception 3 has. Adds decision record 0013 (extends 0005/0006),
    citing the re-measured worst case and adopting an explicit <=175 mV
    bound sized for the deck-fidelity resolution this node has not yet had
    swept as deeply as Exception 3's IN_DRV was. Updates spec/gate-driver.md
    Sec5's Exception 2 bullet and design/output-stage-sizing.md Sec6 to cite
    the new record and number.
    Closes #163
    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
2026-08-18 fix(design): realize XCCOMP as four series minimum-area 2 fF/um2 MIM caps (#194)
    * fix(design): realize XCCOMP as four series minimum-area 2 fF/um2 MIM caps
    gf180mcuD fixes the MiM density at 2.0 fF/um2 at the process level, so
    decision record 0007's cap_mim_1f0_m4m5_noshield is a simulation-only
    model with no fabricable or LVS-recognizable device on this PDK build:
    - .config/nodeinfo.json declares option "MIM_2P0"
    - libs.tech/klayout/lvs/run_lvs.py binds variant=D to mim_cap=2
    - libs.tech/magic/gf180mcuD.tech and libs.tech/netgen/gf180mcuD_setup.tcl
    each define exactly one MIM device, cap_mim_2f0_m4m5_noshield
    - the PDK LVS deck extracts all three densities from IDENTICAL draw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
    [level_shifter.sch]
2026-08-18 spec: re-measure and bound Exception 1's pre-driver overshoot (decision record 0015) (#195)
    Decision record 0003's Exception 1 states the level shifter's pre-driver
    inverter output `inb` overshoots its own VDD_LOGIC rail by 20-35 mV. That
    band was fitted to evidence taken at ngspice's factory-default reltol=1e-3;
    since issue #156 / PR #165 the harness default is reltol=1e-4, and at that
    tolerance measurements of this node have landed outside the band's stated
    35 mV upper figure (35.84 mV for the uncompensated circuit) on solver-
    fidelity grounds alone. Decision record 0014 flagged this and declined to
    widen a ratified record as a side effect of an unrelated change.
    Evidence added:
    - Full 6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
2026-08-18 layout: draw the XCCOMP MiM series stack and re-verify DRC/LVS (#196)
    * layout: draw the XCCOMP MiM series stack and re-verify DRC/LVS
    `gate_driver_core.gds` implemented every transistor in the netlist but none
    of its four `cap_mim_2f0_m4m5_noshield` compensation capacitors: `klt gen`
    has no capacitor generator, so the generator parsed them, warned, and
    recorded the gap in `passives_not_drawn`. Draw them instead.
    `Interconnect.mim_caps()` lays out the plates directly through `klt draw`, on
    exactly the layers klt's own gf180mcu extraction deck recognises this device
    on (FuseTop top plate + CAP_MK/MIM_L_MK markers, Metal4 bottom plate, Via4 to
    Metal5) -- so the rectangles extract as real, LV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
2026-08-18 docs(layout): regenerate post-layout DUT netlists and PVT grids against the post-#166 (XCCOMP) extraction (#202)
    * fix(layout): regenerate post-layout DUT netlists against the post-#166 (XCCOMP) extraction
    Part of #201
    The committed post-layout DUT netlists (layout/lvs/gate_driver_core.extracted.spice
    and .extracted-rc.spice) were still derived from the pre-#166 extraction, which
    had no x1_XCCOMP* in it -- #166 deliberately left this regeneration out of its
    own scope (layout/README.md's "Known gaps"). Regenerate both from a fresh
    klt extract / klt extract --parasitics run against the current (capacitor-drawn)
    layout/gate_driver_core.gds:
    - mk_extracted_dut.py gains T7: the extraction deck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
2026-08-19 spec: accept output-stage 6V-stretch sink-current shortfall as a bounded exception (decision record 0016) (#203)
    Issue #125's per-corner harness check surfaced that ss/sf at 125C/6V fall
    6.4-12.5% short of spec section 3's >=1A stretch sink-current target,
    confirmed consistently across isolated, end-to-end, and extracted
    post-layout evidence. Resizing the final-stage NMOS to close the gap would
    invalidate the already-drawn, DRC/LVS-clean gate_driver_core layout and its
    post-layout PVT records, and risks worsening the already-bounded section
    2.3 gate-ceiling exception on the same node -- disproportionate for a
    6-12.5% shortfall. Decision record 0016 documents it as a bounded (>=0.85A)
    excepti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
2026-08-21 docs: re-verify T1 checklist items 5/6/7/9 for issue #22 (2026-08-21) (#205)
    Item 5: confirm every spec/gate-driver.md §3 row has a recorded pass/fail
    at its binding corner in the current gate-driver-core-drive and
    gate-driver-core-drive-postlayout records (no missing rows/corners).
    Item 6: no Monte Carlo evidence exists yet for any statistical claim that
    needs it; scoped a concrete follow-up as issue #204 (spec/gate-driver.md
    §5 Exception 3's IN_DRV margin).
    Item 7: add a "Post-layout coverage" section to
    design/gate-driver-characterization.md stating explicitly what the
    gate-driver-core-drive-postlayout extraction models (per-net star R/C,
    quasi-static) and does not (net-to-net couplin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
2026-08-21 docs(gate-driver): refresh characterization report to current post-XCCOMP record (#207)
    Re-cite sim/gate-driver-core-drive/records/20260818-060517-673fcf0.md
    throughout design/gate-driver-characterization.md in place of the stale
    20260817-013400-ae66957.md (predates the XCCOMP MiM compensation-stack
    rework, decision record 0014), and update every spec §3 figure (peak
    source/sink current, tpdlh/tpdhl, rise/fall, grid means) to the new
    record's own values. No spec §3 verdict changes. Replaces the "Freshness
    note" flagging the stale citation with a short refresh note now that the
    tables are current.
    Part of #22
2026-08-21 feat(sim): Monte Carlo local-mismatch evidence for the IN_DRV gate-ceiling exception (#212)
    * feat(sim): add Monte Carlo local-mismatch deck mode and the IN_DRV campaign
    The harness could only express global process-corner skew (tt/ff/ss/fs/sf),
    so `sim/README.md`'s Statistical convention field had never been populated by
    any record. Adds the missing evidence class.
    - `sim/harness/montecarlo.py`: `MismatchSample` (deck fragment + derived
    seed), `sample_seed` (collision-free per point/sample), `mc_point`
    (grammar-legal `ss_mc0042_...` corner-ids). Pins `sw_stat_global=0` so the
    deterministic `.LIB` corner stays the sole global-skew axis, and reserves
    sample 0 for a `sw_stat_mismatch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
    [samples-ff_-40c_vlogic3p30v-vdrv6p00v.csv, samples-ff_125c_vlogic3p30v-vdrv6p00v.csv, samples-ff_27c_vlogic3p30v-vdrv6p00v.csv, samples-fs_-40c_vlogic3p30v-vdrv6p00v.csv, samples-fs_125c_vlogic3p30v-vdrv6p00v.csv, samples-fs_27c_vlogic3p30v-vdrv6p00v.csv, samples-sf_-40c_vlogic3p30v-vdrv6p00v.csv, samples-sf_125c_vlogic3p30v-vdrv6p00v.csv]
2026-08-21 chore(loom): pin the 5 forked guard hooks in .loom/resync-ignore (#213)
    The guard hooks under .loom/hooks/ are a locally-vendored fork carrying ~20
    repo-local fix(guard) commits that were never upstreamed to Loom's
    defaults/hooks/ baseline. resync-installed.sh overwrites rather than merges,
    so every "chore: resync installed Loom surfaces" commit silently reverts all
    of them and breaks the .loom/hooks/tests/*.sh suites — twice so far (c7ba31d,
    fixed by PR #27; 2f96421, restored by PR #208).
    Declare the 5 files repo-owned so resync-installed.sh reports them as
    "skipped (pinned in .loom/resync-ignore)" instead of overwriting them, and so
    the installer's clean sweep never deletes them. The he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
2026-08-21 sim: quantify the ngspice-46 -> ngspice-47 residue on gate-driver-core-drive (issue #210) (#214)
    Built ngspice-47 from the imr/ngspice mirror (tag ngspice-47, same KLU/
    XSPICE/CIDER/OSDI/OpenMP feature set as the environment's preinstalled
    ngspice-46) and re-ran the full 60-point sim/gate-driver-core-drive/ PVT
    grid with no other change (same DUT sha256, testbench, PDK build, and
    reltol=1e-4 as the superseded ngspice-46 record) to quantify decision
    record 0017's "Second finding" beyond its single IN_DRV control leg.
    - New append-only record 20260821-113949-d2ba4d8.md supersedes
    20260818-060517-673fcf0.md, with a Finding section giving the full
    per-measurement delta table, sign-split ana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
2026-08-21 sim: add Monte Carlo local-mismatch campaigns for §5 Exceptions 1 and 2 (#215)
    Follow-up to issue #204 (Exception 3 / IN_DRV), applying the same
    sw_stat_mismatch harness convention (decision record 0017) to the two
    remaining ratified spec/gate-driver.md §5 exceptions:
    - sim/output-stage-taper-mismatch/: n1..n5 (Exception 2, ≤175 mV bound)
    against sim/output-stage-drive's testbench at the 6V stretch rail,
    full process x temperature grid (15 points, 200 draws each).
    - sim/level-shifter-inb-mismatch/: inb (Exception 1, ≤40 mV bound)
    against sim/level-shifter-oxide-safety's testbench at the
    vlogic3p63v-vdrv5p50v tied point, same grid shape.
    Both campaigns follow decision record 0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
    [samples-ff_-40c_vdrv6p00v.csv, samples-ff_-40c_vlogic3p63v-vdrv5p50v.csv, samples-ff_125c_vdrv6p00v.csv, samples-ff_125c_vlogic3p63v-vdrv5p50v.csv, samples-ff_27c_vdrv6p00v.csv, samples-ff_27c_vlogic3p63v-vdrv5p50v.csv, samples-fs_-40c_vdrv6p00v.csv, samples-fs_-40c_vlogic3p63v-vdrv5p50v.csv]
2026-08-21 sim: add Monte Carlo local-mismatch campaign for low-side switch Ron·W (#216) (#217)
    Closes the last remaining gap in the Monte Carlo local-mismatch evidence
    class issue #22's T1 checklist item 6 asks for: spec/low-side-power-switch.md
    §2.1's Ron·W table was the one artifact still carrying "Statistical
    convention: N/A -- this record is the corner matrix, not a Monte
    Carlo/mismatch distribution claim" after #204/#211 closed out
    spec/gate-driver.md §5's three exceptions.
    New sim/low-side-power-switch-ronw-mismatch/run_ronw_mismatch.py reuses
    sim/low-side-power-switch's testbench verbatim (a DC-sweep experiment, so
    it drives sim/harness's library directly rather than the tb.json grid
    model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
    [samples-ff_-40c_nosupply.csv, samples-ff_125c_nosupply.csv, samples-ff_27c_nosupply.csv, samples-fs_-40c_nosupply.csv, samples-fs_125c_nosupply.csv, samples-fs_27c_nosupply.csv, samples-sf_-40c_nosupply.csv, samples-sf_125c_nosupply.csv]
2026-08-26 feat: add UVLO sub-cell, instantiate in gate_driver_core, PVT-verify (#220) (#224)
    Implements decision record 0001 Decisions 4-5's UVLO comparator/reference
    topology as a new design/uvlo.sch sub-cell (resistive divider off VDD_DRV
    vs. a diode-connected nfet_06v0 Vt reference, 5T differential comparator,
    2-inverter buffer, active-low OUT pulldown), instantiates it in
    design/gate_driver_core.sch as x3, and PVT-verifies both the standalone
    cell (sim/uvlo-trip-verification/) and the full block with UVLO in the
    loop (sim/gate-driver-core-drive-with-uvlo/, three facets: default spec
    rails, a guaranteed-off supplementary point, and Challenge #5's 3.3V/5.0V
    rail envelope).
    Measured PVT results dive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
    [gate_driver_core.sch, uvlo.sch]
2026-08-26 feat(layout): extend gate_driver_core layout with UVLO sub-cell, DRC/LVS clean (#225)
    * feat(layout): extend gate_driver_core layout with UVLO sub-cell, DRC/LVS clean (#221)
    Extends layout/gen_gate_driver_core.py to draw uvlo's bias-resistor network
    (Rref/R1/R2/Rfb, via klt gen res_array) alongside the existing level_shifter
    and output_stage sub-cells, using the #220-extended
    design/netlist/gate_driver_core.spice as source. Regenerates
    gate_driver_core.gds/.provenance.json/.checks.json for the complete block.
    Two real connectivity bugs were found and fixed along the way (not just
    tool-version friction):
    - A resistor's Metal1 escape wire back to its own net's rail crossed a
    device's own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
2026-08-26 feat(sim): post-layout PVT re-verification of the complete gate-driver block (#222) (#227)
    * feat(sim): post-layout PVT re-verification of the complete gate-driver block (#222)
    Extracts the parasitic netlist from #221's committed, DRC-clean/LVS-matched
    complete-block GDS (extending mk_extracted_dut.py for uvlo's ppolyf_u
    bias-resistor network, plus a klt 0.3.0 anonymous-net escaping fixup) and
    re-runs the full -40/27/125C x process x supply PVT matrix against it, both
    with and without RC interconnect parasitics, at the existing spec rails and
    the Challenge #5 rails (3.3V digital / 5.0V analog envelope) -- four
    full-grid records under the new sim/gate-driver-core-drive-with-uvlo-postlayout/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
2026-08-26 docs(spec): document nominal-corner ipeak_source_a miss as bounded UVLO-lockout exception (decision record 0020) (#228)
    Issue #226: at ss_-40c_vlogic2p97v-vdrv4p50v, ipeak_source_a falls just
    under spec/gate-driver.md's ≥0.5A nominal target once uvlo is
    instantiated (0.475414-0.499696A across schematic/postlayout/RC
    facets). Confirmed via measurement (vout_max_v ~0.24V,
    uvlo_lockout_at_in_high ~VDD_DRV, and the adjacent sf_-40c corner
    showing the identical lockout condition but a contention spike that
    happens to clear 0.5A) that this corner is already fully locked out
    per decision record 0018 Finding 2's already-open false-trip finding
    - the sub-threshold reading is a sub-nanosecond conten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
2026-08-26 docs(chipalooza): add Challenge #5 proposal for the gate driver (#229)
    Write docs/chipalooza/challenge-5-proposal.md, the submission-ready
    proposal for Open Circuit Design's Chipalooza Challenge #5 (GF180MCU /
    Wafer.Space), following the shape of this program's Challenge #3
    proposals for sibling GF180 canaries: type of IP block, an I/O list
    mapped to the slot budget, a functional description, a target-spec
    table with every row cited to a dated sim/ record (preferring #222's
    post-layout evidence over #220's schematic-only records where both
    exist), a bench test plan for the packaged part, and an explicit
    met/unmet verdict per row with every known bounded exception and open
    finding carried for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
2026-08-27 ratification: install the two-key reviewer variant (EE key + market key) (#230)
    * ratification: install the two-key reviewer variant (EE key + market key)
    Phase C2 follow-up of 2AMLogic/2am#372 (2AMLogic/2am#525). Installs the two generated, Tier-1-clean public reviewer variants — ratification/ee-key/ (2am's generate-canary-variant.py) and ratification/market-key/ (product's generate-canary-variant.py), scoped to this repo's block class (gate-driver).
    Public-repo gate (2am#525): both the narrow org/repo# grep and a broader corporate/-and-money/-directory-name grep on this PR's added lines return 0. Both generators are lint-clean with selftests passing.
    * ratification: restore the market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
2026-09-05 feat(champion): standing authorization for design-evidence auto-merge (#6850)
    Operator ruling 2026-09-05: Judge-approved, green-CI PRs whose entire
    changed-file set lives in design/, sim/, layout/, measurements/,
    verification/, or docs/ auto-merge without the four-axis human hold.
    Rationale: canary design evidence is fully revertible with no fleet-infra
    blast radius, and the held-PR pattern (sky130-sar-adc#123 sat mergeable for
    days as the sole blocker of a layout chain) costs more than it protects
    here. spec/ and every tool surface fall outside the patterns, so the
    exact-subset rule keeps them on the four-axis judgment automatically.
    C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
2026-09-09 docs: refresh gate-driver-characterization.md to cite 2026-08-26 complete-block post-layout (with UVLO) records (#234)
    Re-derives the §3 TL;DR/Results tables against the ratified DR-0019
    complete-block-with-UVLO post-layout RC record (20260826-072640-a7dcce1,
    no-RC cross-check 20260826-063405-a7dcce1), replacing the prior 673fcf0
    (schematic, no UVLO) and af13899 (post-layout, no UVLO) primary citations.
    States DR-0016's (>=0.85 A stretch sink) and DR-0020's (>=0.45 A locked-
    corner nominal source) ratified bounds inline next to the rows they affect,
    and replaces the 2026-08-21 refresh note with one dated to this refresh.
    Closes #233
2026-09-10 test: post-layout PVT re-verification of level-shifter oxide safety (#236)
    * test: add level-shifter-oxide-safety-postlayout facet testbench
    * test: run and record the level-shifter-oxide-safety-postlayout PVT grid
    Runs the ported testbench against both extracted DUT variants
    (no-RC and RC), commits the two evidence records, and updates
    sim/README.md's facet index and design/gate-driver-characterization.md's
    Exception 1 coverage bullet to cite them.
    Worst inb excursion at the vlogic3p63v corner stays inside decision
    record 0015's <=3.670 V bound for both DUTs (3.66471 V no-RC,
    3.64277 V RC); na/nb stay under 3.63 V at all 60 points x 2 DUTs.
    ---------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
2026-09-21 feat(signoff): grade this block's T1 state via a klt signoff manifest (#240)
    * feat(signoff): grade this block's T1 state via a klt signoff manifest
    Commit the block manifest klt signoff --manifest grades, so this
    block's gap to T1 is a machine-graded verdict instead of hand-read
    prose that goes stale (issue #239). verification/signoff/ holds the
    manifest (block gf180-gate-driver, kind analog, items 3/4/8 cited,
    every citation pinned to the cited artifact's content_hash), the
    committed tier report (3/11 met, honest unmet rows with reasons for
    the rest), and the freshness gate. CI's new signoff job re-anchors
    every pin to the live tree and diffs a fresh render against the
    committed report, s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
2026-09-21 test(layout): add ERC supply-island negative control (#243)
    Falsifiability control for the committed item-11 'erc_status: clean'
    supply-island verdict (issue #242): a clean verdict without a known-bad
    companion is pattern-matching, not checking -- the DRC, LVS, and
    ground-rail verdicts each already carry one.
    layout/erc/erc_negative_control.py grades the same committed
    gate_driver_core.gds + erc-supply-spec.json pair through the same klt
    erc contract as three arms:
    - no-deck: the device-blind graph must re-report the FALSE
    erc.supply_short between VDD_DRV and GND_DRV (klayout-tools#2183's
    mirror-image artifact) -- proving the sibling clean verdict is
    deck-subtraction-dependent and th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
2026-09-23 fix: resolve direct writes to bare-mktemp file stand-ins in write confinement (#252)
    A same-command F=$(mktemp) binding (no -d) was unrecognized by the
    write-confinement resolver, so every direct $F write denied at the
    worktree-write-confinement-unresolved-var tier -- the exact shape of
    #248's telemetry (heredoc body files for the issue-filing path, awk
    scratch writes) stalling sanctioned headless flows.
    Add mktempf_parent(), the FILE twin of mktempd_parent(): it resolves
    the parent under the same rules (default $TMPDIR//tmp, absolute
    -p DIR/--tmpdir=DIR, absolute template dirname), refuses every -d
    spelling so the two recognizers partition the mktemp space, and records
    a synthetic file sta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
2026-09-23 fix: model escaped quotes in ask-tier positional and echo mask close scans (#253)
    Replicates the #247/#250 catastrophic-tier close-scan guard in the two
    ask-tier masking passes: a backslash inside a DOUBLE-quoted span consumes
    itself and the next byte, so an escaped quote is span content, never the
    close. mask_ask_positional_args() and mask_ask_echo_args() each gain the
    BS constant, the two-line skip guard, and a header note documenting the
    mechanism (kept as near-duplicates per the never-couple-the-tiers
    convention; no shared code).
    Closes #249
2026-09-23 Add reusable folded, cross-row-tied power-array generator (#254) (#255)
    Adds layout/common/power_array_folded.py: a two-row mirrored/nested
    cross-row-tie generator for high-m power devices, correcting a false
    "cross-row ties need a second routing layer" impossibility claim
    (F-018/F-023) that had propagated into three downstream artifacts.
    klt gen-compose's orientation: "mirror_y" brings adjacent rows' gate
    pads to face each other across the inter-row gap, tied by one plain
    metal box; source/drain need no trick since mos_array already puts
    them on fixed left/right edges a Y-mirror does not move. Verified
    against a real klt install + gf180mcu PDK: a two-row fold extracts as
    one shared (s, g, d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
2026-09-29 ci: wire test-guard-catastrophic-body-prose.sh into the Hook regression suites step
    The catastrophic-tier ALWAYS_BLOCK_PATTERNS scan's false-positive fix for
    --body prose merely describing a dangerous pattern (#149, pinned by this
    suite from #154) was never executed by CI: .loom/hooks/tests/ holds 15
    suites, the Hook regression suites step ran 9, and this was the only
    unwired one targeting guard-destructive-generic.sh. A resync dropping the
    vendored strip-literal/quote-context generalizations (#119/#142) would
    re-introduce the false DENY with CI green — the exact failure mode the
    step's charter exists to prevent.
    Closes #257
    Loom-Story: 2AMLogic/gf180-gate-driver#257
    Loom-Trace-Id: a4968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
2026-09-29 refactor(sim): share mismatch-campaign boilerplate via harness/campaign.py
    Three of the four Monte Carlo mismatch campaigns under `sim/` each carried
    their own byte-identical copy of the campaign driver, the `PointOutcome`
    accessors and the evidence writers -- ~170 lines apiece, reimplemented
    three times rather than shared through the harness package the way
    `report.py`'s `device_*` helpers already are for the
    device-characterization side of the tree.
    New `sim/harness/campaign.py` holds the one implementation: the
    three-leg negative control + derived-seed draw driver
    (`run_point_campaign`), the shared `PointOutcome` accessors, the evidence
    writers (`write_sample_csv`, `write_log`, `baseline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
2026-09-29 chore: remove dead code (_fmt_mohmmm, baseline_worst, unused sys import)
    Three unreachable/unused items verified against origin/main cf25b1b
    (post-#258/PR-#265):
    - _fmt_mohmmm() in run_ronw_mismatch.py: mOhm.mm formatting helper,
    defined but never called (call sites format inline instead).
    - PointOutcome.baseline_worst() in run_output_stage_mismatch.py: the
    baseline twin of control_worst() (which is used), with zero call
    sites of its own.
    - `import sys` in check_tier_report.py: imported but never referenced.
    Closes #268
    Loom-Story: 2AMLogic/gf180-gate-driver#268
    Loom-Trace-Id: 022d44d44ed450381030d6e8fea3da4f
    Loom-Build: 0.19.464 eeb7def821cc58fe6300f03e556fa9490a316bfc clean
2026-09-29 docs(sim): characterize and document ngspice Reference value nondeterminism
    Traces the run-to-run `Reference value :` line drift in committed corner
    logs (issue #266) to ngspice's batch-mode transient writer (outitf.c
    OUTpData()): a wall/CPU-clock-gated (0.25s) progress heartbeat that echoes
    the transient's reference vector (simulation time), unrelated to any .meas
    computation. Confirmed by reproduction (two --smoke runs of
    run_indrv_mismatch.py, `m_<name>` lines and the resulting record body
    byte-identical, only `Reference value` lines differ) and by timing
    correlation (gate-driver-core-drive's ~1s deck crosses the tick,
    output-stage-drive's ~0.2s deck never does -- explaining
    output-stage-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
2026-09-29 fix(guard): never arm the assignment recognition inside a for-loop word list
    Judge-pass defect found in the assignment-literal recognition (#260): in
    `for cmd in x= "<phrase>"; do $cmd; done` the trailing `x=` word armed the
    new assignment trigger, and the var-use gate then checked the WRONG name
    (`x`, not the loop variable `cmd`) — so the list element, which `$cmd`
    executes, was masked and a real force-push invocation was newly allowed
    that the pre-#260 code denied.
    The arming check now refuses when the segment still carries an
    unterminated `for <var> in` opener (no ;/&/|/paren between the opener and
    the tail): a trailing NAME= there is a word-list element, left to the
    #244 machinery's o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
2026-09-29 fix(guard): two false-deny routes in worktree-write-confinement (#272)
    Both defects made an otherwise-confined write deny at the catastrophic
    worktree-write-confinement-unresolved-var tier; the command logged at
    ts=2026-09-29T11:25:15Z hit both at once. Each is independently
    sufficient, so both are fixed.
    Defect 1 -- `;`-terminated assignment word (mktempd_assign_len).
    qsplit() does not segment after a quoted command substitution, so the
    one-line scratch-sandbox idiom
    T="$(mktemp -d)"; trap 'rm -rf "$T"' EXIT
    reaches mktempd_assign_len() as ONE segment. Its word-end rule accepted
    only a whitespace-led tail, so the `;`-led tail was refused and the word
    fell through to the generic white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
2026-09-29 refactor(sim): fold ronw's private campaign layer into harness/campaign.py
    sim/low-side-power-switch-ronw-mismatch/run_ronw_mismatch.py carried a
    byte-shaped-identical copy of the mismatch-campaign skeleton (seed policy,
    three-leg negative control, N derived-seed draws, CSV sidecar) that issue
    #258 already extracted into sim/harness/campaign.py for the other three
    mismatch campaigns. This finishes that extraction: campaign.py gains
    run_device_point_campaign, a device-style driver parameterized over a "run
    one sample" callable, so the shape is shared while ronw's DC-sweep
    execution layer (which does not fit the Testbench-based runner.run_point/
    run_samples) stays its own.
    run_ronw_mismatch.p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
2026-09-29 fix(tests): source the 5 defaults/-pathed hook suites from .loom/hooks/
    These 5 suites sourced the hook under test from $REPO_ROOT/defaults/hooks/,
    the layout of the Loom source repo. This installed consumer repo ships no
    defaults/ tree, so each suite died at its setup cp and silently executed
    zero assertions (~31% of the hook regression coverage running no checks).
    Retarget SRC_HOOK (and the staged config-resolver/canonical-path/skill-routes
    copies) to the .loom/ vendored layout the 11 healthy suites already use, and
    add the same [[ ! -d defaults ]] layout-pinning assertion as
    test-guard-sql-ddl-jq-prose.sh. Replace the now-vacuous defaults/-vs-.loom/
    byte-comparisons with that assertion,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
2026-09-29 chore(loom): pin docs/guard-hooks.md in resync-ignore to unblock fleet-resync
    The scheduled fleet-resync has reported "FAILED gf180-gate-driver —
    resync-installed.sh returned non-zero" on all four dispatch hosts since
    v0.19.505. A dry run on robb-studio shows exactly one blocked file:
    blocked docs/guard-hooks.md (would remove 37 line(s) unique to the
    installed copy — needs --force)
    Those 37 lines are repo-local documentation added by 6257ef2 (#260,
    assignment-literal force-push masking) and 6eb6f54 (#279,
    LOOM_GUARD_LOG_SUPPRESS). Both describe behaviour implemented in the guard
    hooks this repo already pins, and neither exists upstream, so the local-fix
    guard correctly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
2026-10-01 chore: resync installed Loom surfaces
    resynced_by: fleet-resync
    invocation: fleet-resync.sh --fleet-only --push
    <!-- loom:provenance v1 build=unknown 19f4e67fd0a0afbd3d8b6606ca91ceac911377a3 clean prompts=none sweep=none story=none trace=78a5dfbdfd8c530aecd1bb436fd096df host=loom-worker-2 base=d5469719f5746f8b4dc362e076d8ddf5fb1d2222 run=loom-run/v1:timer:loom-worker-2/fleet-resync:67c759f7ef3c43e38d3fa8d5f19a2dd1 installs=0.19.593 658650a4f0eff932ac66a8f690eaedf8123fc83b -->
    Loom-Story: none
    Loom-Trace-Id: 78a5dfbdfd8c530aecd1bb436fd096df
    Loom-Build: unknown 19f4e67fd0a0afbd3d8b6606ca91ceac911377a3 clean
2026-10-01 chore: resync installed Loom surfaces
    <!-- loom:provenance v1 build=unknown 56435bf476452911283e43940ecfd9a30f804af9 clean prompts=none sweep=none story=none trace=342405c5ebc99bdbf17afbd983c0c41c host=loom-worker-2 base=100fc4875dca40232beb2e669746ca21fbbe6b47 run=loom-run/v1:timer:loom-worker-2/fleet-resync:20c09f231d424cd5b57ca7991848dd8a installs=0.19.603 8c39bf7cde8a8c03d1aaee441f397c017b6a3a9e -->
    Loom-Trace-Id: 342405c5ebc99bdbf17afbd983c0c41c
    Loom-Build: unknown 56435bf476452911283e43940ecfd9a30f804af9 clean
    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
2026-10-01 chore: resync installed Loom surfaces
    <!-- loom:provenance v1 build=unknown f2868e6b4d60d11a8ab47d25cad9e248229d2f66 clean prompts=none sweep=none story=none trace=4e2766ed5160781df891476246a9be2e host=robb-studio base=6c93fe3dca8638dea1a8963dffeebf3d59269e18 run=loom-run/v1:timer:robb-studio/fleet-resync:2d3851d5-1673-43ae-bcc6-e5c971b37f33 installs=0.19.603 74778a6aeea5d9e06b489400942b35f33c8bb766 -->
    Loom-Trace-Id: 4e2766ed5160781df891476246a9be2e
    Loom-Build: unknown f2868e6b4d60d11a8ab47d25cad9e248229d2f66 clean
    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
2026-10-01 chore: resync installed Loom surfaces
    <!-- loom:provenance v1 build=unknown d6714830391f7596338b8de40ee2d0f45dcd12f5 clean prompts=none sweep=none story=none trace=af273f717e759e690d07f372734e9278 host=robb-pro base=50ea46627ee062f4ba774e798218324304ce2153 run=loom-run/v1:timer:robb-pro/fleet-resync:92e2f9ba-d083-411b-833b-ae52d169ef04 installs=0.19.605 6eb2b65a4496b7becb84ef1f944493a541fd01cd -->
    Loom-Trace-Id: af273f717e759e690d07f372734e9278
    Loom-Build: unknown d6714830391f7596338b8de40ee2d0f45dcd12f5 clean
    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
2026-10-01 chore: resync installed Loom surfaces
    <!-- loom:provenance v1 build=unknown e956e9fee69e53f08b887ca20e14d9058d6f9aee clean prompts=none sweep=none story=none trace=1077dafeb758858c149dd37f4ece3c77 host=loom-worker-2 base=c37a0b362c0254fbc4aa0a5ca91b939acf696c58 run=loom-run/v1:timer:loom-worker-2/fleet-resync:e3773167b12d4b3aafa1f76848245174 installs=0.19.609 ff30576dacc8c2734b1c7434bedd29c47122caeb -->
    Loom-Trace-Id: 1077dafeb758858c149dd37f4ece3c77
    Loom-Build: unknown e956e9fee69e53f08b887ca20e14d9058d6f9aee clean
    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
2026-10-01 chore: resync installed Loom surfaces
    <!-- loom:provenance v1 build=unknown 617257919edc1b9b9ee27532c5ec1b8a64523388 clean prompts=none sweep=none story=none trace=dbafe4f8526617aa07c890721298a080 host=robb-studio base=e84c3ba9d8d795229e0b45d9cb0b022573567132 run=loom-run/v1:timer:robb-studio/fleet-resync:1817df66-02cc-4b27-927d-a38485da550a installs=0.19.610 c94891dd526cf6db5ee02045424c6913be522048 -->
    Loom-Trace-Id: dbafe4f8526617aa07c890721298a080
    Loom-Build: unknown 617257919edc1b9b9ee27532c5ec1b8a64523388 clean
    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
2026-10-01 chore: resync installed Loom surfaces
    <!-- loom:provenance v1 build=unknown a2a39ac2736eb2686e2c65412d939e67c0438a7d clean prompts=none sweep=none story=none trace=fc1a121767151aae5bd7427c683b7db6 host=robb-pro base=3170c470c1e3b51249aedac1cc6205e91456484f run=loom-run/v1:timer:robb-pro/fleet-resync:708eb7c8-469d-4783-80b7-bafe142df3c4 installs=0.19.612 d25614656adcf70162da95c5e1035e99a0639a1a -->
    Loom-Trace-Id: fc1a121767151aae5bd7427c683b7db6
    Loom-Build: unknown a2a39ac2736eb2686e2c65412d939e67c0438a7d clean
    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
2026-10-01 chore(tooling): update repo-skills to v0.19.5
    Fleet-wide Repo Skills rollout (2026-10-01). compute-drift's axis 6
    reported repo-skills at 11 different versions across the fleet's
    checkouts; this brings gf180-gate-driver from v0.10.0 to v0.19.5 (rjwalters/repo
    @ ff282cd), staging only the installer's own surface.
    Loom-Trace-Id: 038dce5d677bceeeca3c111787ac5b68
    Loom-Build: unknown unknown unknown
    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
2026-10-01 chore: resync installed Loom surfaces
    <!-- loom:provenance v1 build=unknown 126c80914e42f913c4fc778d3ddce96daa2c7a77 clean prompts=none sweep=none story=none trace=15a20fbea7a00d0922b943088c80e19d host=loom-worker-1 base=4371825db87899de4748515bd0a8e9d04e212cc0 run=loom-run/v1:script:loom-worker-1/fleet-resync:ecc423da-4625-49de-b25a-692fd669a029 installs=0.19.612 d47e0c57a6bea6f7b61ef9ce62632d70c39ef5d5 -->
    Loom-Trace-Id: 15a20fbea7a00d0922b943088c80e19d
    Loom-Build: unknown 126c80914e42f913c4fc778d3ddce96daa2c7a77 clean
    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
2026-10-01 chore: resync installed Loom surfaces
    <!-- loom:provenance v1 build=unknown 126c80914e42f913c4fc778d3ddce96daa2c7a77 clean prompts=none sweep=none story=none trace=a0a42bd10fcfa6d7cbcc9c021c406848 host=loom-worker-2 base=b98f61a93c74e992406d6475f93dc51dc82affcc run=loom-run/v1:timer:loom-worker-2/fleet-resync:9e174e6bb0fa41d786e4a86e45632b6f installs=0.19.612 6f0871dc66e62b36d8382ced980d2805bfd97e50 -->
    Loom-Trace-Id: a0a42bd10fcfa6d7cbcc9c021c406848
    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
2026-10-01 chore: resync installed Loom surfaces
    <!-- loom:provenance v1 build=unknown 6f3411c8a63e68097dde01bce8a8422230f54218 clean prompts=none sweep=none story=none trace=9aa0a46bb352b9665fdaa5f5b3b85dd7 host=robb-pro base=bdd4ac258154b910b9f625b41e43a6d606e00dad run=loom-run/v1:timer:robb-pro/fleet-resync:ca419e1d-6646-4678-ac7a-b263e4b5119e installs=0.19.612 7731400b3e3e1df39074564166edf656feb0999c -->
    Loom-Trace-Id: 9aa0a46bb352b9665fdaa5f5b3b85dd7
    Loom-Build: unknown 6f3411c8a63e68097dde01bce8a8422230f54218 clean
    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
2026-10-01 feat(erc): declare all four well/substrate tie classes in the supply spec
    Add ties[] to layout/erc-supply-spec.json so erc.missing_tie is computed
    (T1 item 11, issue #256): the two split-rail Nwell classes selected by
    the Dualgate marker via well_requires/well_excludes (1 island on
    VDD_LOGIC, 14 on VDD_DRV), the 17 LVPWELL patches on GND_DRV, and the
    native substrate under the 3.3 V group asserted with well_layer:null +
    well_boxes. Committed report 20261001-231815-1ac9445 from klt
    0.6.0+g21b0cc1d6883 (>= 2c1bd1b3): erc_status clean, zero findings,
    every tie graded checked with none skipped. Manifest gains item 11 and
    klt signoff renders it met; the ERC negative control re-rules all three
    arm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
2026-10-02 chore: resync installed Loom surfaces
    <!-- loom:provenance v1 build=unknown 13c0a3ef467a888520a6529ab34486ab8be826be clean prompts=none sweep=none story=none trace=41356080f367e491d5ff03f17bb98c27 host=loom-worker-2 base=818723ead2fffae7cadfe646ff70845c9f328932 run=loom-run/v1:timer:loom-worker-2/fleet-resync:44455fbcbab745abb92cea192fafbb1d installs=0.19.614 3c79f7b1d0cc14723e049cff4250ff7330804326 -->
    Loom-Trace-Id: 41356080f367e491d5ff03f17bb98c27
    Loom-Build: unknown 13c0a3ef467a888520a6529ab34486ab8be826be clean
    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
2026-10-02 chore: resync installed Loom surfaces
    <!-- loom:provenance v1 build=unknown ea2dd21f2ba310ec007d047ddfecc6cd27d220ac clean prompts=none sweep=none story=none trace=f04a67f3922788d2ccdd66578c8d18f9 host=loom-worker-1 base=f4998cc939df93d03ee7578c91328df3c5c0544c run=loom-run/v1:timer:loom-worker-1/fleet-resync:1c3b601dd998488595adc09040c007d4 installs=0.19.614 79f4897c5d3c78dbfc1b022f77d244838dbf4ccb -->
    Loom-Trace-Id: f04a67f3922788d2ccdd66578c8d18f9
    Loom-Build: unknown ea2dd21f2ba310ec007d047ddfecc6cd27d220ac clean
    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
2026-10-02 chore: resync installed Loom surfaces
    <!-- loom:provenance v1 build=unknown 6f3411c8a63e68097dde01bce8a8422230f54218 clean prompts=none sweep=none story=none trace=acb28d0049e0cc75536f96d503f6e814 host=robb-studio base=f9c5b1091721faab49d1e515c33f413cafea906d run=loom-run/v1:timer:robb-studio/fleet-resync:85d2b1b5-e81d-40c3-ab6a-9a00efbc4ee2 installs=0.19.616 d86523eeadb32b95777f3cd3a76dd2f72f0bf792 -->
    Loom-Trace-Id: acb28d0049e0cc75536f96d503f6e814
    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
2026-10-02 chore: resync installed Loom surfaces
    <!-- loom:provenance v1 build=unknown 2b50bd69eddd038dd738465aa58a9ebca11410ac clean prompts=none sweep=none story=none trace=324e4f607054d0396cfdf8fdc01e93ae host=robb-pro base=bff809b155d3bc7b0b8988b89bbe84e561745431 run=loom-run/v1:timer:robb-pro/fleet-resync:a63799f1-2ad7-4946-b81d-2ec231bc2d2f installs=0.19.617 81cb2ad7e091b19d6a2b95d1add6938c2100d46b -->
    Loom-Trace-Id: 324e4f607054d0396cfdf8fdc01e93ae
    Loom-Build: unknown 2b50bd69eddd038dd738465aa58a9ebca11410ac clean
    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
2026-10-02 chore: resync installed Loom surfaces
    <!-- loom:provenance v1 build=unknown 00d92b326aed50280cd90dc116b7caec27668251 clean prompts=none sweep=none story=none trace=9a5d23cc82b6d3a1c83bfee47bd04970 host=loom-worker-2 base=e0378b0ac56ca26d0b5feae1bf4e1ffb31132579 run=loom-run/v1:timer:loom-worker-2/fleet-resync:12136a7a025d49f3a60b5edb04a3ff81 installs=0.19.619 4c0f505e4f0b76f8ccec07bda6d8b839030c077b -->
    Loom-Trace-Id: 9a5d23cc82b6d3a1c83bfee47bd04970
    Loom-Build: unknown 00d92b326aed50280cd90dc116b7caec27668251 clean
    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
2026-10-02 chore: resync installed Loom surfaces
    <!-- loom:provenance v1 build=unknown 456dad6d90259846313dc3bb80bf4e5471ef2d76 clean prompts=none sweep=none story=none trace=bb9688c03fb5211d06f48c8838a5505c host=robb-studio base=86ad40662cd967fbaf82156437a90a48ae9de42b run=loom-run/v1:timer:robb-studio/fleet-resync:e965c017-8ec7-485d-b46e-aeb399b81fb4 installs=0.19.620 0d28ba49f5a88fdb37271de9cb0144eb3442c6e3 -->
    Loom-Trace-Id: bb9688c03fb5211d06f48c8838a5505c
    Loom-Build: unknown 456dad6d90259846313dc3bb80bf4e5471ef2d76 clean
    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
2026-10-02 chore: resync installed Loom surfaces
    <!-- loom:provenance v1 build=unknown 6c6d2b6565dc13eff4c6811b9c670f452106516b clean prompts=none sweep=none story=none trace=539be979ae694d66ede516a7b5d17e41 host=robb-pro base=e70993bf56f48d342726483e4ab5fa051020b1e3 run=loom-run/v1:timer:robb-pro/fleet-resync:9444d216-de08-442f-8352-ba59f6e81bb3 installs=0.19.621 a90dc1d794eb9ff70aaf939ebf495abe716f3bdd -->
    Loom-Trace-Id: 539be979ae694d66ede516a7b5d17e41
    Loom-Build: unknown 6c6d2b6565dc13eff4c6811b9c670f452106516b clean
    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
2026-10-02 chore: resync installed Loom surfaces
    <!-- loom:provenance v1 build=unknown f6d28134bfe476967e005d97424073085f55e8a3 clean prompts=none sweep=none story=none trace=27eb90670d441065f593e941066ee005 host=loom-worker-2 base=8b6fad50e0c37611688302c7cf19e83e363d0fa8 run=loom-run/v1:timer:loom-worker-2/fleet-resync:04001bba930241cf9e325bf304a9270a installs=0.19.623 ccc19c2bbe2aa65328427730fa53f70eb56128c6 -->
    Loom-Trace-Id: 27eb90670d441065f593e941066ee005
    Loom-Build: unknown f6d28134bfe476967e005d97424073085f55e8a3 clean
    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
2026-10-02 chore: resync installed Loom surfaces
    <!-- loom:provenance v1 build=unknown bc461736314499b6c2c4c0ad51fb2294f60336f5 clean prompts=none sweep=none story=none trace=c3ea68717dd3a908dbbd60a35bc8b5d6 host=robb-studio base=7ecdf905d2ff0c545b8a6db2754a719df891bcde run=loom-run/v1:timer:robb-studio/fleet-resync:8d4c49e2-3258-4080-b0c8-082499053654 installs=0.19.623 a50aaf70069f8897c41a64b7d90783c5ab8294e0 -->
    Loom-Trace-Id: c3ea68717dd3a908dbbd60a35bc8b5d6
    Loom-Build: unknown bc461736314499b6c2c4c0ad51fb2294f60336f5 clean
    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
2026-10-02 chore: resync installed Loom surfaces
    <!-- loom:provenance v1 build=unknown bc461736314499b6c2c4c0ad51fb2294f60336f5 clean prompts=none sweep=none story=none trace=8bee8a664bfc89e0bbfbb3c2de7342ba host=loom-worker-2 base=7f59f1faec51810a1283a38d05ab1e04c20bee6d run=loom-run/v1:timer:loom-worker-2/fleet-resync:de2ceceb48ea4927a1334d08dc0082fe installs=0.19.624 5f49564fa78ae06f8c48d5224dae9ded04200bb7 -->
    Loom-Trace-Id: 8bee8a664bfc89e0bbfbb3c2de7342ba
    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
2026-10-03 chore: resync installed Loom surfaces
    <!-- loom:provenance v1 build=unknown 752d316233ed1a3da9e4f69ad760eb99bb477747 clean prompts=none sweep=none story=none trace=7851839b67c00a023e97cbdea1f580e1 host=robb-pro base=617b32e4ff0d43273a2808ef0dc90995d507cb69 run=loom-run/v1:timer:robb-pro/fleet-resync:ae492b66-dca0-4da4-acab-8d26778f2d5c installs=0.19.624 121fac45f5006879bf58a18c951b9243d9099a18 -->
    Loom-Trace-Id: 7851839b67c00a023e97cbdea1f580e1
    Loom-Build: unknown 752d316233ed1a3da9e4f69ad760eb99bb477747 clean
    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
2026-10-03 chore: resync installed Loom surfaces
    <!-- loom:provenance v1 build=unknown b34a08286a42f47f917ec46647d4d167c1f5207c clean prompts=none sweep=none story=none trace=a8e453124b899b440f42c9d83837c7b6 host=loom-worker-2 base=0c53deae1d443fe193b1cf869df6c7f815d0bd40 run=loom-run/v1:timer:loom-worker-2/fleet-resync:f02dd5df715347fe90fe14b9353a1b66 installs=0.19.624 0162badc662fb30c070e70611aa8ff74a8486d54 -->
    Loom-Trace-Id: a8e453124b899b440f42c9d83837c7b6
    Loom-Build: unknown b34a08286a42f47f917ec46647d4d167c1f5207c clean
    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
2026-10-03 chore: resync installed Loom surfaces
    <!-- loom:provenance v1 build=unknown 3437cece5ab759f772122f8d18a6d2f05d246cde clean prompts=none sweep=none story=none trace=bba21427f750636f851279cfae92b4e5 host=loom-worker-1 base=ef5236b7e1e6d9c3e911ef82a62a79c031fc353d run=loom-run/v1:timer:loom-worker-1/fleet-resync:9440cda9476f404caa282e360a81ee03 installs=0.19.636 e41edfbb52c13982f7d8b0577f42957427a6514c -->
    Loom-Trace-Id: bba21427f750636f851279cfae92b4e5
    Loom-Build: unknown 3437cece5ab759f772122f8d18a6d2f05d246cde clean
    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
2026-10-03 chore: resync installed Loom surfaces
    <!-- loom:provenance v1 build=unknown 28040ed11a4369e20f3b7b0154a3fb2a2c35d38c clean prompts=none sweep=none story=none trace=0cd87d01c45d97a2ee57a99363fc0db2 host=robb-studio base=ec1aabfabd480a6ad17e0883547920fccbb30422 run=loom-run/v1:timer:robb-studio/fleet-resync:74b93657-6b04-4ac5-bc77-e0a1682b0595 installs=0.19.636 e41edfbb52c13982f7d8b0577f42957427a6514c -->
    Loom-Trace-Id: 0cd87d01c45d97a2ee57a99363fc0db2
    Loom-Build: unknown 28040ed11a4369e20f3b7b0154a3fb2a2c35d38c clean
    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
2026-10-03 chore: resync installed Loom surfaces
    <!-- loom:provenance v1 build=unknown 388c7fe0cad997f7a887f70c9f2cfe8781a2d512 clean prompts=none sweep=none story=none trace=2046ffd42f138a06b914f34851de3440 host=loom-worker-2 base=c0c4667f1a90d02cc8839e544f799acfc970e974 run=loom-run/v1:timer:loom-worker-2/fleet-resync:17c9456bb1934c70a545b12081496cce installs=0.19.647 d1fe5dead4202be12a964ab891fd5980e7836170 -->
    Loom-Trace-Id: 2046ffd42f138a06b914f34851de3440
    Loom-Build: unknown 388c7fe0cad997f7a887f70c9f2cfe8781a2d512 clean
    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
2026-10-03 chore: resync installed Loom surfaces
    <!-- loom:provenance v1 build=unknown 8078c29e691123d91cd761a786f99cfd25f1809d clean prompts=none sweep=none story=none trace=45869a6374635c036a11a6f379fe31a4 host=robb-pro base=14185ffae701cd2d2b17d0395d733a295f803029 run=loom-run/v1:timer:robb-pro/fleet-resync:b0a94991-052d-4e7d-ba2b-78b971096849 installs=0.19.647 709ca4396e074e5a4d1c5e19721f6ddac7154ca2 -->
    Loom-Trace-Id: 45869a6374635c036a11a6f379fe31a4
    Loom-Build: unknown 8078c29e691123d91cd761a786f99cfd25f1809d clean
    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
2026-10-03 chore: resync installed Loom surfaces
    <!-- loom:provenance v1 build=unknown f9cba29b0602624a23daa17ae04d31d82e10fa91 clean prompts=none sweep=none story=none trace=754b3688f97b6c34894d8cfbf272b81a host=loom-worker-1 base=10e168d9041b47914b1b8bd7470e9a4762f5004c run=loom-run/v1:script:loom-worker-1/fleet-resync:11eb117a-9ff3-4411-88d4-fdd7d6748639 installs=0.19.649 6f2f13b1c31ce420e2250ae040d8e1050c0e761b -->
    Loom-Trace-Id: 754b3688f97b6c34894d8cfbf272b81a
    Loom-Build: unknown f9cba29b0602624a23daa17ae04d31d82e10fa91 clean
    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
2026-10-03 chore: resync installed Loom surfaces
    <!-- loom:provenance v1 build=unknown f9cba29b0602624a23daa17ae04d31d82e10fa91 clean prompts=none sweep=none story=none trace=544a028e3829d4020b8aaa144e5fa628 host=robb-studio base=c771758ac24041bebe879f22a54e669cb04f65cb run=loom-run/v1:script:robb-studio/fleet-resync:5b5b8b83-7139-447d-88bd-417dcf375aa6 installs=0.19.649 6f2f13b1c31ce420e2250ae040d8e1050c0e761b -->
    Loom-Trace-Id: 544a028e3829d4020b8aaa144e5fa628
    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
2026-10-03 chore: resync installed Loom surfaces
    <!-- loom:provenance v1 build=unknown f9cba29b0602624a23daa17ae04d31d82e10fa91 clean prompts=none sweep=none story=none trace=1057aaaf811f6dd2d64a3bb6d4b3ac49 host=robb-pro base=f4a27f4d5b05d6ff97934af69f3c00e9762f4dbc run=loom-run/v1:timer:robb-pro/fleet-resync:785c1ea0-d7f2-4810-99e9-cd9368aebe0c installs=0.19.649 2118aabb5a925f1ec4669b4d3d31176a46d8f2a6 -->
    Loom-Trace-Id: 1057aaaf811f6dd2d64a3bb6d4b3ac49
    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
2026-10-03 chore: resync installed Loom surfaces
    <!-- loom:provenance v1 build=unknown 72f61d9aa0fe08f1ef59f1a97a314e474455801e clean prompts=none sweep=none story=none trace=577d2185973ec59f059fa15bf5b5e514 host=loom-worker-1 base=bd64ac3b9ae973e6e239a6ce9584509ff6318e3f run=loom-run/v1:script:loom-worker-1/fleet-resync:5728a930-137f-4d2f-a962-1cdd7a6a1d46 installs=0.19.652 235a64727b907d65529151af0a962b14f16462a0 -->
    Loom-Trace-Id: 577d2185973ec59f059fa15bf5b5e514
    Loom-Build: unknown 72f61d9aa0fe08f1ef59f1a97a314e474455801e clean
    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
2026-10-03 chore: resync installed Loom surfaces
    <!-- loom:provenance v1 build=unknown 72f61d9aa0fe08f1ef59f1a97a314e474455801e clean prompts=none sweep=none story=none trace=845aaa0eb340f80f12095e2e8b421ed1 host=robb-pro base=e578a2da5924010c691aa8cd45b4d5b825ce06a7 run=loom-run/v1:script:robb-pro/fleet-resync:344add4b-df8a-49e8-8563-2765673acc76 installs=0.19.652 235a64727b907d65529151af0a962b14f16462a0 -->
    Loom-Trace-Id: 845aaa0eb340f80f12095e2e8b421ed1
    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
2026-10-03 chore: resync installed Loom surfaces
    <!-- loom:provenance v1 build=unknown 61870b40779d205c1555e801c6e1d95df083cdea clean prompts=none sweep=none story=none trace=cfd2c16d2cd3651ad0d068a28bbf62b8 host=loom-worker-1 base=03b67dadf3e3b581530589f94cc34f7bcdf8cb54 run=loom-run/v1:timer:loom-worker-1/fleet-resync:fd27683751ca428cb28a8d58a04fc51a installs=0.19.652 235a64727b907d65529151af0a962b14f16462a0 -->
    Loom-Trace-Id: cfd2c16d2cd3651ad0d068a28bbf62b8
    Loom-Build: unknown 61870b40779d205c1555e801c6e1d95df083cdea clean
    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
2026-10-03 chore: resync installed Loom surfaces
    <!-- loom:provenance v1 build=unknown 61870b40779d205c1555e801c6e1d95df083cdea clean prompts=none sweep=none story=none trace=f8c6a615535e3729d749bc44ac28436c host=robb-studio base=9417cc058a11c005c9177a10e02e46596c05cffc run=loom-run/v1:script:robb-studio/fleet-resync:66678e69-bbef-41df-8a24-1d1ac846c831 installs=0.19.652 235a64727b907d65529151af0a962b14f16462a0 -->
    Loom-Trace-Id: f8c6a615535e3729d749bc44ac28436c
    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
2026-10-03 chore: resync installed Loom surfaces
    <!-- loom:provenance v1 build=unknown 21130104346fe9c464ce8a3fdf82c1d3e9667639 clean prompts=none sweep=none story=none trace=36308fff5a3c323c3d1bf6fffb6cd122 host=robb-studio base=b4afc7a8252acde6013b88c56196c7c1683aabfa run=loom-run/v1:timer:robb-studio/fleet-resync:89972fbd-0774-4402-bbb7-26c33a851735 installs=0.19.652 fb69233bd8f1dfc2bdee37d8b934f99274dc0193 -->
    Loom-Trace-Id: 36308fff5a3c323c3d1bf6fffb6cd122
    Loom-Build: unknown 21130104346fe9c464ce8a3fdf82c1d3e9667639 clean
    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
2026-10-04 chore: resync installed Loom surfaces
    <!-- loom:provenance v1 build=unknown 61870b40779d205c1555e801c6e1d95df083cdea clean prompts=none sweep=none story=none trace=fb9213e215442932d2af05f3b14977de host=robb-pro base=1591ec07ec141f224b61fa9e44e389d10706e7e5 run=loom-run/v1:timer:robb-pro/fleet-resync:4c70cd1d-08cd-4add-8e2a-9a75160d163f installs=0.19.655 36c39e3c6f56e1979647ec235b4bd19c77db22f3 -->
    Loom-Trace-Id: fb9213e215442932d2af05f3b14977de
    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
2026-10-04 chore: resync installed Loom surfaces
    <!-- loom:provenance v1 build=unknown 61870b40779d205c1555e801c6e1d95df083cdea clean prompts=none sweep=none story=none trace=baa6c2cfcae1a320917c00ff2eb8b630 host=loom-worker-2 base=dfacbefc637c047c0387e1ca51655754493a255d run=loom-run/v1:timer:loom-worker-2/fleet-resync:741a7f0f16df4fb1be4e657aeacd1244 installs=0.19.655 fc667a4faae1227f8a6837431f8a0c2d0aeaa7dd -->
    Loom-Trace-Id: baa6c2cfcae1a320917c00ff2eb8b630
    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
2026-10-04 chore: resync installed Loom surfaces
    <!-- loom:provenance v1 build=unknown b922acb2ac655cbccd71daa9e3f05a325a094ca5 clean prompts=none sweep=none story=none trace=833eeb34d4ca65c3f8c6f7824ddca3a3 host=robb-studio base=5ee8849067242e2c9d27bfacdf15966421910f57 run=loom-run/v1:timer:robb-studio/fleet-resync:0d44f6dc-6a62-4d43-b49d-7cfdd7dbd823 installs=0.19.663 0a51e373e7fe1be156c5774b2c827d4b745368a3 -->
    Loom-Trace-Id: 833eeb34d4ca65c3f8c6f7824ddca3a3
    Loom-Build: unknown b922acb2ac655cbccd71daa9e3f05a325a094ca5 clean
    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
2026-10-04 chore: resync installed Loom surfaces
    <!-- loom:provenance v1 build=unknown 746ecb5f9d7e64ba1d2526f1e997530ad4f3dd43 clean prompts=none sweep=none story=none trace=f09501431241df2ec5688e334ba43dfe host=loom-worker-2 base=c1d052d58520b4b1e3933fbf41f634f05f32066f run=loom-run/v1:timer:loom-worker-2/fleet-resync:70797dad61fb4e21806716d54f1ce910 installs=0.19.669 59a1f84e3742827a8033bb153ebbedc1759bee72 -->
    Loom-Trace-Id: f09501431241df2ec5688e334ba43dfe
    Loom-Build: unknown 746ecb5f9d7e64ba1d2526f1e997530ad4f3dd43 clean
    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
2026-10-04 chore: resync installed Loom surfaces
    <!-- loom:provenance v1 build=unknown 8080d0485cc1312129ee642b084944c56d1be074 clean prompts=none sweep=none story=none trace=ed180bcab6828041123ad54d8ddb4037 host=robb-pro base=819f58caaa0d22ee194499b2bac9db478716e0ca run=loom-run/v1:timer:robb-pro/fleet-resync:e97b2f08-4ad9-4b66-a166-5b19820e2d1f installs=0.19.669 59a1f84e3742827a8033bb153ebbedc1759bee72 -->
    Loom-Trace-Id: ed180bcab6828041123ad54d8ddb4037
    Loom-Build: unknown 8080d0485cc1312129ee642b084944c56d1be074 clean
    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
2026-10-04 chore: resync installed Loom surfaces
    <!-- loom:provenance v1 build=unknown 83cb6647167ffc000d2c2f479b4e816b68f863f4 clean prompts=none sweep=none story=none trace=ccabffa1e1ba495895b262086030816c host=robb-studio base=e6bd2a70f4b85a6b6e92576354f7ee8ea72ff2f5 run=loom-run/v1:timer:robb-studio/fleet-resync:88a78f1f-d978-47b5-99c3-2aabde811d17 installs=0.19.676 cd4f30bd892ea2595d8218b08150633504b0dd14 -->
    Loom-Trace-Id: ccabffa1e1ba495895b262086030816c
    Loom-Build: unknown 83cb6647167ffc000d2c2f479b4e816b68f863f4 clean
    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
2026-10-04 chore: resync installed Loom surfaces
    <!-- loom:provenance v1 build=unknown 32174d0f7e80508fa66c1a11a2c0fb28c515607e clean prompts=none sweep=none story=none trace=436d7c19b10cd5807625a7ce7190a82f host=loom-worker-2 base=5a4777292ac8b56fb8765b6a6ad5b093d2ff4aaa run=loom-run/v1:timer:loom-worker-2/fleet-resync:19ae50771cc04d8db7b1403c1e66bbea installs=0.19.682 9eccfa110fa294fa32a62ffe8eff669cfcf1a3a6 -->
    Loom-Trace-Id: 436d7c19b10cd5807625a7ce7190a82f
    Loom-Build: unknown 32174d0f7e80508fa66c1a11a2c0fb28c515607e clean
    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
2026-10-04 chore: resync installed Loom surfaces
    <!-- loom:provenance v1 build=unknown 72290fa960e0773b2c50d74042e24914c7327637 clean prompts=none sweep=none story=none trace=f7b6952a649a174398a48b90b6ab4793 host=robb-pro base=c296045f49fc2d6e7b772ac74e9e11b6f8958942 run=loom-run/v1:timer:robb-pro/fleet-resync:72f32482-5cc4-4b38-ab9e-4d2ef0b64e94 installs=0.19.684 bdb8fb331eb51c7def4cdd2c38b611af06f25f6d -->
    Loom-Trace-Id: f7b6952a649a174398a48b90b6ab4793
    Loom-Build: unknown 72290fa960e0773b2c50d74042e24914c7327637 clean
    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
2026-10-04 chore: resync installed Loom surfaces
    <!-- loom:provenance v1 build=unknown 76cda58637be0e74c4cb5b4c8dbc2000e2a9c3d4 clean prompts=none sweep=none story=none trace=614cbada5ce873c2b34a511816309cfc host=robb-studio base=c68229e56c711d96875dd0137bd938b1ff516d0b run=loom-run/v1:timer:robb-studio/fleet-resync:7e559a3b-ffdd-409b-8dd2-ae906a273b0a installs=0.19.692 d4974b9f5ff7843a3cfc06378ea2a69bc120e0f4 -->
    Loom-Trace-Id: 614cbada5ce873c2b34a511816309cfc
    Loom-Build: unknown 76cda58637be0e74c4cb5b4c8dbc2000e2a9c3d4 clean
    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
2026-10-04 chore: resync installed Loom surfaces
    <!-- loom:provenance v1 build=unknown f84bac5c232c093f83c1adc2533d8c75b021cda2 clean prompts=none sweep=none story=none trace=e687830614e4bd1c551ab6cf6186f8f3 host=loom-worker-2 base=893e52f1b395d31ae43a0364a165a15cbb37a70e run=loom-run/v1:timer:loom-worker-2/fleet-resync:2db2c4373ac24de1b7a364e69eaea1ca installs=0.19.695 b0d5b09f207fda439390ea1dd249ad10e7009dfc -->
    Loom-Trace-Id: e687830614e4bd1c551ab6cf6186f8f3
    Loom-Build: unknown f84bac5c232c093f83c1adc2533d8c75b021cda2 clean
    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
2026-10-04 chore: resync installed Loom surfaces
    <!-- loom:provenance v1 build=unknown ac5c275d1c616a9723e747f5a66de93dc80d3512 clean prompts=none sweep=none story=none trace=c777c3912bd31972e9aa3ccab712ae01 host=loom-worker-1 base=4ace7b2e13bb65aede62ef327cf620384d36fcb0 run=loom-run/v1:script:loom-worker-1/fleet-resync:b51a1b33-4958-4408-be36-166e12e8360b installs=0.19.697 ada83a5c7ff66b56b0060ef0be368c9fe56eb3c6 -->
    Loom-Trace-Id: c777c3912bd31972e9aa3ccab712ae01
    Loom-Build: unknown ac5c275d1c616a9723e747f5a66de93dc80d3512 clean
    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
2026-10-04 chore: resync installed Loom surfaces
    <!-- loom:provenance v1 build=unknown a19f642f5c09599c4c64827d81d228eb031be73e clean prompts=none sweep=none story=none trace=34a80e22764eb5055e37faec0eaf65fb host=robb-pro base=02706d35b161e8aba3b86db19fb264fe6ba6d866 run=loom-run/v1:script:robb-pro/fleet-resync:689be620-3ff2-4ff5-a2ce-f6825f6379e2 installs=0.19.697 ada83a5c7ff66b56b0060ef0be368c9fe56eb3c6 -->
    Loom-Trace-Id: 34a80e22764eb5055e37faec0eaf65fb
    Loom-Build: unknown a19f642f5c09599c4c64827d81d228eb031be73e clean
    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
2026-10-04 chore: resync installed Loom surfaces
    <!-- loom:provenance v1 build=unknown 693bdd794cb34afdefd7f0c4596824cd53078a61 clean prompts=none sweep=none story=none trace=7e7be58c80b40f1ac882b00139fb0ca0 host=robb-pro base=8a0eb4a03065fd34bc115f9ddd7fe74f4b472161 run=loom-run/v1:timer:robb-pro/fleet-resync:d64fbd6b-5d9b-491d-9e17-742b375bfba7 installs=0.19.698 aa619a1d07e36e8d90ac01fea63dc39285c93567 -->
    Loom-Trace-Id: 7e7be58c80b40f1ac882b00139fb0ca0
    Loom-Build: unknown 693bdd794cb34afdefd7f0c4596824cd53078a61 clean
    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
2026-10-04 chore: resync installed Loom surfaces
    <!-- loom:provenance v1 build=unknown 693bdd794cb34afdefd7f0c4596824cd53078a61 clean prompts=none sweep=none story=none trace=aa18f1ec102a98d77ffc51c9be6ffbb3 host=robb-studio base=2be847398909d38e808f567c9fdd3a70a0db4e93 run=loom-run/v1:script:robb-studio/fleet-resync:3cb89ca8-62c2-4a69-8434-c4aaa3b64eaf installs=0.19.698 a58f00e0681c50d6bfc5089d0af4b3715198319f -->
    Loom-Trace-Id: aa18f1ec102a98d77ffc51c9be6ffbb3
    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
2026-10-04 chore: resync installed Loom surfaces
    <!-- loom:provenance v1 build=unknown 7a41c2e69ef89d60ed3bd190b94838021bf18d0f clean prompts=none sweep=none story=none trace=d0f04f38b507d85402723643fcf47197 host=loom-worker-1 base=76728cb759cbd05b290d43f7fda66020a7ecb26e run=loom-run/v1:script:loom-worker-1/fleet-resync:8fdc8c1c-f844-4c33-bc80-b424e5b4cf3d installs=0.19.703 89d5a428c652f957d7fad8a546589042d39911bc -->
    Loom-Trace-Id: d0f04f38b507d85402723643fcf47197
    Loom-Build: unknown 7a41c2e69ef89d60ed3bd190b94838021bf18d0f clean
    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
2026-10-05 chore: resync installed Loom surfaces
    <!-- loom:provenance v1 build=unknown ebb37db560de172930e261675a35bd52e429f650 clean prompts=none sweep=none story=none trace=a40e86a64366c7a1e36aea026901334f host=loom-worker-2 base=0242634a6803940baa22fb76642737c2c30951cc run=loom-run/v1:script:loom-worker-2/fleet-resync:90b6cd74-6cc0-4f58-98ee-6ede0ac6f50c installs=0.19.703 f63c3c82e6bf202f2ca7b205b532f681c5ebb2c8 -->
    Loom-Trace-Id: a40e86a64366c7a1e36aea026901334f
    Loom-Build: unknown ebb37db560de172930e261675a35bd52e429f650 clean
    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
2026-10-05 chore: resync installed Loom surfaces
    <!-- loom:provenance v1 build=unknown 7a41c2e69ef89d60ed3bd190b94838021bf18d0f clean prompts=none sweep=none story=none trace=fc04851db12f586b5d58155325131b6e host=robb-studio base=701948343110cf39af841f63a21ca37fa24dbfe7 run=loom-run/v1:timer:robb-studio/fleet-resync:a7d5da6f-a896-4d6f-8d00-aebf47f9b266 installs=0.19.703 2ad9a08fb93de4d7dfac9d2b501d12c684c9c2cc -->
    Loom-Trace-Id: fc04851db12f586b5d58155325131b6e
    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
2026-10-05 chore: resync installed Loom surfaces
    <!-- loom:provenance v1 build=unknown afe7e99e397c242cc319fa80702fb3b23e23f5a7 clean prompts=none sweep=none story=none trace=e46782e1dd9c94461b4cf934ce05296b host=loom-worker-2 base=eb9217c3363cd06f67dd2c28ebbfd2f81a850a99 run=loom-run/v1:timer:loom-worker-2/fleet-resync:caa89259b1fd414ebd2f07500621166d installs=0.19.703 972fe7321be6a9efe2653579379ea3bc40b899b2 -->
    Loom-Trace-Id: e46782e1dd9c94461b4cf934ce05296b
    Loom-Build: unknown afe7e99e397c242cc319fa80702fb3b23e23f5a7 clean
    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
2026-10-05 chore: resync installed Loom surfaces
    <!-- loom:provenance v1 build=unknown b44cb904ebb599db793066ccc631c846862abfbd clean prompts=none sweep=none story=none trace=9590fed7c1b1c9f549ccf3cba24292d7 host=robb-pro base=1f37091494309ae28d7f66a5575dff549a19195d run=loom-run/v1:timer:robb-pro/fleet-resync:dbc6174e-403d-422d-98b6-73a4b6dbf44f installs=0.19.708 dc8faf1eae3143feda6301887c303b1ee45db7f4 -->
    Loom-Trace-Id: 9590fed7c1b1c9f549ccf3cba24292d7
    Loom-Build: unknown b44cb904ebb599db793066ccc631c846862abfbd clean
    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
2026-10-05 chore: resync installed Loom surfaces
    <!-- loom:provenance v1 build=unknown 4548905848fcb7cb875c1c0518f2fd88eb65818e clean prompts=none sweep=none story=none trace=aff5e139797705f6fa0811f102ecd103 host=loom-worker-1 base=d5ce9ca897aa201cb81e129ad1cd229b276bf709 run=loom-run/v1:timer:loom-worker-1/fleet-resync:ba6a9e5686a64abaa842d71acaeae2ca installs=0.19.718 00d99344506bcf00e1aec7e910abe3d13df2d240 -->
    Loom-Trace-Id: aff5e139797705f6fa0811f102ecd103
    Loom-Build: unknown 4548905848fcb7cb875c1c0518f2fd88eb65818e clean
    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
2026-10-05 chore: resync installed Loom surfaces
    <!-- loom:provenance v1 build=unknown e7efbaa6e7b97a7d72da6032044c67525291f4d1 clean prompts=none sweep=none story=none trace=d74a33a6f35e329b3e795991e790ebfd host=robb-studio base=c2047343d73ee5241a13bbd857a6b57bb493cd61 run=loom-run/v1:timer:robb-studio/fleet-resync:304f49c8-5b3e-46a9-a557-945b9ae177f0 installs=0.19.718 00d99344506bcf00e1aec7e910abe3d13df2d240 -->
    Loom-Trace-Id: d74a33a6f35e329b3e795991e790ebfd
    Loom-Build: unknown e7efbaa6e7b97a7d72da6032044c67525291f4d1 clean
    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
2026-10-05 chore: resync installed Loom surfaces
    <!-- loom:provenance v1 build=unknown 347b71e65e709d9fd49aba75d3fb67877fc08818 clean prompts=none sweep=none story=none trace=f9653dd318724c98136e7cef63e551ed host=robb-pro base=7f20a1dc74ec182e4b032ee2fa90ed5ce83cba28 run=loom-run/v1:timer:robb-pro/fleet-resync:cdc95970-9fb1-49fa-a0e6-037a3fab2099 installs=0.19.728 991dcebf6f6b2de6571f1d3400bec083498c6438 -->
    Loom-Trace-Id: f9653dd318724c98136e7cef63e551ed
    Loom-Build: unknown 347b71e65e709d9fd49aba75d3fb67877fc08818 clean
    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
2026-10-05 chore: resync installed Loom surfaces
    <!-- loom:provenance v1 build=unknown 5c0d18101f48fecb656f10fa37afa9b09bf41631 clean prompts=none sweep=none story=none trace=ddcf49552af364cbf6e884bd59584c1f host=loom-worker-1 base=1de530a05854572c73055002c0bcf1f7c4ecc1fe run=loom-run/v1:timer:loom-worker-1/fleet-resync:5eb526a05f244f1985770579e7620ff1 installs=0.19.731 7484b71fce5179a025950e71a82855afaf6fd730 -->
    Loom-Trace-Id: ddcf49552af364cbf6e884bd59584c1f
    Loom-Build: unknown 5c0d18101f48fecb656f10fa37afa9b09bf41631 clean
    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
2026-10-05 chore: resync installed Loom surfaces
    <!-- loom:provenance v1 build=unknown 0b160514b6658e3ab26a71c6525791da25b46fcf clean prompts=none sweep=none story=none trace=311c3eb2c0ab9550d3de38df5523f3d7 host=robb-studio base=a0398961ce772d838a51ddf31de2b2f507d66946 run=loom-run/v1:timer:robb-studio/fleet-resync:e6dec631-b42b-4cf2-b854-cc363cfde6e0 installs=0.19.731 d6146becf339a3d4e55e26e8807ac4571213a00b -->
    Loom-Trace-Id: 311c3eb2c0ab9550d3de38df5523f3d7
    Loom-Build: unknown 0b160514b6658e3ab26a71c6525791da25b46fcf clean
    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
2026-10-05 chore: resync installed Loom surfaces
    <!-- loom:provenance v1 build=unknown 5c0d18101f48fecb656f10fa37afa9b09bf41631 clean prompts=none sweep=none story=none trace=f1e8d4c6e73b8eec3e87a8da52e10f2d host=robb-pro base=ac5427c3802a2187195acb587971bbf0d73268f7 run=loom-run/v1:timer:robb-pro/fleet-resync:5518fd33-81cb-479f-93f0-287ea4b08876 installs=0.19.732 8592cf72c2d9172ec658f717173b6b18c439d06d -->
    Loom-Trace-Id: f1e8d4c6e73b8eec3e87a8da52e10f2d
    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
2026-10-05 chore: resync installed Loom surfaces
    <!-- loom:provenance v1 build=unknown ca170d11544ef499cc9500a45bbad152edacfbd1 clean prompts=none sweep=none story=none trace=6dcfc713b6a851b40932158c2eeb70af host=loom-worker-3 base=737aec5a56bb08739c34ac16627917550309052e run=loom-run/v1:timer:loom-worker-3/fleet-resync:20ce0908ea5a468a9e055470104047ed installs=0.19.734 7ba6ea50c36dfdd2b5e2922dd22c65560980a5a2 -->
    Loom-Trace-Id: 6dcfc713b6a851b40932158c2eeb70af
    Loom-Build: unknown ca170d11544ef499cc9500a45bbad152edacfbd1 clean
    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
2026-10-05 chore: resync installed Loom surfaces
    <!-- loom:provenance v1 build=unknown 03f1c42302d15f8a83425a84a4e36ca484f3f625 clean prompts=none sweep=none story=none trace=f1bc879f8aa652d550764ffcd36e27d1 host=loom-worker-1 base=0a9aa6d6ca5c417d5a53f0c54a141196dd13d954 run=loom-run/v1:timer:loom-worker-1/fleet-resync:f302a3cc8558413492093df510b02418 installs=0.19.734 967abe71d019ce6606018b4e57dee0223b84d96f -->
    Loom-Trace-Id: f1bc879f8aa652d550764ffcd36e27d1
    Loom-Build: unknown 03f1c42302d15f8a83425a84a4e36ca484f3f625 clean
    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
2026-10-05 chore: resync installed Loom surfaces
    <!-- loom:provenance v1 build=unknown ce7557ba58624d48fedbca2bc037dfa8ce3943e7 clean prompts=none sweep=none story=none trace=e1f2558834c47835cd9a53ec8c9a2ffa host=loom-worker-3 base=a5eea109d4a10869d02557e5af54e47871c2c4c1 run=loom-run/v1:timer:loom-worker-3/fleet-resync:50f5f0046e2c4890961b3221bd360247 installs=0.19.734 ba9edb650872e5265eaca0c47f75e3cb828ecad2 -->
    Loom-Trace-Id: e1f2558834c47835cd9a53ec8c9a2ffa
    Loom-Build: unknown ce7557ba58624d48fedbca2bc037dfa8ce3943e7 clean
    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
2026-10-05 chore: resync installed Loom surfaces
    <!-- loom:provenance v1 build=unknown f92eaec38470a7b0732e065f4864faec9a1905d6 clean prompts=none sweep=none story=none trace=07aa020a8179d52651250562e9808b98 host=robb-studio base=859f4fcb2435723c8967d75a6a68cdcbc882816a run=loom-run/v1:timer:robb-studio/fleet-resync:3b3ebdf2-b5f7-48ed-b7bb-5fb945094061 installs=0.19.734 78f3e99c44d0af6d4598adf7577bb6676baf3e8f -->
    Loom-Trace-Id: 07aa020a8179d52651250562e9808b98
    Loom-Build: unknown f92eaec38470a7b0732e065f4864faec9a1905d6 clean
    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
2026-10-06 chore: resync installed Loom surfaces
    <!-- loom:provenance v1 build=unknown ca170d11544ef499cc9500a45bbad152edacfbd1 clean prompts=none sweep=none story=none trace=fca9c14d74d6d634726f5823c51bc62a host=loom-worker-2 base=e995e99d69fa33999644cdcba812d6a47874d286 run=loom-run/v1:timer:loom-worker-2/fleet-resync:23a23f0878c1494cb720941baddfea81 installs=0.19.741 3cede3920c6b567d5400789187a904970d46b0fb -->
    Loom-Trace-Id: fca9c14d74d6d634726f5823c51bc62a
    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
2026-10-06 chore: resync installed Loom surfaces
    <!-- loom:provenance v1 build=unknown e38a22941348fd8e83d1f4b06130d2a214adfb50 clean prompts=none sweep=none story=none trace=a7fe3a9a1fedfce89846c20f2e98ac31 host=robb-pro base=ff8ca1d53593512f469cbb63022062dbdd5543dc run=loom-run/v1:timer:robb-pro/fleet-resync:2d770a42-f0e7-4695-abfa-b912e75382e6 installs=0.19.744 8bc5bcce93c4d9721817387afe8b4b6d79f26054 -->
    Loom-Trace-Id: a7fe3a9a1fedfce89846c20f2e98ac31
    Loom-Build: unknown e38a22941348fd8e83d1f4b06130d2a214adfb50 clean
    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
2026-10-06 chore: resync installed Loom surfaces
    <!-- loom:provenance v1 build=unknown f66ea90ff1bdec51aa4c8dc3f4b2e8d26e3dfd2d clean prompts=none sweep=none story=none trace=66d96c3bb00b04fae967865ee02fc4de host=loom-worker-3 base=f695ad33dcad1a89ba9ff2e8dd73dcd0d82a4e62 run=loom-run/v1:timer:loom-worker-3/fleet-resync:eb2dceb410e848a19d58f96f678c995e installs=0.19.749 6135634b053dc30ef5aa8e6d733bfe79bb2ac734 -->
    Loom-Trace-Id: 66d96c3bb00b04fae967865ee02fc4de
    Loom-Build: unknown f66ea90ff1bdec51aa4c8dc3f4b2e8d26e3dfd2d clean
    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
2026-10-06 chore: resync installed Loom surfaces
    <!-- loom:provenance v1 build=unknown ade8a2c60cc8370d04d72f331141acb6fb32e121 clean prompts=none sweep=none story=none trace=6245fb88b5bdf9f7ccecb6b2168dc335 host=robb-studio base=ae4d7ebddc088fd31623327958b70b275befd3ba run=loom-run/v1:timer:robb-studio/fleet-resync:b305aed2-1a25-4576-aca7-9b017ac4377e installs=0.19.755 8d97d322e1cb3723988504337089beca73d0511c -->
    Loom-Trace-Id: 6245fb88b5bdf9f7ccecb6b2168dc335
    Loom-Build: unknown ade8a2c60cc8370d04d72f331141acb6fb32e121 clean
    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
2026-10-06 chore: resync installed Loom surfaces
    <!-- loom:provenance v1 build=unknown 2489bb7d5203844b3fbe8efbe007f44aa074685d clean prompts=none sweep=none story=none trace=0b5c9263a55c09e6fbd870b2d9ff5d9b host=loom-worker-2 base=077280913d0c75d92be7c78515bacd9e33ba2b68 run=loom-run/v1:timer:loom-worker-2/fleet-resync:d3f5a5beb1144f72ac8be575767b3e03 installs=0.19.760 3a509582b179d91c2d5b5a65a7ba4650c3c08985 -->
    Loom-Trace-Id: 0b5c9263a55c09e6fbd870b2d9ff5d9b
    Loom-Build: unknown 2489bb7d5203844b3fbe8efbe007f44aa074685d clean
    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
2026-10-06 chore: resync installed Loom surfaces
    <!-- loom:provenance v1 build=unknown 986d16b700174622774ff68af4ef323e8d0e23ba clean prompts=none sweep=none story=none trace=cb518f1f5785c258556383940a46c461 host=loom-worker-1 base=c3862935e3c70b0ca2dbeab28a54ae3f909e8884 run=loom-run/v1:timer:loom-worker-1/fleet-resync:97df92c5eca846de85e979810663a94b installs=0.19.765 c6cec65c4f320f11153c72e840e49a5d6a6f1afc -->
    Loom-Trace-Id: cb518f1f5785c258556383940a46c461
    Loom-Build: unknown 986d16b700174622774ff68af4ef323e8d0e23ba clean
    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
2026-10-06 chore: resync installed Loom surfaces
    <!-- loom:provenance v1 build=unknown 85e52221261264d7f7643251de706f00c8db289f clean prompts=none sweep=none story=none trace=a2434124d73d8cca0ca77230fc85adf5 host=robb-pro base=a06f7e99aaada05fff7e1d418b60a8a902632b32 run=loom-run/v1:timer:robb-pro/fleet-resync:abffb067-59ed-4a6e-94b6-8cf3500c935c installs=0.19.768 c9f7ca975144d991bce40f492403b8292e8b7fae -->
    Loom-Trace-Id: a2434124d73d8cca0ca77230fc85adf5
    Loom-Build: unknown 85e52221261264d7f7643251de706f00c8db289f clean
    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
2026-10-06 chore: resync installed Loom surfaces
    <!-- loom:provenance v1 build=unknown 31b34ebfd7d4539094523eaa7b56a104bebe5fc0 clean prompts=none sweep=none story=none trace=16fac36f144dc183c71465eb36c89afc host=loom-worker-3 base=bdde9608a442ef6c2dd89cdd24e1a6b49c1f346d run=loom-run/v1:timer:loom-worker-3/fleet-resync:c763e24590314b918c8ee8df5d2de1db installs=0.19.769 af995a5725fdadf708127f006aa8f248b482d7d7 -->
    Loom-Trace-Id: 16fac36f144dc183c71465eb36c89afc
    Loom-Build: unknown 31b34ebfd7d4539094523eaa7b56a104bebe5fc0 clean
    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
2026-10-06 chore: resync installed Loom surfaces
    <!-- loom:provenance v1 build=unknown 7bed309263b3785eae46a9cbc53b3b24a52b10d2 clean prompts=none sweep=none story=none trace=843adbd5eac450c43d3a2c43da1bf729 host=robb-studio base=34531470e64c96a0b407f917e188921f97d38bab run=loom-run/v1:timer:robb-studio/fleet-resync:f83d5ba4-81f7-479a-9768-6af33d4cc825 installs=0.19.783 a9b459e0c2b1916ceb116db33053e7eb0df57e7b -->
    Loom-Trace-Id: 843adbd5eac450c43d3a2c43da1bf729
    Loom-Build: unknown 7bed309263b3785eae46a9cbc53b3b24a52b10d2 clean
    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
2026-10-06 chore: resync installed Loom surfaces
    <!-- loom:provenance v1 build=unknown 07bc40ba9ab0f7dfe7cd0990377b7ac07a52d220 clean prompts=none sweep=none story=none trace=563f186108419cf03cef002a62c3b201 host=loom-worker-2 base=b8d612d4958c20d9bc850519a2e105b6cd99973a run=loom-run/v1:timer:loom-worker-2/fleet-resync:944beccd157a4197b81feafdd19f443e installs=0.19.785 2f0a9dbb4f06053f747b8a5615a3519f8e30b527 -->
    Loom-Trace-Id: 563f186108419cf03cef002a62c3b201
    Loom-Build: unknown 07bc40ba9ab0f7dfe7cd0990377b7ac07a52d220 clean
    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
2026-10-06 chore: resync installed Loom surfaces
    <!-- loom:provenance v1 build=unknown 31b34ebfd7d4539094523eaa7b56a104bebe5fc0 clean prompts=none sweep=none story=none trace=ea6600df41a4b420b6d8e967f839ccfd host=loom-worker-3 base=3b42bdc672ab068633d91f155244251ebf3b6e6e run=loom-run/v1:timer:loom-worker-3/fleet-resync:c80415b48fd5404bbd599c4f6cc8a448 installs=0.19.793 7ceff96944c39d33e3c2f1141ca650c2c4c05679 -->
    Loom-Trace-Id: ea6600df41a4b420b6d8e967f839ccfd
    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
2026-10-06 chore: resync installed Loom surfaces
    <!-- loom:provenance v1 build=unknown 596a53e525683919daae1b43e6babe9bf847a02f clean prompts=none sweep=none story=none trace=b9c0cb42a5a72ecc21726229c957ef1f host=loom-worker-2 base=b14595f3ac1c386d7d46779830526e6d085c5f8b run=loom-run/v1:timer:loom-worker-2/fleet-resync:21d578f5cc0b4b7ba5f10759f5f30ae8 installs=0.19.801 524bdb33cb26c8355454d7550413c89e72c06fae -->
    Loom-Trace-Id: b9c0cb42a5a72ecc21726229c957ef1f
    Loom-Build: unknown 596a53e525683919daae1b43e6babe9bf847a02f clean
    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
2026-10-06 chore: resync installed Loom surfaces
    <!-- loom:provenance v1 build=unknown 40b591a33adb895d4f46977105f9b264d8a2599b clean prompts=none sweep=none story=none trace=e41c725fe0c176312eb412bc69fe5b01 host=robb-studio base=84f6664e6adac76c50b95b354a3dbe3e054f6779 run=loom-run/v1:timer:robb-studio/fleet-resync:37d704dd-4dfd-4341-adb4-6551637ad147 installs=0.19.802 72ce1f7385747dd773d1644408ec22072b8a5d20 -->
    Loom-Trace-Id: e41c725fe0c176312eb412bc69fe5b01
    Loom-Build: unknown 40b591a33adb895d4f46977105f9b264d8a2599b clean
    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
2026-10-06 chore: resync installed Loom surfaces
    <!-- loom:provenance v1 build=unknown 31b34ebfd7d4539094523eaa7b56a104bebe5fc0 clean prompts=none sweep=none story=none trace=5ad0480c4b21b80f9c852c448319e7a1 host=loom-worker-3 base=475f5bdc41135348895266dafa434e0357883788 run=loom-run/v1:timer:loom-worker-3/fleet-resync:48e836f11f9547ddb96de5aa0d072a05 installs=0.19.810 933f828e779602e492e4e157812988a4b8128111 -->
    Loom-Trace-Id: 5ad0480c4b21b80f9c852c448319e7a1
    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
2026-10-07 chore: resync installed Loom surfaces
    <!-- loom:provenance v1 build=unknown f71cf25de9e75bae6060da4a599df8fbabe75890 clean prompts=none sweep=none story=none trace=64943e35511da4833bbd385cf288be8a host=loom-worker-2 base=5d3ed0efa1b454a17a149ff983dd6cf33bc39b0e run=loom-run/v1:timer:loom-worker-2/fleet-resync:d69eb1b87d4849ae810a145b1b667d2f installs=0.19.822 1c6969ea8726c800a353c236d9f23456a5706f1a -->
    Loom-Trace-Id: 64943e35511da4833bbd385cf288be8a
    Loom-Build: unknown f71cf25de9e75bae6060da4a599df8fbabe75890 clean
    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
2026-10-07 docs: refresh work log and plan from current backlog
2026-10-07 chore: resync installed Loom surfaces
    <!-- loom:provenance v1 build=unknown 31b34ebfd7d4539094523eaa7b56a104bebe5fc0 clean prompts=none sweep=none story=none trace=cb192cb8f72cf6f2711f73f7ee12bebc host=loom-worker-3 base=a847eabfdc0cbe39b4850161d5be0405d4df5db6 run=loom-run/v1:timer:loom-worker-3/fleet-resync:c1e385c3607e43ad8bed9c7d29811c66 installs=0.19.830 a966f7b89b714704fa1225b96e2dbee50480a4c6 -->
    Loom-Trace-Id: cb192cb8f72cf6f2711f73f7ee12bebc
    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
2026-10-07 chore: resync installed Loom surfaces
    <!-- loom:provenance v1 build=unknown 8abdd34fddc879aff407380278baa713eca6b758 clean prompts=none sweep=none story=none trace=ea945665dad5ccb3880de51c4448e8b9 host=robb-pro base=82f712b75ad08b319c04a5f05492f8f2927b4c61 run=loom-run/v1:timer:robb-pro/fleet-resync:1466e397-b80c-46ea-a42c-26a7fbd4e00e installs=0.19.831 61814c9c1912925cdff7418842ff3ea17cd56fe4 -->
    Loom-Trace-Id: ea945665dad5ccb3880de51c4448e8b9
    Loom-Build: unknown 8abdd34fddc879aff407380278baa713eca6b758 clean
    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
2026-10-07 chore: resync installed Loom surfaces
    <!-- loom:provenance v1 build=unknown 628be5bb140bcff803d159201bd61e1b868901b0 clean prompts=none sweep=none story=none trace=093df1dc315c5e78dcccfca9d699d5f5 host=loom-worker-2 base=130fe0512529be50239397b0175c015605b0e39e run=loom-run/v1:timer:loom-worker-2/fleet-resync:0b0ea5e184c0429a9c431fcca6c791ad installs=0.19.832 1a0fc15974bf0575a9155fb8276f7529fc813542 -->
    Loom-Trace-Id: 093df1dc315c5e78dcccfca9d699d5f5
    Loom-Build: unknown 628be5bb140bcff803d159201bd61e1b868901b0 clean
    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
2026-10-07 chore: resync installed Loom surfaces
    <!-- loom:provenance v1 build=unknown 069e3b45d86c08f0d60c8fc2b0096de441e99bdc clean prompts=none sweep=none story=none trace=b1ba9d6b2b581e47827d9c099f717b04 host=loom-worker-1 base=c39630c13c355072554483ee13ba6d734fa25d64 run=loom-run/v1:timer:loom-worker-1/fleet-resync:aada8278bd4843bcaecce69fdf91251e installs=0.19.837 9504f1e9b05e05ce908dd5cffad2aae723621f63 -->
    Loom-Trace-Id: b1ba9d6b2b581e47827d9c099f717b04
    Loom-Build: unknown 069e3b45d86c08f0d60c8fc2b0096de441e99bdc clean
    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
2026-10-07 chore: resync installed Loom surfaces
    <!-- loom:provenance v1 build=unknown 31b34ebfd7d4539094523eaa7b56a104bebe5fc0 clean prompts=none sweep=none story=none trace=ef030e94bce76f728497f5927960865f host=loom-worker-3 base=c2753ab2aeda881e19e65788193458f61e541da7 run=loom-run/v1:timer:loom-worker-3/fleet-resync:28ba4284bfa446c888b501714eda0509 installs=0.19.840 59b533a2a1ed5e186fbf8446b5acbe42d7231854 -->
    Loom-Trace-Id: ef030e94bce76f728497f5927960865f
    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
2026-10-07 chore: resync installed Loom surfaces
    <!-- loom:provenance v1 build=unknown bc59c70c3412a87b31a0dbe65cd6abf968744328 clean prompts=none sweep=none story=none trace=766033e4e881801f24971d664c490ea3 host=robb-studio base=0adf2c2d604e73adcb3965b7dc9ba0d4d395c1c5 run=loom-run/v1:timer:robb-studio/fleet-resync:6b3b079a-890e-4a79-9c3a-0b4bb33ff7c4 installs=0.19.840 59b533a2a1ed5e186fbf8446b5acbe42d7231854 -->
    Loom-Trace-Id: 766033e4e881801f24971d664c490ea3
    Loom-Build: unknown bc59c70c3412a87b31a0dbe65cd6abf968744328 clean
    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
2026-10-07 chore: resync installed Loom surfaces
    <!-- loom:provenance v1 build=unknown a068938e7a6c13759bcb3943e408273a3d352257 clean prompts=none sweep=none story=none trace=76bec863c8f6aff2d49b3aa2be128619 host=robb-pro base=332232c13666b70fe1837914fc3ed5371c130be7 run=loom-run/v1:timer:robb-pro/fleet-resync:d9927fc6-ee80-4b6a-ba2b-f13576bd5f9b installs=0.19.846 837b14d7440b89ae8a2cec6d045483ac33659af5 -->
    Loom-Trace-Id: 76bec863c8f6aff2d49b3aa2be128619
    Loom-Build: unknown a068938e7a6c13759bcb3943e408273a3d352257 clean
    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
2026-10-07 chore: resync installed Loom surfaces
    <!-- loom:provenance v1 build=unknown 628be5bb140bcff803d159201bd61e1b868901b0 clean prompts=none sweep=none story=none trace=5a6f676b4652a1a750bbce1386c68d06 host=loom-worker-2 base=0b393055f1a42f2374e3cdeb8c2a87a64a853098 run=loom-run/v1:timer:loom-worker-2/fleet-resync:bd416e653be04ef4b13353430625e379 installs=0.19.850 3bb4bfc90603b6ad65cabca9b3eb42a59f1a9d3a -->
    Loom-Trace-Id: 5a6f676b4652a1a750bbce1386c68d06
    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
2026-10-07 chore: resync installed Loom surfaces
    <!-- loom:provenance v1 build=unknown 40215645df8a13508180b248b44244dc488bb078 clean prompts=none sweep=none story=none trace=29fde30615e6e47f39b41aa314c2c883 host=loom-worker-1 base=ea729f176e9422775f4c1c999f27e19460a4330b run=loom-run/v1:timer:loom-worker-1/fleet-resync:d1fbedfcc7824ae59233c0ea94dc4650 installs=0.19.853 2889d5ed585b4da0935543cb916381cc03b19746 -->
    Loom-Trace-Id: 29fde30615e6e47f39b41aa314c2c883
    Loom-Build: unknown 40215645df8a13508180b248b44244dc488bb078 clean
    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
2026-10-07 chore: resync installed Loom surfaces
    <!-- loom:provenance v1 build=unknown 31b34ebfd7d4539094523eaa7b56a104bebe5fc0 clean prompts=none sweep=none story=none trace=cdf49c615da3f5ce46e9fcda1a24f787 host=loom-worker-3 base=1c577b84fac6ad4a450af53034448cf78aa8964a run=loom-run/v1:timer:loom-worker-3/fleet-resync:cab31e05b8a24df09bc88f53ee3fb501 installs=0.19.857 7a0b529e6f57a79713f6924bf58d8392ff404259 -->
    Loom-Trace-Id: cdf49c615da3f5ce46e9fcda1a24f787
    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
2026-10-07 chore: resync installed Loom surfaces
    <!-- loom:provenance v1 build=unknown 4b44e7c5db0de1d2b5927de7de229120d546aad3 clean prompts=none sweep=none story=none trace=dfa656ee3483a044378501f49d36f812 host=robb-studio base=389eaaaae8a61019e3682dd6f0fd7c74c462429d run=loom-run/v1:timer:robb-studio/fleet-resync:d80d6bc0-eb68-4a07-8226-2d947d328b3a installs=0.19.859 0aefebd79aba8ab33470f1af4b96847fc794bd0d -->
    Loom-Trace-Id: dfa656ee3483a044378501f49d36f812
    Loom-Build: unknown 4b44e7c5db0de1d2b5927de7de229120d546aad3 clean
    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
2026-10-07 chore: resync installed Loom surfaces
    <!-- loom:provenance v1 build=unknown b591c8cf436f0d4aa5870a9bc7cd5f7194e0e778 dirty prompts=none sweep=none story=none trace=6eca4b0c47205457aae7a3d721c17f17 host=robb-pro base=17a5cbbd2d2508856c34f79fd8c64a4290894f07 run=loom-run/v1:timer:robb-pro/fleet-resync:64af20b3-58cb-47f2-b770-117197cb41e9 installs=0.19.864 128a7eba2bb5f7bcf8891ba284b14cb7ebf8dd3d -->
    Loom-Trace-Id: 6eca4b0c47205457aae7a3d721c17f17
    Loom-Build: unknown b591c8cf436f0d4aa5870a9bc7cd5f7194e0e778 dirty
    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
2026-10-07 chore: resync installed Loom surfaces
    <!-- loom:provenance v1 build=unknown b551219fd5b8347113c0cbc79ea416e81c39fa9d clean prompts=none sweep=none story=none trace=5ac7c8c62dad54841e21dd94f0920de3 host=loom-worker-2 base=c106f1c613f85888853287045a6185d29ebf3ae5 run=loom-run/v1:timer:loom-worker-2/fleet-resync:d10fb10789e94930ab1af368c15a8f8b installs=0.19.864 128a7eba2bb5f7bcf8891ba284b14cb7ebf8dd3d -->
    Loom-Trace-Id: 5ac7c8c62dad54841e21dd94f0920de3
    Loom-Build: unknown b551219fd5b8347113c0cbc79ea416e81c39fa9d clean
    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
2026-10-07 chore: resync installed Loom surfaces
    <!-- loom:provenance v1 build=unknown 90fbd167e4e376894396e651676cf58fc9aa223a clean prompts=none sweep=none story=none trace=196876656e912171b28029ceca9f772d host=loom-worker-1 base=539e1a59f3d4276952d5ec00125f6f6e02a9d5b3 run=loom-run/v1:timer:loom-worker-1/fleet-resync:7b46720ff3a84a8184f2f2b3bc039260 installs=0.19.868 ee904e1c151bc9cf15b0eb55dfe9d57ad6136cff -->
    Loom-Trace-Id: 196876656e912171b28029ceca9f772d
    Loom-Build: unknown 90fbd167e4e376894396e651676cf58fc9aa223a clean
    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
2026-10-08 chore: resync installed Loom surfaces
    <!-- loom:provenance v1 build=unknown 5a3df331a0612dee585ef905015af01d08e3467f clean prompts=none sweep=none story=none trace=5690fa95febe608e500a46dde8a6ee92 host=loom-worker-2 base=999f0155b4c1c0ee90103554074a507d3500d4ca run=loom-run/v1:timer:loom-worker-2/fleet-resync:5c9c35d59b704bff9d8bf096ee7ba7be installs=0.19.876 b16d54e63fbbec4d7f15f13c1f43a5e5b38145ce -->
    Loom-Trace-Id: 5690fa95febe608e500a46dde8a6ee92
    Loom-Build: unknown 5a3df331a0612dee585ef905015af01d08e3467f clean
    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
2026-10-08 chore: resync installed Loom surfaces
    <!-- loom:provenance v1 build=unknown 134eb3ff06c1a86f49a911c6c17464f55e719736 clean prompts=none sweep=none story=none trace=c7df110d490314040dcd1347b2481843 host=loom-worker-1 base=eead4c10f81752d72887404675d23411c76bfe4a run=loom-run/v1:timer:loom-worker-1/fleet-resync:53d0cec2cd61484eb9a0f8fb1f24ac5e installs=0.19.879 c15619905bdd8a24506c3853f45490d26e8f1cad -->
    Loom-Trace-Id: c7df110d490314040dcd1347b2481843
    Loom-Build: unknown 134eb3ff06c1a86f49a911c6c17464f55e719736 clean
    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
2026-10-08 chore: resync installed Loom surfaces
    <!-- loom:provenance v1 build=unknown 8f86de23319d8f6cf049557dcc9cf2e321211d9d clean prompts=none sweep=none story=none trace=17de45f778fbfd714af8afad02c96375 host=loom-worker-3 base=bded63de538716b14a63b94ce69bfc71a59ffa10 run=loom-run/v1:timer:loom-worker-3/fleet-resync:9e3e5d4a08824de3b7bc02940be2a0da installs=0.19.882 c9f85af3d967986cdd7a3f27e088a16f88712b05 -->
    Loom-Trace-Id: 17de45f778fbfd714af8afad02c96375
    Loom-Build: unknown 8f86de23319d8f6cf049557dcc9cf2e321211d9d clean
    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
2026-10-08 chore: resync installed Loom surfaces
    <!-- loom:provenance v1 build=unknown 4a5fb2b6276e17ff26ee1382acfe2ea7360ebea5 clean prompts=none sweep=none story=none trace=67857e1b7189785825a2dfc70921cf85 host=loom-worker-2 base=eb4d62422ccf1a573958c517edbfc55e0dcc7768 run=loom-run/v1:timer:loom-worker-2/fleet-resync:dd6a5f3dceff4d8d8602a07a1dc89c95 installs=0.19.892 ce93e8a919d79a6f027bab268846a52084f9d94e -->
    Loom-Trace-Id: 67857e1b7189785825a2dfc70921cf85
    Loom-Build: unknown 4a5fb2b6276e17ff26ee1382acfe2ea7360ebea5 clean
    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
2026-10-08 chore: resync installed Loom surfaces
    <!-- loom:provenance v1 build=unknown b591c8cf436f0d4aa5870a9bc7cd5f7194e0e778 dirty prompts=none sweep=none story=none trace=28e7ca5fdb768489aa38bf002407d5a5 host=robb-pro base=a7566459b7492b635fa09ca2b66b09003ce21b1d run=loom-run/v1:timer:robb-pro/fleet-resync:eb5f838e-a774-4e20-8102-c37ee3ff31ca installs=0.19.895 9b30d293bcba1e79d49cabfc1c5bb5b6f4c0dc77 -->
    Loom-Trace-Id: 28e7ca5fdb768489aa38bf002407d5a5
    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
2026-10-08 chore: resync installed Loom surfaces
    <!-- loom:provenance v1 build=unknown 5684fc8c8ac418d95ad66a002d001eaea1283c9a clean prompts=none sweep=none story=none trace=c864acd3b9a5dbb419fddd8bd2a6283b host=loom-worker-3 base=83d562d971998d82a9d42bdefae6fe4c186e09c9 run=loom-run/v1:timer:loom-worker-3/fleet-resync:4771e7c630c34445b7f28539669d76e3 installs=0.19.898 3d55b9a1669c132d130d98f10a292c1325322c30 -->
    Loom-Trace-Id: c864acd3b9a5dbb419fddd8bd2a6283b
    Loom-Build: unknown 5684fc8c8ac418d95ad66a002d001eaea1283c9a clean
    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
2026-10-08 chore: resync installed Loom surfaces
    <!-- loom:provenance v1 build=unknown 04a1189116c7320def7d9ce357d2d9268405ae92 clean prompts=none sweep=none story=none trace=8e55b27fc60ffb045554bd413ad8f3c8 host=robb-pro base=f72b363b2e8ee3af9603baa2becb7ac4906ce80d run=loom-run/v1:timer:robb-pro/fleet-resync:83b69005-7c5b-44b3-96f8-33f07bf82f4b installs=0.19.917 d3c1ea3a4c81e01ce5487dc3e4bbdd86534e677e -->
    Loom-Trace-Id: 8e55b27fc60ffb045554bd413ad8f3c8
    Loom-Build: unknown 04a1189116c7320def7d9ce357d2d9268405ae92 clean
    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
2026-10-08 feat(signoff): bind T1 items 1, 2, 9 to audited artifacts; move grader pin (#288)
    Move the klt grader pin to 3a75c3ae (klayout-tools#2843) and cite artifact-bound
    generic envelopes for items 1 (design-source inventory), 2 (layout GDS) and
    9 (testbench inventory). Item 10 stays unmet: README lacks reproduction steps
    and a spec table, and its status line is stale (tracked in #289).
    check_tier_report.py now resolves explicit provenance.input.path bindings with
    upstream semantics (no fallback to source), keeps the legacy item-8 source
    rule, and re-hashes every path+sha256 pair an inventory lists. Adds stdlib
    regression tests and runs them in the signoff CI job.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
2026-10-08 fix(signoff): name the audited base commit in the inventories and refresh pins (#288)
    Loom-Story: 2AMLogic/gf180-gate-driver#288
    Loom-Trace-Id: b4e6c1af8e2cd236d0fbea43a10a4929
    Loom-Build: 0.19.868 ee904e1c151bc9cf15b0eb55dfe9d57ad6136cff clean
2026-10-08 chore: resync installed Loom surfaces
    <!-- loom:provenance v1 build=unknown d2a55ce217b3ad1793611a2c54946676bb55b512 clean prompts=none sweep=none story=none trace=459637e4e8503593bdf58360865a7524 host=robb-pro base=a27f7f61bdadc339dc8361db57d05d4a206b0926 run=loom-run/v1:timer:robb-pro/fleet-resync:95b3cf92-9cd9-4c36-8bbd-bdcace7c3874 installs=0.19.935 d347079cd0bad2db2c11ee4f0b760f04b2601d21 -->
    Loom-Trace-Id: 459637e4e8503593bdf58360865a7524
    Loom-Build: unknown d2a55ce217b3ad1793611a2c54946676bb55b512 clean
    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
2026-10-09 docs: refresh README status, add spec table and reproduction steps; attest T1 item 10 (#289)
    Loom-Story: 2AMLogic/gf180-gate-driver#289
    Loom-Trace-Id: 98afea554d18e85b237183a2307fdcda
    Loom-Build: 0.19.950 72047016af9d66c08f900bb94c642a66dfd75fc5 clean
2026-10-09 chore: resync installed Loom surfaces
    <!-- loom:provenance v1 build=unknown 05dba463c5b293d38f0ca071725983862498b3f3 clean prompts=none sweep=none story=none trace=14298316053024bcf5120bff695771ab host=robb-pro base=567b2794e06ff0fe13ccfba3dc56512d7a545386 run=loom-run/v1:timer:robb-pro/fleet-resync:2f384483-6d77-4ba2-9888-aa1e4b5be36c installs=0.19.953 b93d7a955d63411cb4c94b986fd5138d27dedb0f -->
    Loom-Trace-Id: 14298316053024bcf5120bff695771ab
    Loom-Build: unknown 05dba463c5b293d38f0ca071725983862498b3f3 clean
    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
2026-10-09 chore: resync installed Loom surfaces
    <!-- loom:provenance v1 build=unknown 7f06b288b150f2fe0a4b24c331a9b3ec093d709d clean prompts=none sweep=none story=none trace=a90c217ff3a3bd9e3a30282b8cadc24d host=robb-pro base=b94b73187b26e1508c6f967a70f1755491f23909 run=loom-run/v1:timer:robb-pro/fleet-resync:6e5ec9f3-d6ef-4953-80f7-c93035e2d359 installs=0.19.966 9bed656320e53ba6c64305daa60613431a7ed02d -->
    Loom-Trace-Id: a90c217ff3a3bd9e3a30282b8cadc24d
    Loom-Build: unknown 7f06b288b150f2fe0a4b24c331a9b3ec093d709d clean
    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
2026-10-09 chore: resync installed Loom surfaces
    <!-- loom:provenance v1 build=unknown 30c7a7ee2f74a6a2b5bb0f19fd9f049ec8ae8b5c clean prompts=none sweep=none story=none trace=7bc5ba399ff199d049d83d711920a157 host=robb-pro base=02a6aa785a3fb79a6004fcd05422bb5bf19d9595 run=loom-run/v1:timer:robb-pro/fleet-resync:8e237160-c4d0-4ce3-85ac-c96aff5cf221 installs=0.19.982 2bc4cba624b9053535663441e6f0daf08a7acf2e -->
    Loom-Trace-Id: 7bc5ba399ff199d049d83d711920a157
    Loom-Build: unknown 30c7a7ee2f74a6a2b5bb0f19fd9f049ec8ae8b5c clean
    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
2026-10-10 chore: resync installed Loom surfaces
    <!-- loom:provenance v1 build=unknown 03c1cb521a10d5101bd8aa2c52a47cebfb0e795b clean prompts=none sweep=none story=none trace=09ccab293fce5c1a7b4aa907c7197bec host=robb-studio base=8ded79c83de3a952c7a7ebc964d8b4d1b9947b2e run=loom-run/v1:timer:robb-studio/fleet-resync:ed2be6c5-20fe-4228-a206-940d35a4858f installs=0.19.996 0d2be7e9ae05753e2c9232a83b7399d45de5396e -->
    Loom-Trace-Id: 09ccab293fce5c1a7b4aa907c7197bec
    Loom-Build: unknown 03c1cb521a10d5101bd8aa2c52a47cebfb0e795b clean
    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
2026-10-10 chore: resync installed Loom surfaces
    <!-- loom:provenance v1 build=unknown a7d2b01d8eb7d09e597a4638e5cb3cdd8bab9156 clean prompts=none sweep=none story=none trace=35c1337ee84607e87ba2038523d63198 host=robb-pro base=d013ee5c49e8aa8ae58f72650e3568eeb48c43ac run=loom-run/v1:timer:robb-pro/fleet-resync:6bf32a81-6c4a-48c5-a51e-1ad65c6bedfd installs=0.19.999 20513e3064fa3a7c4b3f1c641d97a00446e9ba78 -->
    Loom-Trace-Id: 35c1337ee84607e87ba2038523d63198
    Loom-Build: unknown a7d2b01d8eb7d09e597a4638e5cb3cdd8bab9156 clean
    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
2026-10-10 chore: resync installed Loom surfaces
    <!-- loom:provenance v1 build=unknown c156f673e072832aaacb4cd1ec65b742e7f45867 clean prompts=none sweep=none story=none trace=9de99c124c651049199abe9a75070dc7 host=robb-pro base=5904f3bc5df3e592f1271bfa91c4799210ca25ac run=loom-run/v1:timer:robb-pro/fleet-resync:f790885c-7154-4b3d-acd9-71fd537cd20b installs=0.19.1010 d1d5fcecb79550fe39658555a4419f98cec060fb -->
    Loom-Trace-Id: 9de99c124c651049199abe9a75070dc7
    Loom-Build: unknown c156f673e072832aaacb4cd1ec65b742e7f45867 clean
    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
2026-10-10 chore: resync installed Loom surfaces
    <!-- loom:provenance v1 build=unknown 52f79668bb5f93c1828b7f1ea4f7013b917b847b clean prompts=none sweep=none story=none trace=7057f3175071f1f6e34b354fab40a0ce host=robb-studio base=24251734f1676ab2f07d550462553b7260a94d06 run=loom-run/v1:timer:robb-studio/fleet-resync:d8918779-1625-4202-b151-71f64465e8cd installs=0.19.1010 d1d5fcecb79550fe39658555a4419f98cec060fb -->
    Loom-Trace-Id: 7057f3175071f1f6e34b354fab40a0ce
    Loom-Build: unknown 52f79668bb5f93c1828b7f1ea4f7013b917b847b clean
    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
2026-10-10 chore: resync installed Loom surfaces
    <!-- loom:provenance v1 build=unknown 525fe43b7b1b2a0271084bba444c934a1541a8d8 clean prompts=none sweep=none story=none trace=0d4424bd058cf912b74934ec0e7bf37e host=robb-pro base=de04e1bd1d4d3a81df306ce27fc2808e7b84eb8c run=loom-run/v1:timer:robb-pro/fleet-resync:4812047c-8b9b-4da2-a5dc-13e6f6420a04 installs=0.19.1018 13e54f1cfc513507a7ef84ec6908085638d9c187 -->
    Loom-Trace-Id: 0d4424bd058cf912b74934ec0e7bf37e
    Loom-Build: unknown 525fe43b7b1b2a0271084bba444c934a1541a8d8 clean
    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
2026-10-10 chore: resync installed Loom surfaces
    <!-- loom:provenance v1 build=unknown 525fe43b7b1b2a0271084bba444c934a1541a8d8 clean prompts=none sweep=none story=none trace=d4059def94f46d8d158946acddd4d602 host=robb-studio base=19e5d185b305ee7f0d120ce13efb5d4a3a8fc566 run=loom-run/v1:timer:robb-studio/fleet-resync:4a4d1995-968e-44c5-b5fe-804b4d477795 installs=0.19.1019 febfc4335d0554865fadbecba718245cd88c6678 -->
    Loom-Trace-Id: d4059def94f46d8d158946acddd4d602
    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
2026-10-10 chore: resync installed Loom surfaces
    <!-- loom:provenance v1 build=unknown 5d5f41d89eef35adf478b92b96af06c6d86d27a6 clean prompts=none sweep=none story=none trace=05d2a40831b35ba1c48afada00c29519 host=robb-pro base=849f0bcdbf2a46a6e0b45356d2ca0650b18304e1 run=loom-run/v1:timer:robb-pro/fleet-resync:c58bb82e-a213-439d-b829-04234e141de9 installs=0.19.1027 59bb53f01eb99187ce25f22be1a64da5c877d115 -->
    Loom-Trace-Id: 05d2a40831b35ba1c48afada00c29519
    Loom-Build: unknown 5d5f41d89eef35adf478b92b96af06c6d86d27a6 clean
    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
2026-10-10 chore: resync installed Loom surfaces
    <!-- loom:provenance v1 build=unknown aa536103d6239818bb974a51d2f7f268eff38bad clean prompts=none sweep=none story=none trace=126a1328a3664e2119a0978086db9bea host=robb-studio base=f262ed30d4121d409f43165267e46dd208d1dd13 run=loom-run/v1:timer:robb-studio/fleet-resync:fbc4e361-e290-4d81-ae3a-8b5fde796815 installs=0.19.1031 286d609f09342e7c84f2e23771edbac5b1914659 -->
    Loom-Trace-Id: 126a1328a3664e2119a0978086db9bea
    Loom-Build: unknown aa536103d6239818bb974a51d2f7f268eff38bad clean
    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
2026-10-11 chore: resync installed Loom surfaces
    <!-- loom:provenance v1 build=unknown cf08873555e2eb95da295dcbee98b0dc34473381 clean prompts=none sweep=none story=none trace=67fbc483c3ca3e442d7928804c11ff06 host=robb-pro base=6ba034b63b82386a9227124c86bdcbf88c3d0942 run=loom-run/v1:timer:robb-pro/fleet-resync:e3f97888-2b26-404a-bd47-86fd28a4eced installs=0.19.1041 b65c266b47d796bf37d1c04c6f616be0bc699056 -->
    Loom-Trace-Id: 67fbc483c3ca3e442d7928804c11ff06
    Loom-Build: unknown cf08873555e2eb95da295dcbee98b0dc34473381 clean
    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
2026-10-11 chore: resync installed Loom surfaces
    <!-- loom:provenance v1 build=unknown e91831edf7b55b29d3a2d88e266916fab9ce2563 clean prompts=none sweep=none story=none trace=f72dd67520a2c3802aa0495b80ac65a5 host=robb-studio base=08d4f1e9f55139c2b9cbd0f1c5404c251c403e6e run=loom-run/v1:timer:robb-studio/fleet-resync:91d2434e-eae5-45de-9305-d78c43fc7c7a installs=0.19.1042 5b6ebdcc40bfccc9357e15196984061f1d5e6178 -->
    Loom-Trace-Id: f72dd67520a2c3802aa0495b80ac65a5
    Loom-Build: unknown e91831edf7b55b29d3a2d88e266916fab9ce2563 clean
    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
2026-10-11 chore: resync installed Loom surfaces
    <!-- loom:provenance v1 build=unknown 5ec729b9f7dd55a2082752611e4c4964f49661fb clean prompts=none sweep=none story=none trace=efc2abc8b72538df6d1a6ea9d329603d host=robb-pro base=6097a5fc06b8d0239392f805e57852da4e82ac46 run=loom-run/v1:timer:robb-pro/fleet-resync:0d396c06-f26e-423e-97ac-6d3ac04a8e51 installs=0.19.1054 f6a73bc7fc942d7b297514b2e3f57a0ca2076010 -->
    Loom-Trace-Id: efc2abc8b72538df6d1a6ea9d329603d
    Loom-Build: unknown 5ec729b9f7dd55a2082752611e4c4964f49661fb clean
    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
2026-10-11 chore: resync installed Loom surfaces
    <!-- loom:provenance v1 build=unknown 745f69d0daad6c23e76cc006720fa4fbeaa3d887 clean prompts=none sweep=none story=none trace=3baabc4a039fd85029fff227a6ae690a host=robb-studio base=54b0b918a9b761d57ef21a1164615b243979c811 run=loom-run/v1:timer:robb-studio/fleet-resync:3b3207d7-055d-49b5-a387-db375213668d installs=0.19.1058 00ceead491dd1ae20db00db16a650ea43dd0c09b -->
    Loom-Trace-Id: 3baabc4a039fd85029fff227a6ae690a
    Loom-Build: unknown 745f69d0daad6c23e76cc006720fa4fbeaa3d887 clean
    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
2026-10-11 chore: resync installed Loom surfaces
    <!-- loom:provenance v1 build=unknown b37a005ac1889262fb9e5338f7cff4e9ed4987da clean prompts=none sweep=none story=none trace=25c158d7e9591610b251780caaff1c5f host=robb-pro base=cc324f5e050a235c7e0019851774d5ef134523cf run=loom-run/v1:timer:robb-pro/fleet-resync:7f020bca-6920-47f7-a5e4-bbd5c82d9bb8 installs=0.19.1072 29b48db1ead9c4501304e0114a5c33310e1d589f -->
    Loom-Trace-Id: 25c158d7e9591610b251780caaff1c5f
    Loom-Build: unknown b37a005ac1889262fb9e5338f7cff4e9ed4987da clean
    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
2026-10-11 chore: resync installed Loom surfaces
    <!-- loom:provenance v1 build=unknown 81a6b4499cb57b3620785bc1625c300da34f0735 clean prompts=none sweep=none story=none trace=d08bbd290651d7bcbda8b216c0dfbcdf host=robb-studio base=dc4534a91a78f8fd02bc13181189399d4f573b32 run=loom-run/v1:timer:robb-studio/fleet-resync:71e05e3d-931c-46b4-b6d2-5f3f992c1e19 installs=0.19.1073 abb0872ba7d1d3f6f3a14f71f51a562e89308181 -->
    Loom-Trace-Id: d08bbd290651d7bcbda8b216c0dfbcdf
    Loom-Build: unknown 81a6b4499cb57b3620785bc1625c300da34f0735 clean
    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
2026-10-12 chore: resync installed Loom surfaces
    <!-- loom:provenance v1 build=unknown ddfb67ccf9a5115d62dd86924613a468b9328f44 clean prompts=none sweep=none story=none trace=772605234b9d8cafd6a4049200f7425c host=robb-pro base=8ae3731c248753f7e05309ea4de68c77c30536f3 run=loom-run/v1:timer:robb-pro/fleet-resync:1ef28ffc-0277-424f-9224-7ee6eca46377 installs=0.19.1081 be16cedf6a394661d3b1400531335927f5eb4519 -->
    Loom-Trace-Id: 772605234b9d8cafd6a4049200f7425c
    Loom-Build: unknown ddfb67ccf9a5115d62dd86924613a468b9328f44 clean
    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
2026-10-12 chore: resync installed Loom surfaces
    <!-- loom:provenance v1 build=unknown be358990895362019614bd207bcbe36bc9eeff2c clean prompts=none sweep=none story=none trace=f1dc643b95859c8f26e892ddb5e2c5d7 host=robb-studio base=75cdcf76d2471e4cc03f1aa2e84056357248dc36 run=loom-run/v1:timer:robb-studio/fleet-resync:da486ca2-3e94-4a85-abd3-88707942489a installs=0.19.1086 d8cb20101a985145fb167c1933758075a14ce1ab -->
    Loom-Trace-Id: f1dc643b95859c8f26e892ddb5e2c5d7
    Loom-Build: unknown be358990895362019614bd207bcbe36bc9eeff2c clean
    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
2026-10-12 chore: resync installed Loom surfaces
    <!-- loom:provenance v1 build=unknown a579728c137cc11d08a48b178e0ff9aa21683e72 clean prompts=none sweep=none story=none trace=10832f2750dbcd63f6c6f301a6f4da9b host=loom-worker-2 base=f0a8588b11258fc26613d782feb547ad902ac73d run=loom-run/v1:timer:loom-worker-2/fleet-resync:180f6d5054f0479ab3990b86ab4522a5 installs=0.19.1087 51ac271f990b317a52ebf27cc21f34561e1179fb -->
    Loom-Trace-Id: 10832f2750dbcd63f6c6f301a6f4da9b
    Loom-Build: unknown a579728c137cc11d08a48b178e0ff9aa21683e72 clean
    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
2026-10-12 chore: resync installed Loom surfaces
    <!-- loom:provenance v1 build=unknown 02ecafe7734bf5faa945ce88940589f00eca78e9 clean prompts=none sweep=none story=none trace=5f71c537126994dc4c45179122427514 host=robb-pro base=b77a4a33dd6b457d01dcc411d48559f1a8ff76b1 run=loom-run/v1:timer:robb-pro/fleet-resync:6293e6da-8a67-45aa-b277-c9ef85ddb810 installs=0.19.1101 27422582cd2d34d8ed5f60ce987007bc4bd61081 -->
    Loom-Trace-Id: 5f71c537126994dc4c45179122427514
    Loom-Build: unknown 02ecafe7734bf5faa945ce88940589f00eca78e9 clean
    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
2026-10-12 chore: resync installed Loom surfaces
    <!-- loom:provenance v1 build=unknown 5918da96dcd60c9a677a195737c86ea38972d215 clean prompts=none sweep=none story=none trace=49bb7a8942d6a23bf41754ca27ff2368 host=loom-worker-2 base=324722c576cfe2bf164f7cecc60b3d0a67727487 run=loom-run/v1:timer:loom-worker-2/fleet-resync:2e973f04abd1447d8ee4b696c2e7d2b4 installs=0.19.1105 e2b4f1275335364979ea8d4f1364e7a9c30cf3f3 -->
    Loom-Trace-Id: 49bb7a8942d6a23bf41754ca27ff2368
    Loom-Build: unknown 5918da96dcd60c9a677a195737c86ea38972d215 clean
    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
2026-10-12 chore: resync installed Loom surfaces
    <!-- loom:provenance v1 build=unknown 9885e6bbba36f53328e04be83140734c6eda9f58 clean prompts=none sweep=none story=none trace=72f34c4066d6ca844a10c33035a775bd host=loom-worker-1 base=f8d6f632a24bffef3422d6cfb68b6b8b222d0233 run=loom-run/v1:timer:loom-worker-1/fleet-resync:8f5732bc51fd43379e17e0de51e86bae installs=0.19.1108 72427939d156341080a7006ae6fbb5ec96b2368e -->
    Loom-Trace-Id: 72f34c4066d6ca844a10c33035a775bd
    Loom-Build: unknown 9885e6bbba36f53328e04be83140734c6eda9f58 clean
    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
2026-10-12 chore: resync installed Loom surfaces
    <!-- loom:provenance v1 build=unknown 01467247f32c59822968bf02d3214d9a3d613452 clean prompts=none sweep=none story=none trace=0e97e9733eef09a33959cf96e6271f40 host=robb-studio base=c09e5c098ce3b36794f7ff6a4d6e2a8ed6870b81 run=loom-run/v1:timer:robb-studio/fleet-resync:53a4d390-3842-4216-9018-5dced9d0ea17 installs=0.19.1109 d9498fcd419776b2517e30b99c88e76bbe92d2f4 -->
    Loom-Trace-Id: 0e97e9733eef09a33959cf96e6271f40
    Loom-Build: unknown 01467247f32c59822968bf02d3214d9a3d613452 clean
    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
2026-10-12 chore: resync installed Loom surfaces
    <!-- loom:provenance v1 build=unknown acadc2b4b0e852f2d889ac9dec616e1548705802 clean prompts=none sweep=none story=none trace=a69edb348af7f0e67b3bc77bc33b1bfc host=loom-worker-2 base=ea61381e7ef493f72a45f9fd7d1e17bf069b497b run=loom-run/v1:timer:loom-worker-2/fleet-resync:0923627ffda84cf69ec2486475772b10 installs=0.19.1126 7736d1276b6d01778fba3461114c858ef1bf5e2d -->
    Loom-Trace-Id: a69edb348af7f0e67b3bc77bc33b1bfc
    Loom-Build: unknown acadc2b4b0e852f2d889ac9dec616e1548705802 clean
    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
2026-10-12 chore: resync installed Loom surfaces
    <!-- loom:provenance v1 build=unknown 8d832cc8035d4ba07872510416468da0790332cd clean prompts=none sweep=none story=none trace=09a53bf60e96fc30a753caffd1de8c92 host=robb-studio base=d9a97904bb2209c8333d648a0d1ed59a5267bb38 run=loom-run/v1:timer:robb-studio/fleet-resync:baf4c30c-65d9-4d4e-a740-f6a80cbb975c installs=0.19.1132 8695bdd2b7b963dca9b76f4643a9d7c744294426 -->
    Loom-Trace-Id: 09a53bf60e96fc30a753caffd1de8c92
    Loom-Build: unknown 8d832cc8035d4ba07872510416468da0790332cd clean
    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
2026-10-12 chore: resync installed Loom surfaces
    <!-- loom:provenance v1 build=unknown aa1ed0d7d5499d2705977d971673d919dbbbaf4e clean prompts=none sweep=none story=none trace=2522608826ef5d5e4a88a9667055aeb7 host=loom-worker-2 base=f4f3addfe2a595ccdf02531d36575dda862a0411 run=loom-run/v1:timer:loom-worker-2/fleet-resync:8f26b719c712455381744111c50e90b4 installs=0.19.1142 b91ae5d1b5204f499a1abb875a6cf5bffc1d90b1 -->
    Loom-Trace-Id: 2522608826ef5d5e4a88a9667055aeb7
    Loom-Build: unknown aa1ed0d7d5499d2705977d971673d919dbbbaf4e clean
    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
2026-10-12 chore: resync installed Loom surfaces
    <!-- loom:provenance v1 build=unknown 8b64614d017d6ce7491c3a2ac9da51e5e2901c97 clean prompts=none sweep=none story=none trace=66044c049ba635bcd6a4797c3a77e84b host=robb-pro base=83bf97a80ab31b2ea8ced0bf88cebf521b4bf779 run=loom-run/v1:timer:robb-pro/fleet-resync:68f56594-05d0-4cc0-9c07-36263359d698 installs=0.19.1144 9e4381cbbd2386393e44c7a979583252948a3998 -->
    Loom-Trace-Id: 66044c049ba635bcd6a4797c3a77e84b
    Loom-Build: unknown 8b64614d017d6ce7491c3a2ac9da51e5e2901c97 clean
    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
2026-10-13 chore: resync installed Loom surfaces
    <!-- loom:provenance v1 build=unknown 98d08ab78cc223361354ee9947d996b1cb914b30 clean prompts=none sweep=none story=none trace=8b73addcdeaa8fbd65998649f42a8c50 host=loom-worker-2 base=73ea087c0e0d67574234e006f9aef3bcd7d87532 run=loom-run/v1:timer:loom-worker-2/fleet-resync:3bfb13d52fca425f9cfced4541954cb6 installs=0.19.1148 1448fdfa79ac2dcab7fad6b95b72697b450f2a4a -->
    Loom-Trace-Id: 8b73addcdeaa8fbd65998649f42a8c50
    Loom-Build: unknown 98d08ab78cc223361354ee9947d996b1cb914b30 clean
    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
2026-10-13 chore: resync installed Loom surfaces
    <!-- loom:provenance v1 build=unknown d0bfbbc7ac309581d7abe02c4a269c7704010ee0 clean prompts=none sweep=none story=none trace=0ad6d167235000f3b5648cbd63d761ce host=robb-pro base=1949e8a20d65cf1f163286d5f98d267de773681e run=loom-run/v1:timer:robb-pro/fleet-resync:4f7cbe22-40b6-49ff-8811-003ae8577c28 installs=0.19.1151 08ee0f8708464aa8e0768640d56955d7f4fcbc98 -->
    Loom-Trace-Id: 0ad6d167235000f3b5648cbd63d761ce
    Loom-Build: unknown d0bfbbc7ac309581d7abe02c4a269c7704010ee0 clean
    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
2026-10-13 chore: resync installed Loom surfaces
    <!-- loom:provenance v1 build=unknown 7916c4043a1b57e97a53bc5c111e74c5038a1091 clean prompts=none sweep=none story=none trace=20b27ffb08c4130dc9836ee8d9d97b97 host=loom-worker-2 base=ec03fe2411d606b8e27273321a24d0c9050b0d41 run=loom-run/v1:timer:loom-worker-2/fleet-resync:d34532ec625a4162ae8b58dde1a6738f installs=0.19.1151 f7d1deaab02a9c483fce1ced33fadb1af6d86f59 -->
    Loom-Trace-Id: 20b27ffb08c4130dc9836ee8d9d97b97
    Loom-Build: unknown 7916c4043a1b57e97a53bc5c111e74c5038a1091 clean
    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
2026-10-13 chore: resync installed Loom surfaces
    <!-- loom:provenance v1 build=unknown ac0bbcf6eda99918e88a0b8893d9762b106a2e45 clean prompts=none sweep=none story=none trace=8597ab8a51d68f9f8ee864fa71904bff host=robb-studio base=f868d163575ab5e615149fb73addb63845fdc394 run=loom-run/v1:timer:robb-studio/fleet-resync:2ea9dd71-a6b2-4d0c-86aa-859a0728c9b3 installs=0.19.1151 f7d1deaab02a9c483fce1ced33fadb1af6d86f59 -->
    Loom-Trace-Id: 8597ab8a51d68f9f8ee864fa71904bff
    Loom-Build: unknown ac0bbcf6eda99918e88a0b8893d9762b106a2e45 clean
    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
2026-10-13 chore: resync installed Loom surfaces
    <!-- loom:provenance v1 build=unknown 7916c4043a1b57e97a53bc5c111e74c5038a1091 clean prompts=none sweep=none story=none trace=a48d70df8e7252b46c71b88e90ebed02 host=loom-worker-3 base=5dc2c489a7c42895e126d4004f33a919e7378d84 run=loom-run/v1:timer:loom-worker-3/fleet-resync:08e4e415b6434bf1ba0456ba59477467 installs=0.19.1151 f7d1deaab02a9c483fce1ced33fadb1af6d86f59 -->
    Loom-Trace-Id: a48d70df8e7252b46c71b88e90ebed02
    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
2026-10-13 chore: resync installed Loom surfaces
    <!-- loom:provenance v1 build=unknown 7916c4043a1b57e97a53bc5c111e74c5038a1091 clean prompts=none sweep=none story=none trace=773e9e41a5730d2f79f2381ad2cde068 host=robb-pro base=eec470dd42fe788b43a150bdb08afd386bc4ac34 run=loom-run/v1:timer:robb-pro/fleet-resync:b7ca0d34-434e-4536-85b9-57adfa603a8d installs=0.19.1151 a885af872d054695b81e8458dfc7bd717cbddba8 -->
    Loom-Trace-Id: 773e9e41a5730d2f79f2381ad2cde068
    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
2026-10-13 chore: resync installed Loom surfaces
    <!-- loom:provenance v1 build=unknown f57244868aa20ef22c18aa8025972184aaea43e4 clean prompts=none sweep=none story=none trace=8e03b78fe6cb43a017c4a4823362ffa7 host=loom-worker-2 base=04b80bc9ae44c237c4706dd848d3b93b63c017dc run=loom-run/v1:timer:loom-worker-2/fleet-resync:eb553d2fc2a54589aa37879f12b18ed5 installs=0.19.1151 4b3b3e77e5ef42971b3c0c3e68c000736a0c7c21 -->
    Loom-Trace-Id: 8e03b78fe6cb43a017c4a4823362ffa7
    Loom-Build: unknown f57244868aa20ef22c18aa8025972184aaea43e4 clean
    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
2026-10-13 chore: resync installed Loom surfaces
    <!-- loom:provenance v1 build=unknown 9cd23bf22bf48ed3837f643ea76ec2e5f01ae46a clean prompts=none sweep=none story=none trace=ab3a71ce89f6ba9ad4c2753c3377bcf1 host=loom-worker-1 base=9b41970d65d8f0b761d45a13515adbc14d470893 run=loom-run/v1:timer:loom-worker-1/fleet-resync:79a3b089c6f54c91bd32db3274e8133c installs=0.19.1151 a9d9bfc13e966655d6d847cb6876af523bc4a4c4 -->
    Loom-Trace-Id: ab3a71ce89f6ba9ad4c2753c3377bcf1
    Loom-Build: unknown 9cd23bf22bf48ed3837f643ea76ec2e5f01ae46a clean
    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
2026-10-13 chore: resync installed Loom surfaces
    <!-- loom:provenance v1 build=unknown 6fe43c87955e02019c2bc8dfad4fbd160b89170c clean prompts=none sweep=none story=none trace=49a4590bf54e81899c26d965f682504c host=robb-studio base=8781517a92f5c05ae25bef1106a2b355207d9a65 run=loom-run/v1:timer:robb-studio/fleet-resync:459197b3-0050-4335-893e-e47b638eb819 installs=0.19.1151 4ec7e046f71ff70b92c88ed647cff72d6a9d1e85 -->
    Loom-Trace-Id: 49a4590bf54e81899c26d965f682504c
    Loom-Build: unknown 6fe43c87955e02019c2bc8dfad4fbd160b89170c clean
    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
2026-10-13 chore: resync installed Loom surfaces
    <!-- loom:provenance v1 build=unknown 5dc3a07d084d0ec4034f0782d572925dcad86af7 clean prompts=none sweep=none story=none trace=cbc11657acadf58858409fe543c342e1 host=robb-pro base=7d3432093043bfb221f14af14a718d26c94668f4 run=loom-run/v1:timer:robb-pro/fleet-resync:be586137-d91e-4e2c-82d6-3164d43aa9de installs=0.19.1152 2d5fe17958dca799058f16bdd74a12336990bec0 -->
    Loom-Trace-Id: cbc11657acadf58858409fe543c342e1
    Loom-Build: unknown 5dc3a07d084d0ec4034f0782d572925dcad86af7 clean
    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
2026-10-13 chore: resync installed Loom surfaces
    <!-- loom:provenance v1 build=unknown 27a266d5a27885323290840d2a837d73fcf4bcc6 clean prompts=none sweep=none story=none trace=e77cdd5477ef6bfc65fba6cc233788e0 host=loom-worker-2 base=1d50798281465ae4eeb26d0ee7ce2adb6872d6b5 run=loom-run/v1:timer:loom-worker-2/fleet-resync:7fac7d82f298441a91761382ac989183 installs=0.19.1152 43f03f1fe0988c7870431d6bba187c13018b4420 -->
    Loom-Trace-Id: e77cdd5477ef6bfc65fba6cc233788e0
    Loom-Build: unknown 27a266d5a27885323290840d2a837d73fcf4bcc6 clean
    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
2026-10-13 chore: resync installed Loom surfaces
    <!-- loom:provenance v1 build=unknown f2b62a2cf576d7d37092147b2281da809f8b5cf5 clean prompts=none sweep=none story=none trace=8adfa75521c72dded43e2932febb6329 host=loom-worker-3 base=4ed6e6873d5ffb846e45e13901123ca6923a10d7 run=loom-run/v1:timer:loom-worker-3/fleet-resync:8a8198f8f80e4703bc7365a5e10595e0 installs=0.19.1152 8d16eec5f10d705602ac4d1ab871c57266f1aa45 -->
    Loom-Trace-Id: 8adfa75521c72dded43e2932febb6329
    Loom-Build: unknown f2b62a2cf576d7d37092147b2281da809f8b5cf5 clean
    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
2026-10-13 chore: resync installed Loom surfaces
    <!-- loom:provenance v1 build=unknown 84d11f248d368cae5e04a2255f6897a406c50089 clean prompts=none sweep=none story=none trace=8e50b4ccc3dc58f709a732f69d58fd44 host=robb-studio base=c0ea01af36ffe61efd68c024ddc1715b2225fcc2 run=loom-run/v1:timer:robb-studio/fleet-resync:05c9f3b1-eee2-412f-8996-5fbf02793d9e installs=0.19.1153 d8429a4fabdc955107af1cbc22c548e23eecf9b1 -->
    Loom-Trace-Id: 8e50b4ccc3dc58f709a732f69d58fd44
    Loom-Build: unknown 84d11f248d368cae5e04a2255f6897a406c50089 clean
    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
2026-10-15 Bump Repo Skills 0.19.5 -> 0.24.1
    Repo Skills is committed in each repo, so the fleet's version spread only
    closes through a PR per repo (2am#4508). This is that PR for gf180-gate-driver, produced
    by scripts/repo-skills-rollout.py running the Repo Skills installer over the
    repo. Merge it with a merge commit like any other change.
2026-10-16 Bump Repo Skills 0.24.1 -> 0.24.3
    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
2026-10-21 Bump Repo Skills 0.24.3 -> 0.24.7
    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
2026-10-21 refactor(sim): share fmt/parse_dc_tables/column across experiment scripts
    Move byte-identical helpers from four sim/*/run_*.py scripts into
    sim/harness/script_helpers.py (fmt keeps 4 digits) and pin them with a test.
    Part of #309
2026-10-21 refactor: hoist mismatch campaign main() into campaign.run_mismatch_main
    The indrv, taper and inb campaign scripts carried near-identical 115-128
    line main() drivers; the shared flow now lives in one helper driven by
    per-campaign hooks (smoke corner, progress detail, worst-sample selector,
    optional testbench alias and baseline note). The device-point variant
    (ronw) is left as is.
2026-10-22 docs: state that power_array_folded is kept on purpose for future power-stage growth
2026-10-22 chore(signoff): refresh repo-hygiene inventory for layout/README.md edit
    Re-hashed layout/README.md in the T1 item 10 inventory and propagated the new
    inventory hash through its envelope, the manifest pin and tier-report.json.
2026-10-23 feat(sim): store new sim evidence through the artifact store, commit manifests only
    Stage a run's netlist snapshot, per-corner logs and sample sidecars in
    git-ignored scratch, put them with klt artifact put, and commit only the
    manifest and the Markdown record. Fail closed when the broker, klt verb or
    klt version is missing. evidence_lint treats manifest-backed records as
    having their snapshot/logs, and CI validates manifests (artifact: uris only,
    no committed duplicates of stored bytes).
2026-10-23 fix(signoff): re-audit item 10 inventory after ci.yml and sim/README.md changes
    Refresh the sha256 listings for .github/workflows/ci.yml and sim/README.md in
    repo-hygiene.inventory.md, record the re-audit, and cascade the new inventory
    hash through the item 10 envelope pin, manifest.json and tier-report.json
    (re-rendered with the CI-pinned klt 3a75c3ae). Fixes the red signoff job on
    CommittedTree.test_committed_manifest_is_anchored.
    Part of #333
2026-10-24 refactor(sim): hoist shared mismatch record-body sections into harness campaign
    The three mismatch runners each carried a copy-pasted record-body
    composer. Move the shared sections (PVT axes, dropped-draw note,
    seed/negative-control convention, control table, non-converged draws,
    verdict, links, trailer) into campaign.py and pin the generated markdown
    byte-for-byte with goldens captured before the change.
    Closes #344
2026-10-24 refactor(sim): remove unused device_write_record helper
2026-10-24 fix: count resistor cards in LVS negative-control reference device total
    The control's expected count covered M and C cards only, while klt's
    counts.devices.reference also includes R cards, so the assertion failed
    on a correct comparator verdict. Widen the card regex to [MCR].
2026-10-24 docs: scope the DRC-clean claim; triage 1513 violations under the current deck
    All 7 failing rules are real layout violations (resistor SAB geometry, tap
    implant enclosure, missing S/D implants); deck and spec unchanged. Layout fix
    tracked in #362. Inventory hashes repinned.
    Part of #358
2026-10-24 fix(layout): regenerate gate_driver_core DRC-clean under the 34-layer deck
    Regenerating with the current klt clears the SAB and COMP-coverage
    violations (klt gen now emits them), but also adds contacted body taps to
    every mos_array cell. Fix the remaining tap-implant enclosure and the
    interactions with those taps, all in the generator:
    - tap and guard-ring implants enclose their Comp by 0.16 um; tap offset
    0.6 -> 0.8 um to keep implant spacing
    - gate route goes up on Metal2 where it would cross a cell-own tap pad
    (it shorted the gate onto the well/substrate tie)
    - nfet corner tap pads are strapped to the body net (klt erc
    substrate_gnd_logic); close same-rail via landings are bridged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
2026-10-27 feat(signoff): cite Monte Carlo mismatch campaigns as klt yield evidence for T1 item 6
    Convert the committed samples-*.csv of three mismatch campaigns into
    klt yield sample sets (sim/mc_to_yield.py), commit the graded reports,
    cite them in the signoff manifest with a declared gap for the Ron*W row,
    anchor yield reports in check_tier_report.py and move the CI grader pin.
2026-10-27 feat(signoff): cite klt sim corner envelopes for T1 item 5
    Re-run the ratified spec Sec.3 rows through klt sim on the batch fleet
    (45-point +/-10 % tied-rail matrix at target bounds, 15-point 6 V stretch
    rail at stretch bounds), commit the envelopes, declare spec_rows for item 5,
    move the CI grader pin so the multi-envelope form grades, and teach
    check_tier_report.py to anchor sim envelopes (body netlist + netlist_closure).
    Item 5 renders unmet/check_failed: DR-0016/DR-0020 corners fail by design.
2026-10-28 docs: draft Ron·W statistical-row decision record 0021 and fix item 5-7 drift
    Draft (unratified) record proposing a per-PVT excursion bound and 0.98 yield
    target for the nfet_06v0 Ron·W row of T1 item 6, with a stdlib script that
    reproduces the derivation from the committed samples. README and signoff
    README now describe items 5-7 as the report grades them; the item-10
    inventory, envelope, manifest pin and tier-report are refreshed accordingly.
2026-10-29 docs: define key non-author check as session separation, not GitHub identity
    The EE and market key SKILL.md files told a key to stop if the PR author
    was the same identity running the review. On the fleet every agent posts
    as one login, so that check could never pass. Reword to the operator
    ruling: a fresh session that did not author the work, verdict posted as
    an ordinary comment naming its run id.
    Part of #388
    Loom-Issue: 2AMLogic/gf180-gate-driver#388
2026-10-29 docs(decision-records): ratify 0021, Ron·W as a statistical row for item 6
    The operator ratified 0021 as drafted on 2026-10-29 (Robb, attended
    fleet:decide q133, option 1 of #379). The ruling chose to ratify directly,
    without first running the EE and market key reviews.
    Under 0021, Ron·W of nfet_06v0 at Vgs = 3.6 V is graded at each PVT point
    against that point's own control plus 5 % of the §2.1 window (+0.13432
    Ohm*mm), with a 0.98 yield target at 95 % confidence. The committed campaign
    of 3000 draws shows 0 failures; the worst excursion is 20.9 % of the
    allowance. The follow-up on #379 updates spec_rows."6" to a graded klt yield
    citation and re-renders tier-report.json.
    Co-Authored-By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
2026-10-29 feat: grade Ron*W per-PVT bound with klt yield, closing item 6 gap
    Add the 15 per-PVT ronw_n06_3.6 samples (control + 0.13432 ohm*mm, target
    0.98) and their klt yield report, pin them in the manifest, drop the
    ronw_nfet_06v0 gap, re-render tier-report.json (item 6 met), refresh the
    item 10 inventory hash and update the signoff docs.
    Closes #379
2026-10-30 docs: regenerate WORK_PLAN from current labels (drop duplicate/mislabelled #388)
2026-10-30 feat: record klt pex post-layout report and cite it as T1 item 7
    Run the #367 request set through klt pex over layout/gate_driver_core.gds
    (60 corners, both legs on the batch fleet), commit the report append-only,
    cite it in the signoff manifest, re-render tier-report.json, and extend the
    tier-report checker to anchor pex reports. Item 7 renders check_failed; the
    failing rows are listed in verification/signoff/README.md. No bound relaxed.
2026-10-31 Bump Repo Skills 0.24.7 -> 0.25.1
    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
2026-11-06 sim: measure 3-diode stacked UVLO reference over 15 corners (negative result), add DR-0023
2026-11-06 refactor: hoist duplicated reference_measurements and claim progress/sigma helpers into script_helpers
    Move the identical reference_measurements body (indrv, output-stage taper) and
    the claim-measurement _progress_detail / _point_sigma_summary (indrv, inb) into
    sim/harness/script_helpers.py with unit tests. Drops the now-unused
    harness_runner import from the indrv and taper scripts. No sim/ records touched.
2026-11-07 Bump Repo Skills 0.25.1 -> 0.25.10
    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
2026-11-12 Bump Repo Skills 0.25.10 -> 0.26.1
    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
2026-11-13 refactor: route the Ron·W sample emitter through mc_to_yield's row selection
    `verification/signoff/derive_ronw_bound.py` carried its own copy of "which
    samples-*.csv rows are draws", and it had drifted from `sim/mc_to_yield.py`:
    it dropped a non-converged draw instead of keeping it as a `null` sample, so
    a non-converged draw would silently shrink the Ron·W population rather than
    counting against yield — exactly what mc_to_yield's stated convention forbids.
    It also selected rows on `float(sw_stat_mismatch) != 0` rather than
    `sw_stat_mismatch == "1"`, and had no test.
    The emitter now reads its draws and its deterministic control through
    `mc_to_yield.read_draws` / a new `mc_to_yield.read_c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
2026-11-13 chore: gitignore klt's .klt/ working state, document the tracked receipt
    klt writes a per-directory working tree at `.klt/` wherever it runs, and
    nothing ignored it, so a batch-submit receipt was swept into git in d72424f
    alongside the uvlo evidence. Add a `.klt/` rule next to the other
    scratch-directory rules so a future batch run from a tracked directory cannot
    add another one.
    The one already-tracked receipt stays. A `.gitignore` rule does not affect a
    tracked path, so no extra step is needed to keep it, and it is the only
    committed copy of the as-submitted `request_sha256` for job
    klt-sim-8453c410117b — the job behind the rail-stretch envelope that
    verification/signoff/manifest.json c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
2026-11-13 signoff: re-audit ci.yml and refresh the repo-hygiene inventory pins
    The PR adds a `run_*.py shared-helper unit tests` step to .github/workflows/
    ci.yml, which verification/signoff/repo-hygiene.inventory.md pins by sha256 as
    T1 item 10's audited CI artifact. The inventory was not refreshed, so
    check_tier_report.py's anchor pass failed on a stale listing (CI run
    43441985154, test CommittedTree.test_committed_manifest_is_anchored).
    Re-audited ci.yml against item 10's existing CI finding and refreshed the
    whole pin chain, which the inventory's own header describes:
    - repo-hygiene.inventory.md: the ci.yml listing now pins the live file, plus a
    dated re-read note for #429 in the convention of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
2026-11-13 fix: extend the append-only evidence check to artifact manifests
    `manifests/artifacts/README.md` stated that manifests are append-only
    evidence, but nothing enforced it: `check_append_only`'s `git diff
    --diff-filter=MD` was restricted to the `sim` pathspec and its path filter
    was `EVIDENCE_PATH_RE`, which matches only `sim/<slug>/...`. A branch could
    repoint a recorded run's `sha256` entries at different bytes, or delete a
    `layout-*` signoff manifest outright, and the `lint` job stayed green. For a
    manifest-backed record the manifest *is* the netlist snapshot and per-corner
    logs -- the bytes are not in git -- so that gap left stored evidence with no
    append-only guarantee at all.
    Widen the e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
2026-11-14 fix: render an ERROR record instead of crashing when no ronw draw converges
    `run_ronw_mismatch.py`'s `build_record_body` raised `TypeError: 'NoneType'
    object is not subscriptable` when no Monte Carlo draw converged at any PVT
    point. The verdict block handled that state and set `verdict = "ERROR"`, but
    the narrative section below it dereferenced the same `None` worst-excursion
    tuple unconditionally -- so a campaign in which ngspice never converged ended
    in a traceback after the whole grid had already run, writing nothing.
    Guard the narrative as a block, not per-dereference. `worst_excursion` is read
    at four sites, and guarding only the one in the traceback moves the crash to
    the `step_note`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
2026-11-14 refactor: share the per-node worst-case reduction and three ratified spec values
    The `indrv` and `taper` mismatch runners each carried a byte-identical
    14-line reduction — worst control and Monte Carlo value per taper node
    across every draw at every PVT point — and each declared `GATE_CEILING_V`,
    `EXCEPTION2_BOUND_V` and `TAPER_MEASUREMENTS` as its own literal.
    Hoist the reduction into `script_helpers.worst_across_points`, returning a
    `NodeWorstCase` row (name, ctrl_worst, mc_worst, delta, margin) and
    formatting nothing, so each runner keeps its own row emission unchanged —
    `indrv` prefixes `x2.` and adds its Exception 2 PASS/FAIL column, `taper`
    emits five columns with a bare node na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
2026-11-14 sim: add a Vbe/dVbe UVLO reference candidate and its 15-corner klt request
    Adds the second UVLO reference candidate for the record-0023 follow-up: a
    bandgap-type reference on pnp_05p00x05p00 substrate PNPs instead of a stack of
    diode-connected nfet_06v0, so the trip point no longer scales with N x Vgs.
    - uvlo_bandgap_ref.spice: PMOS-mirrored Vbe/dVbe core (Rsa/Rp = 275k/27k, the
    first-order zero-TC ratio), an nfet_06v0 loop amplifier with a MIM
    compensation cap, a startup kicker that breaks the degenerate zero-current
    state, and the comparator/buffer/MPD copied from design/netlist/uvlo.spice
    (only MTAIL's and MINN's gates move to the new bias/reference nodes).
    Divider re-valued to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
2026-11-14 sim: record the 15-corner Vbe/dVbe UVLO reference result (15/15 pass, 91 mV spread)
    The second UVLO reference study's measurement, plus the proposed decision
    record record 0023's Consequences section asks for.
    Result is positive: the Vbe/dVbe candidate passes 15 of 15 corners on both
    ratified windows, with a falling-trip spread of 91 mV (3.550-3.641 V) against
    2.51 V for the DR-0018 baseline and 2.47 V for the 3-diode candidate, and a
    worst-case rising trip of 3.988 V that clears the 4.50 V low-line floor by
    0.512 V -- the DR-0018 Finding 2 failure no prior candidate cleared. No
    errored corners, including fs/125C which errored for the 3-diode candidate.
    - envelopes/20261114-38154c7-...json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
2026-11-14 sim: pnp_05p00x05p00 is 3-terminal, not 4 (during evaluation)
    The limitations bullet called it 4-terminal; the PDK subckt is
    `.subckt pnp_05p00x05p00 c b e` (only the npn_* devices are `c b e s`),
    and uvlo_bandgap_ref.spice's own header already says "three-terminal".
